team-raiju/fujin/README.md

# Fujin

Fujin is a micromouse robot. This repository contains everything related to the project, see the respective folders for more information.
