team-raiju/fujin/.docs/bsp.png

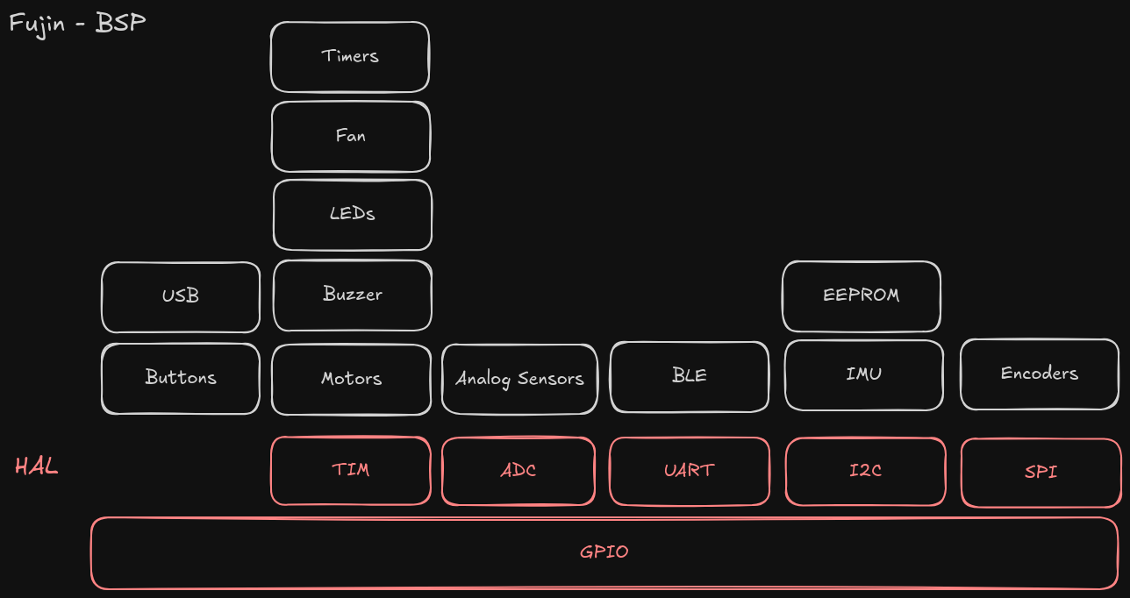
.docs/bsp.png
