team-raiju/fujin/boards/Fujin_Encoder/Fujin_Encoder.step

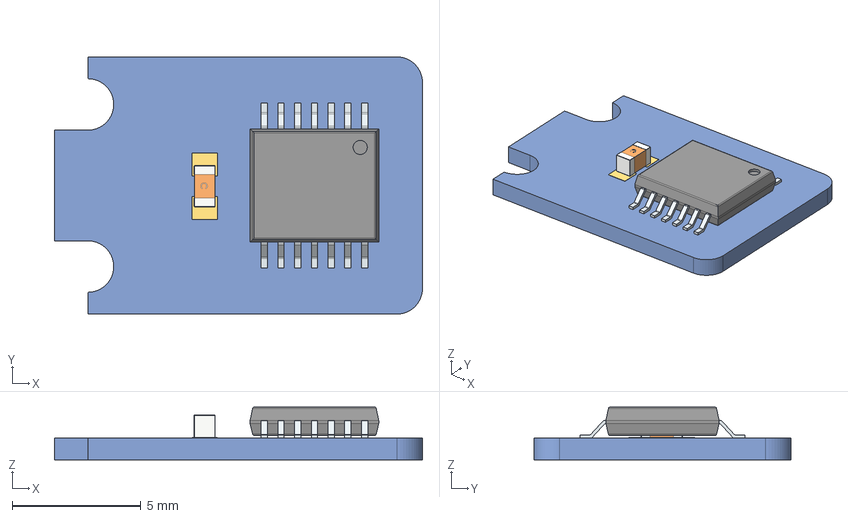
[picture p2: CAD file, 2024-06-20]
boards/Fujin_Encoder/Fujin_Encoder.step
14.3 x 10.0 x 2.05 mm
PinsArrayLR
User_Library-cap0603_pad_0603_??
User_Library-cap0603_cap0603_body(2)_??
