team-raiju/fujin/boards/Fujin_V1/Fujin_Body_4.DXF

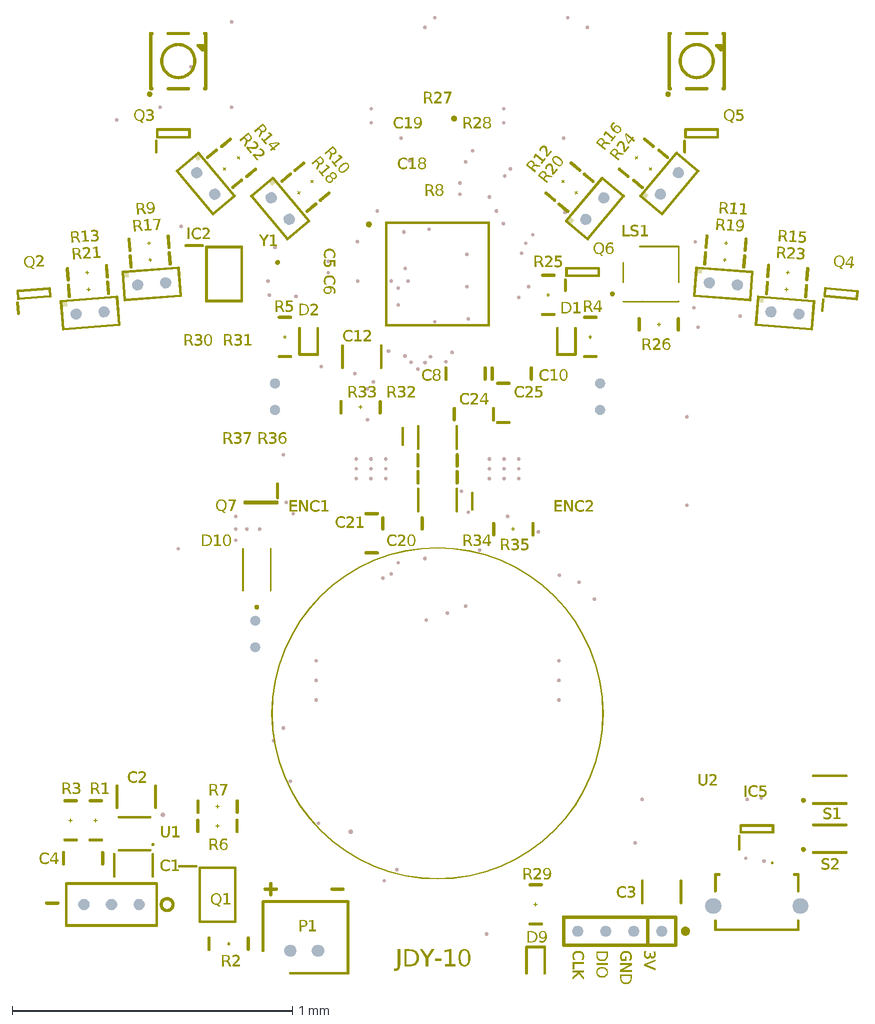
[picture p3: CAD file, 2024-06-19]
boards/Fujin_V1/Fujin_Body_4.DXF
ENC2
ENC1
3V
GND
DIO
CLK
R21
LS1
D10
P1
D2
D1
Y1
JDY-10
U2
U1
S2
S1
R37
R36
R35
R34
R33
R32
R31
R30
R29
R28
R27
R26
R25
R24
R23
R22
R20
R19
R18
R17
R16
R15
R14
R13
R12
R11
R10
R9
R8
R7
R6
R5
R4
R3
R2
R1
Q7
Q6
Q5
Q4
Q3
Q2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
