team-raiju/fujin/(list of files, cad)

Other CAD files:
boards/Fujin_V1/Fujin_Body.DWG
boards/Fujin_V1/Fujin_Body_2.DWG
