team-raiju/fujin/.agents/rules/compile-guide.md

---
trigger: always_on
---

# Compilation Instructions

```bash
cd firmware
cmake --preset STM32G474
cmake --build build/STM32G474
```
