team-raiju/fujin/firmware/.agents/rules/compile-guide.md

---
trigger: always_on
---

# Compilation Instructions

```bash
cmake --preset STM32G474
cmake --build build/STM32G474
```

You don't need to compile for target-pc
