team-raiju/fujin/boards/Fujin_V1/Fujin_EasyEDA_V1.pdf

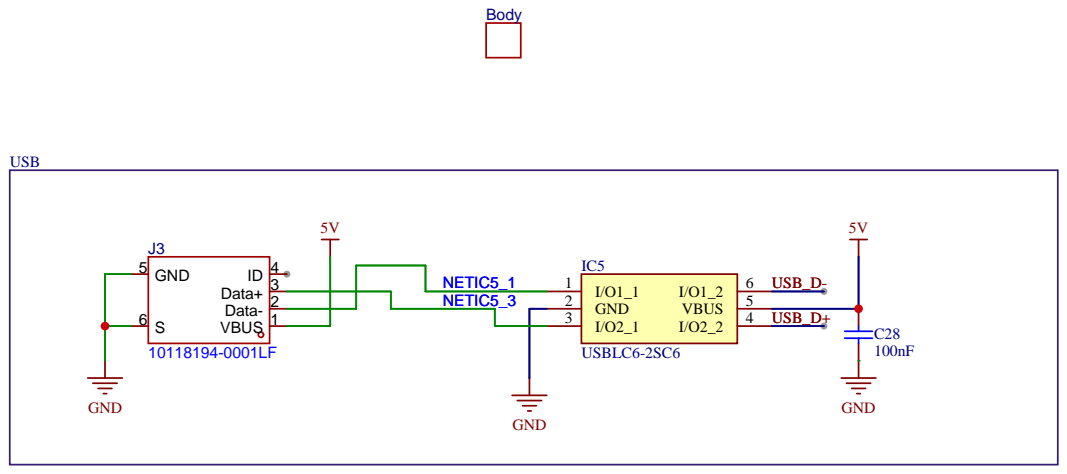
[picture p4: page 1]

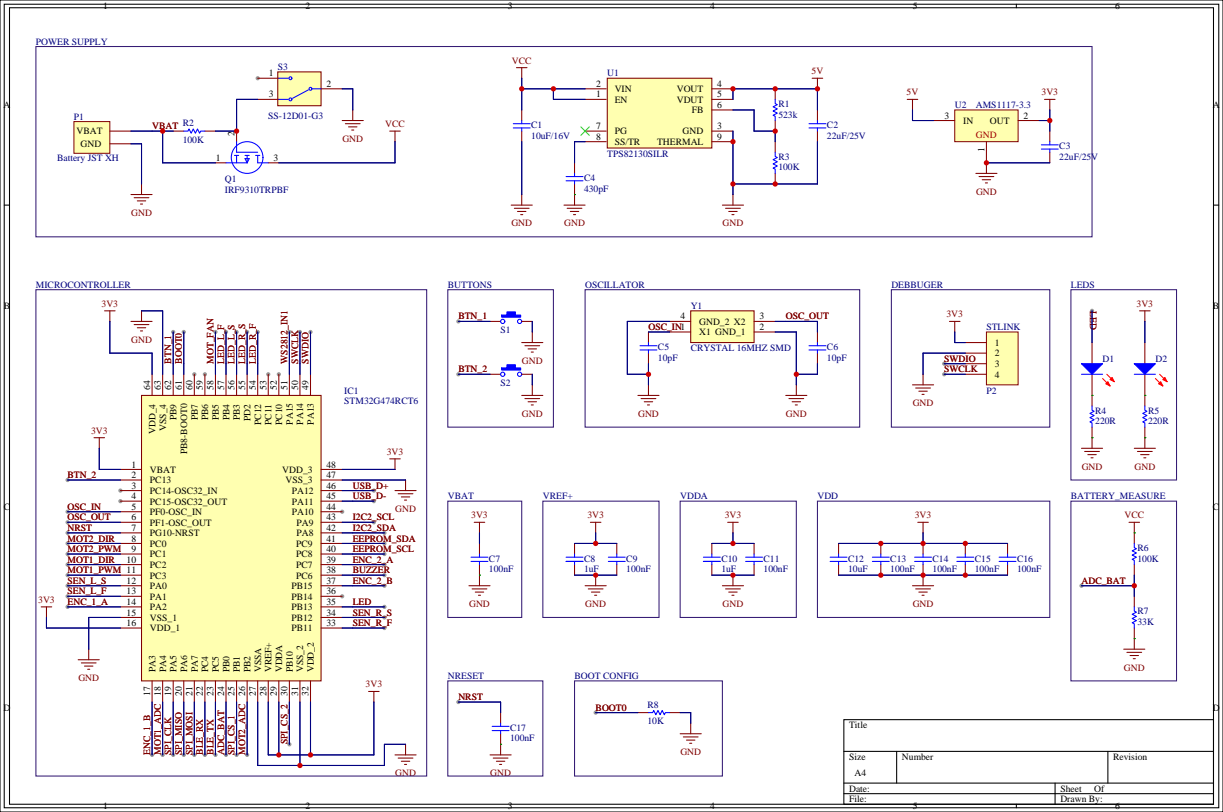
[picture p5: page 2]

# Motor Connector 12

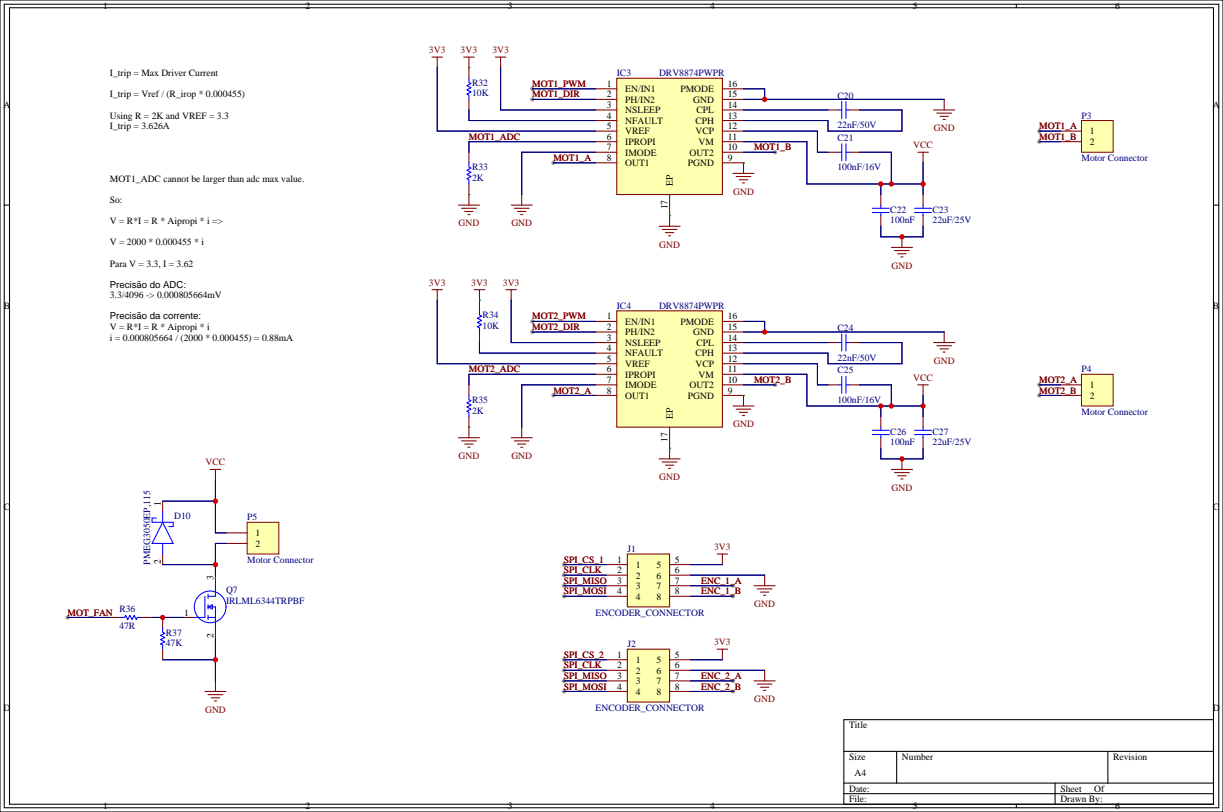
[picture p6: page 3]

MOT1_ADC cannot be larger than adc max value.

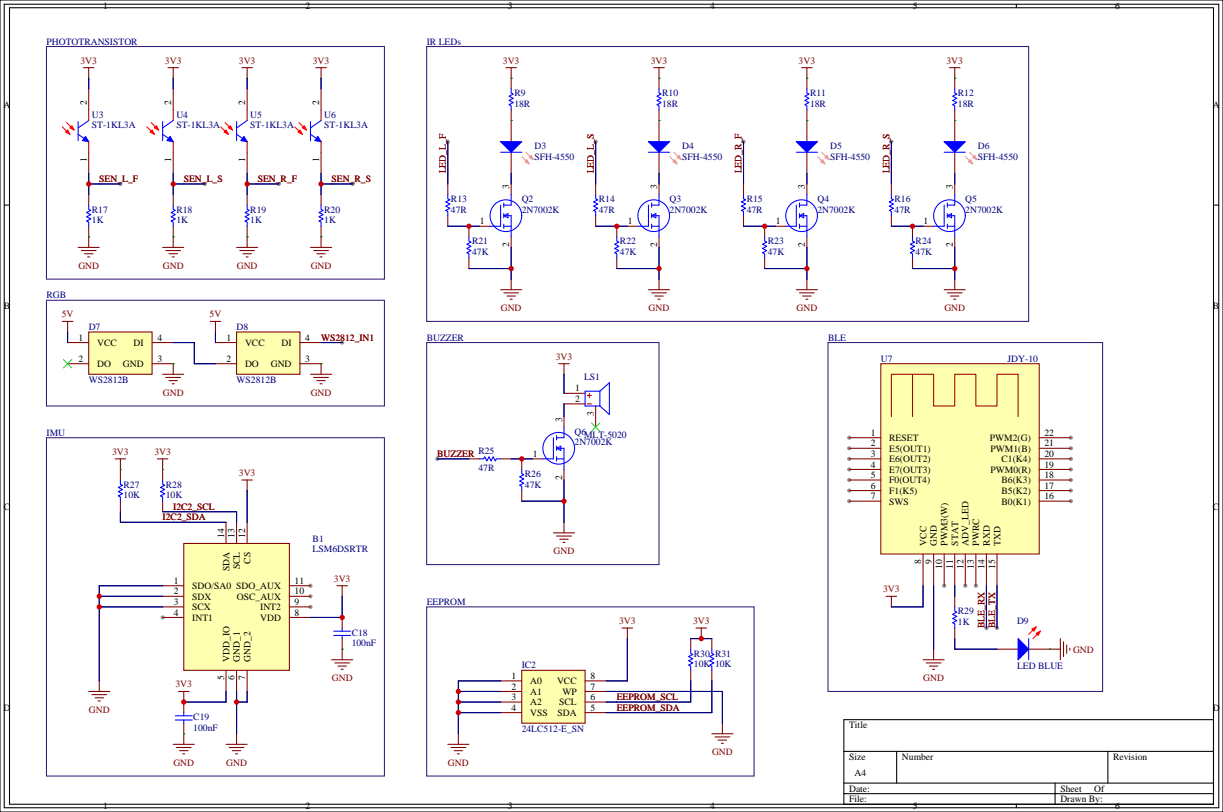
[picture p7: page 4]
