team-raiju/fujin/(list of files, drawings)

Other design files:
boards/Fujin_Encoder/EncoderLib.PcbLib
boards/Fujin_Encoder/EncoderLib.SchLib
boards/Fujin_Encoder/Fujin_Encoder.PcbDoc
boards/Fujin_Encoder/Fujin_Encoder.PrjPcb
boards/Fujin_Encoder/Fujin_Encoder.SchDoc
boards/Fujin_V1/Fujin_Body.PcbDoc
boards/Fujin_V1/Fujin_Connectors.SchDoc
boards/Fujin_V1/Fujin_Main.SchDoc
boards/Fujin_V1/Fujin_Motors.SchDoc
boards/Fujin_V1/Fujin_Peripherals.SchDoc
boards/Fujin_V1/Fujin_V1.PrjPcb
boards/Fujin_V1/FujinLib.SchLib
