team-raiju/fujin/firmware/cube/fujin.ioc

Mcu.UserName=STM32G474RCTx
PA0.Signal=ADC1_IN1
PA1.Signal=ADC1_IN2
PA11.Signal=USB_DM
PA12.Signal=USB_DP
PA13.Signal=SYS_JTMS-SWDIO
PA14.Signal=SYS_JTCK-SWCLK
PA15.Signal=S_TIM2_CH1
PA2.Signal=GPXTI2
PA3.Signal=GPIO_Input
PA4.Signal=ADC2_IN17
PA5.Signal=SPI1_SCK
PA6.Signal=SPI1_MISO
PA7.Signal=SPI1_MOSI
PA8.Signal=I2C2_SDA
PA9.Signal=I2C2_SCL
PB0.Signal=ADC1_IN15
PB1.Signal=GPIO_Output
PB10.Signal=GPIO_Output
PB11.Signal=ADC1_IN14
PB12.Signal=ADC1_IN11
PB13.Signal=GPIO_Output
PB15.Signal=GPIO_Input
PB2.Signal=ADC2_IN12
PB3.Signal=GPIO_Output
PB4.Signal=GPIO_Output
PB5.Signal=S_TIM3_CH2
PB9.Signal=GPXTI9
PC0.Signal=GPIO_Output
PC1.Signal=S_TIM1_CH2
PC12.Signal=GPIO_Output
PC13.Signal=GPXTI13
PC2.Signal=GPIO_Output
PC3.Signal=S_TIM1_CH4
PC4.Signal=USART1_TX
PC5.Signal=USART1_RX
PC6.Signal=S_TIM8_CH1
PC7.Signal=GPXTI7
PC8.Signal=I2C3_SCL
PC9.Signal=I2C3_SDA
PD2.Signal=GPIO_Output
PF0-OSC_IN.Signal=RCC_OSC_IN
PF1-OSC_OUT.Signal=RCC_OSC_OUT
