team-raiju/fujin/firmware/src/services/control.cpp

#include <algorithm>
#include <cstdio>

#include "bsp/analog_sensors.hpp"
#include "bsp/encoders.hpp"
#include "bsp/fan.hpp"
#include "bsp/imu.hpp"
#include "bsp/motors.hpp"
#include "bsp/timers.hpp"
#include "services/config.hpp"
#include "services/control.hpp"

#ifndef COMPETITION_MODE
#define COMPETITION_MODE 0
#endif

#if COMPETITION_MODE
static constexpr float MAX_LINEAR_SPEED_ERROR = 1.0f;
static constexpr float MAX_ANGULAR_SPEED_ERROR = 12.0f;
#else
static constexpr float MAX_LINEAR_SPEED_ERROR = 0.8f;
static constexpr float MAX_ANGULAR_SPEED_ERROR = 10.0f;
#endif

static constexpr float max_battery_voltage = 12.6;
static constexpr float mot_kt = 0.0064;                // motor torque constant [Nm/A]
static constexpr float mot_ra = 2.5;                   // armature resistance[Ohms]
static constexpr float max_linear_accel_ff = 50.0f;    // max linear acceleration for feedforward [m/s^2]
static constexpr float max_angular_accel_ff = 2000.0f; // max angular acceleration for feedforward [rad/s^2]

namespace services {

Control* Control::instance() {
    static Control p;
    return &p;
}

void Control::init(void) {
    GeneralParams general_params = {
        services::Config::fan_speed,
        services::Config::angular_kp,
        services::Config::angular_ki,
        services::Config::angular_kd,
        services::Config::angular_acc_feed_forward_k,
        services::Config::angular_brake_feed_forward_k,
        services::Config::angular_vel_feed_forward_k,
        services::Config::linear_vel_acc_feed_forward_k,
        services::Config::linear_vel_brake_feed_forward_k,
        services::Config::linear_vel_feed_forward_k,
        services::Config::wall_kp,
        services::Config::wall_ki,
        services::Config::wall_kd,
        services::Config::linear_vel_kp,
        services::Config::linear_vel_ki,
        services::Config::linear_vel_kd,
        services::Config::diagonal_walls_kp,
        services::Config::diagonal_walls_ki,
        services::Config::diagonal_walls_kd,
        services::Config::start_wall_break_mm_left,
        services::Config::start_wall_break_mm_right,
        services::Config::enable_wall_break_correction,
        services::Config::max_linear_acc_jerk,
        services::Config::max_linear_brake_jerk,
        services::Config::wheel_radius_mm,
        services::Config::coulomb_ff,
        services::Config::angular_coulomb_ff,
        services::Config::angular_static_ff,
        services::Config::angular_coulomb_ff_inplace,
        services::Config::angular_static_ff_inplace,
        services::Config::linear_accel_margin_mm,
        services::Config::linear_brake_margin_mm,
        services::Config::sensor_r_slope_max_th,
        services::Config::sensor_l_slope_max_th,
        services::Config::ir_wall_detect_th_left,
        services::Config::ir_wall_detect_th_right,
        services::Config::enable_lateral_correction_90,
        services::Config::enable_lateral_correction_wall,
    };
    reset(general_params);
}

void Control::reset(GeneralParams general_params) {
    params = general_params;

    linear_vel_pid.reset();
    linear_vel_pid.kp = params.linear_vel_kp;
    linear_vel_pid.ki = params.linear_vel_ki;
    linear_vel_pid.kd = params.linear_vel_kd;
    linear_vel_pid.integral_limit = 100;
    linear_vel_pid.derivative_filter = 0.15f;

    angular_vel_pid.reset();
    angular_vel_pid.kp = params.angular_kp;
    angular_vel_pid.ki = params.angular_ki;
    angular_vel_pid.kd = params.angular_kd;
    angular_vel_pid.integral_limit = 500;
    angular_vel_pid.derivative_filter = 0.15f;

    walls_pid.reset();
    walls_pid.kp = params.wall_kp;
    walls_pid.ki = params.wall_ki;
    walls_pid.kd = params.wall_kd;
    walls_pid.integral_limit = 0;
    walls_pid.derivative_filter = 1.0f;

    diagonal_walls_pid.reset();
    diagonal_walls_pid.kp = params.diagonal_walls_kp;
    diagonal_walls_pid.ki = params.diagonal_walls_ki;
    diagonal_walls_pid.kd = params.diagonal_walls_kd;
    diagonal_walls_pid.integral_limit = 0;
    diagonal_walls_pid.derivative_filter = 1.0f;

    target_angular_speed_rad_s = 0;
    last_target_angular_speed_rad_s = 0;
    target_linear_speed_m_s = 0;
    last_target_linear_speed_m_s = 0;
    target_linear_acceleration = 0.0f;
    last_target_linear_acceleration = 0.0f;
    target_angular_acceleration = 0.0f;
    last_target_angular_acceleration = 0.0f;
    rotation_ff = 0.0f;
    fan_pwm = 0.0f;

    motor_control_disabled = false;
    emergency = false;
    use_inplace_friction = false;
    wall_pid_enabled = false;
    diagonal_pid_enabled = false;
}

void Control::update() {

    float bat_volts = bsp::analog_sensors::battery_latest_reading_volts();

    if (motor_control_disabled) {
        bsp::motors::set(0, 0);
        pwm_duty_l = 0.0f;
        pwm_duty_r = 0.0f;
        rotation_ff = 0.0f;
        linear_ff = 0.0f;
        linear_vel_pid.reset();
        angular_vel_pid.reset();
        last_target_angular_speed_rad_s = target_angular_speed_rad_s;
        last_target_linear_speed_m_s = target_linear_speed_m_s;
        target_linear_acceleration = 0.0f;
        last_target_linear_acceleration = 0.0f;
        target_angular_acceleration = 0.0f;
        last_target_angular_acceleration = 0.0f;
    } else {
        float mean_velocity_m_s = bsp::encoders::get_filtered_velocity_m_s();
        auto angular_speed_error_raw = std::abs(target_angular_speed_rad_s - bsp::imu::get_rad_per_s());
        auto linear_speed_error = std::abs(target_linear_speed_m_s - mean_velocity_m_s);
        emergency =
            ((linear_speed_error > MAX_LINEAR_SPEED_ERROR) || (angular_speed_error_raw > MAX_ANGULAR_SPEED_ERROR));

        if (wall_pid_enabled) {
            const float max_wall_ang_accel = (params.fan_speed > 0) ? 500.0f : 150.0f; // rad/s^2
            const float max_step = max_wall_ang_accel / Config::CONTROL_FREQUENCY_HZ;

            target_angular_speed_rad_s += walls_pid.calculate(0.0f, bsp::analog_sensors::ir_side_wall_error());
            target_angular_speed_rad_s =
                std::clamp(target_angular_speed_rad_s, (last_target_angular_speed_rad_s - max_step),
                           (last_target_angular_speed_rad_s + max_step));
        }

        if (diagonal_pid_enabled) {
            target_angular_speed_rad_s += diagonal_walls_pid.calculate(0.0, bsp::analog_sensors::ir_diagonal_error());
        }

        float linear_ratio = linear_vel_pid.calculate(target_linear_speed_m_s, mean_velocity_m_s);
        float rotation_ratio = -angular_vel_pid.calculate(target_angular_speed_rad_s, bsp::imu::get_rad_per_s());

        // Angular Feed-Foward
        target_angular_acceleration =
            (target_angular_speed_rad_s - last_target_angular_speed_rad_s) * Config::CONTROL_FREQUENCY_HZ;
        target_angular_acceleration =
            std::clamp(target_angular_acceleration, -max_angular_accel_ff, max_angular_accel_ff);

        last_target_angular_acceleration = target_angular_acceleration;

        bool is_accelerating = (target_angular_speed_rad_s * target_angular_acceleration) > 0.0f;
        float dir = (target_angular_speed_rad_s > 0.0f) ? 1.0f : -1.0f;

        if (is_accelerating) {
            rotation_ff = target_angular_acceleration * params.angular_acc_feed_forward_k;
        } else {
            rotation_ff = target_angular_acceleration * params.angular_brake_feed_forward_k;
        }
        rotation_ff += target_angular_speed_rad_s * params.angular_vel_feed_forward_k;

        // Friction feedforward: in-place vs rolling (only enabled when not fixing walls, e.g. during turns)
        if (!wall_pid_enabled && !diagonal_pid_enabled) {
            const float static_ff = (use_inplace_friction && params.angular_static_ff_inplace > 0.0f)
                                        ? params.angular_static_ff_inplace
                                        : params.angular_static_ff;
            const float coulomb_ff = (use_inplace_friction && params.angular_coulomb_ff_inplace > 0.0f)
                                         ? params.angular_coulomb_ff_inplace
                                         : params.angular_coulomb_ff;

            // Static friction
            if (is_accelerating && std::abs(bsp::imu::get_rad_per_s()) < 0.4f &&
                std::abs(target_angular_acceleration) > 0.1f) {
                rotation_ff += static_ff * dir;
            } // Dynamic friction
            else if (std::abs(target_angular_speed_rad_s) > 0.005f) {
                rotation_ff += coulomb_ff * dir;
            }
        }

        last_target_angular_speed_rad_s = target_angular_speed_rad_s;

        // Linear Feed-Foward
        if (std::abs(target_linear_speed_m_s) <= 0.001f) {
            target_linear_acceleration = 0.0f;
            linear_ff = 0.0f;
        } else {
            target_linear_acceleration =
                (target_linear_speed_m_s - last_target_linear_speed_m_s) * Config::CONTROL_FREQUENCY_HZ;
            target_linear_acceleration =
                std::clamp(target_linear_acceleration, -max_linear_accel_ff, max_linear_accel_ff);

            if (target_linear_acceleration >= 0.0f) {
                linear_ff = target_linear_acceleration * params.linear_vel_acc_feed_forward_k;
            } else {
                linear_ff = target_linear_acceleration * params.linear_vel_brake_feed_forward_k;
            }

            // Coulomb ff
            float direction = (target_linear_speed_m_s > 0.0f) ? 1.0f : -1.0f;
            linear_ff += params.coulomb_ff * direction;

            linear_ff += target_linear_speed_m_s * params.linear_vel_feed_forward_k;
        }

        last_target_linear_acceleration = target_linear_acceleration;
        last_target_linear_speed_m_s = target_linear_speed_m_s;

        // Control
        float l_current = (linear_ratio + linear_ff) + (rotation_ratio - rotation_ff);
        float r_current = (linear_ratio + linear_ff) - (rotation_ratio - rotation_ff);

        float left_ang_vel = bsp::encoders::get_left_filtered_ang_vel_rad_s();
        float right_ang_vel = bsp::encoders::get_right_filtered_ang_vel_rad_s();

        pwm_duty_l = ((l_current * mot_ra + left_ang_vel * mot_kt) / bat_volts) * 1000;
        pwm_duty_r = ((r_current * mot_ra + right_ang_vel * mot_kt) / bat_volts) * 1000;

        std::tie(pwm_duty_l, pwm_duty_r) = clamp_pwms(pwm_duty_l, pwm_duty_r);

        bsp::motors::set(pwm_duty_l, pwm_duty_r);
    }

    fan_control_update(bat_volts);
}

std::pair<int16_t, int16_t> Control::clamp_pwms(int16_t pwm_l, int16_t pwm_r) {
    if (pwm_l > bsp::motors::COUNTER_PERIOD_MAX || pwm_r > bsp::motors::COUNTER_PERIOD_MAX) {
        uint32_t abs_diff = std::abs(pwm_l - pwm_r);
        abs_diff = std::min(abs_diff, static_cast<uint32_t>(2.0 * bsp::motors::COUNTER_PERIOD_MAX));
        if (pwm_l > pwm_r) {
            pwm_l = bsp::motors::COUNTER_PERIOD_MAX;
            pwm_r = bsp::motors::COUNTER_PERIOD_MAX - abs_diff;
        } else {
            pwm_l = bsp::motors::COUNTER_PERIOD_MAX - abs_diff;
            pwm_r = bsp::motors::COUNTER_PERIOD_MAX;
        }
    }

    if (pwm_l < -bsp::motors::COUNTER_PERIOD_MAX || pwm_r < -bsp::motors::COUNTER_PERIOD_MAX) {
        uint32_t abs_diff = std::abs(pwm_l - pwm_r);
        abs_diff = std::min(abs_diff, static_cast<uint32_t>(2.0 * bsp::motors::COUNTER_PERIOD_MAX));

        if (pwm_l < pwm_r) {
            pwm_l = -bsp::motors::COUNTER_PERIOD_MAX;
            pwm_r = -bsp::motors::COUNTER_PERIOD_MAX + abs_diff;
        } else {
            pwm_l = -bsp::motors::COUNTER_PERIOD_MAX + abs_diff;
            pwm_r = -bsp::motors::COUNTER_PERIOD_MAX;
        }
    }

    return {pwm_l, pwm_r};
}

void Control::fan_control_update(float bat_volts) {

    float target_fan_speed = std::min(params.fan_speed, static_cast<float>(bsp::fan::MAX_SPEED));
    float desired_fan_voltage =
        (target_fan_speed / static_cast<float>(bsp::fan::MAX_SPEED)) * bsp::fan::get_max_fan_voltage();

    if (bat_volts > 5.0) { // To avoid turning on fan when battery measurement is not reliable
        fan_pwm = (desired_fan_voltage / bat_volts) * bsp::fan::MAX_SPEED;
    } else {
        fan_pwm = 0;
    }
    bsp::fan::set(fan_pwm);
}

void Control::start_fan() {
    float target_fan_speed = std::min(params.fan_speed, static_cast<float>(bsp::fan::MAX_SPEED));
    float desired_fan_voltage =
        (target_fan_speed / static_cast<float>(bsp::fan::MAX_SPEED)) * bsp::fan::get_max_fan_voltage();

    for (float volts = 0; volts < desired_fan_voltage; volts += 0.1) {
        float bat_volts = bsp::analog_sensors::battery_latest_reading_volts();
        if (bat_volts < 5.0) {
            std::printf("Low battery: %f V\r\n", bat_volts);
            bsp::fan::set(0);
            break;
        }
        fan_pwm = (volts / bat_volts) * bsp::fan::MAX_SPEED;
        std::printf("volts: %f, bat: %f, pwm: %d\r\n", volts, bat_volts, fan_pwm);
        bsp::fan::set(fan_pwm);
        bsp::delay_ms(20);
    }
}

void Control::stop_fan() {
    float target_fan_speed = std::min(params.fan_speed, static_cast<float>(bsp::fan::MAX_SPEED));
    float desired_fan_voltage =
        (target_fan_speed / static_cast<float>(bsp::fan::MAX_SPEED)) * bsp::fan::get_max_fan_voltage();
    for (float volts = desired_fan_voltage; volts > 0; volts -= 0.1) {
        float bat_volts = bsp::analog_sensors::battery_latest_reading_volts();
        if (bat_volts < 5.0) {
            bsp::fan::set(0);
            break;
        }
        fan_pwm = (volts / bat_volts) * bsp::fan::MAX_SPEED;
        bsp::fan::set(fan_pwm);
        bsp::delay_ms(20);
    }
    bsp::fan::set(0);
}

}
