team-raiju/fujin/firmware/src/bsp/target-stm32g474/encoders.cpp

#include <algorithm>
#include "st/hal.h"

#include "bsp/encoders.hpp"
#include "bsp/timers.hpp"
#include "pin_mapping.h"
#include "services/config.hpp"

namespace bsp::encoders {

// Min measured vel is ENCODER_DIST_MM_PULSE / 10 = 0.00776 m/s
static constexpr uint32_t MAX_TIME_WITHOUT_ENCODER_US = 10000;

static constexpr float WHEEL_TO_ENCODER_RATIO = (1.0);
static constexpr float ENCODER_PPR = (1024.0);
static constexpr float PULSES_PER_WHEEL_ROTATION = (WHEEL_TO_ENCODER_RATIO * ENCODER_PPR);


static float linear_velocity_m_s;
static float wheel_radius_mm = 13.25f;

static float filtered_velocity_m_s;
static float last_velocity_m_s;

static float right_filtered_ang_vel_rad_s;
static float left_filtered_ang_vel_rad_s;

static uint32_t last_update_vel_time;
static uint32_t delta_vel_time;

static EncoderData left_encoder;
static EncoderData right_encoder;

static float estimated_vel_m_s = 0.0f;
static float accel_bias_m_s2 = 0.0f;


/// @section Private implementation


// Hybrid alpha-beta filter with target acceleration feedforward + EMA post-filter
static inline float update_velocity_filter(float raw_vel_m_s, float target_accel_m_s2) {
    constexpr float alpha_vel_gain = 0.030f;
    constexpr float beta_acc_gain = 0.2000f;
    constexpr float smooth_factor = 0.30f;
    constexpr float bias_decay = 0.995f;
    constexpr float max_accel_bias = 10.0f;

    float predicted_accel = target_accel_m_s2 + accel_bias_m_s2;
    float predicted_vel = estimated_vel_m_s + predicted_accel * services::Config::CONTROL_PERIOD_S;
    float vel_estimated_error = raw_vel_m_s - predicted_vel;

    estimated_vel_m_s = predicted_vel + alpha_vel_gain * vel_estimated_error;
    accel_bias_m_s2 = std::clamp((accel_bias_m_s2 + beta_acc_gain * vel_estimated_error) * bias_decay,
                                 -max_accel_bias, max_accel_bias);

    // Post filter (EMA) 
    // filtered_velocity_m_s = (smooth_factor * estimated_vel_m_s) + (1 - smooth_factor) * filtered_velocity_m_s => equivalent to;
    filtered_velocity_m_s += smooth_factor * (estimated_vel_m_s - filtered_velocity_m_s);
    return filtered_velocity_m_s;
}


/// @section Interface implementation

void init() {
    reset();
}

void reset() {
    left_encoder = {0, DirectionType::CW, 0, MAX_TIME_WITHOUT_ENCODER_US + 1, 0, 0};
    right_encoder = {0, DirectionType::CW, 0, MAX_TIME_WITHOUT_ENCODER_US + 1, 0, 0};
    reset_velocities();
}

void clear_ticks() {
    left_encoder.ticks = 0;
    right_encoder.ticks = 0;
}

EncoderData get_data(EncoderSide side) {
    return side == LEFT ? left_encoder : right_encoder;
}

void gpio_exti_callback(uint16_t GPIO_Pin) {
    uint32_t current_time_us = bsp::get_tick_us();

    if (GPIO_Pin == ENCODER_LEFT_A_PIN) {

        left_encoder.last_delta_tick_time = current_time_us - left_encoder.last_update_tick_time;
        left_encoder.last_update_tick_time = current_time_us;
        left_encoder.direction = HAL_GPIO_ReadPin(ENCODER_LEFT_B_PORT, ENCODER_LEFT_B_PIN) == GPIO_PIN_SET ? CCW : CW;
        left_encoder.ticks = left_encoder.direction == CW ? left_encoder.ticks - 1 : left_encoder.ticks + 1;

    } else if (GPIO_Pin == ENCODER_RIGHT_A_PIN) {

        right_encoder.last_delta_tick_time = current_time_us - right_encoder.last_update_tick_time;
        right_encoder.last_update_tick_time = current_time_us;
        right_encoder.direction =
            HAL_GPIO_ReadPin(ENCODER_RIGHT_B_PORT, ENCODER_RIGHT_B_PIN) == GPIO_PIN_SET ? CW : CCW;
        right_encoder.ticks = right_encoder.direction == CW ? right_encoder.ticks - 1 : right_encoder.ticks + 1;
    }
}

void update_ticks() {}

void reset_velocities() {
    linear_velocity_m_s = 0;
    filtered_velocity_m_s = 0;
    last_velocity_m_s = 0;
    right_filtered_ang_vel_rad_s = 0;
    left_filtered_ang_vel_rad_s = 0;
    last_update_vel_time = 0;
    delta_vel_time = MAX_TIME_WITHOUT_ENCODER_US + 1;

    estimated_vel_m_s = 0.0f;
    accel_bias_m_s2 = 0.0f;

}

void set_right_ang_vel_rad_s(float speed) {
    right_encoder.ang_vel_rad_s = speed;
    right_filtered_ang_vel_rad_s = speed * 0.1 + right_filtered_ang_vel_rad_s * 0.9;
}

void set_left_ang_vel_rad_s(float speed) {
    left_encoder.ang_vel_rad_s = speed;
    left_filtered_ang_vel_rad_s = speed * 0.1 + left_filtered_ang_vel_rad_s * 0.9;
}

void update_velocities(float target_accel_m_s2) {

    delta_vel_time = bsp::get_tick_us() - last_update_vel_time;
    last_update_vel_time = bsp::get_tick_us();

    if (left_encoder.last_delta_tick_time == 0 || right_encoder.last_delta_tick_time == 0) {
        return;
    }

    uint32_t delta_time_tick_left = bsp::get_tick_us() - left_encoder.last_update_tick_time;
    uint32_t delta_time_tick_right = bsp::get_tick_us() - right_encoder.last_update_tick_time;

    float encoder_dist_mm_pulse = get_encoder_dist_mm_pulse();
    float wheel_radius_m = wheel_radius_mm / 1000.0f;

    /* Left wheel */
    if (delta_time_tick_left > MAX_TIME_WITHOUT_ENCODER_US) {
        left_encoder.linear_vel_m_s = 0;
    } else {
        int32_t ticks = left_encoder.ticks;
        if (ticks == 0) { // No tick detected in the last delta_vel_time (e.g 1ms)
            left_encoder.linear_vel_m_s = 0;
        } else {
            left_encoder.linear_vel_m_s = ((ticks * encoder_dist_mm_pulse) / (float)delta_vel_time) * MM_PER_US_TO_M_PER_S;
        }
        
    }

    /* Right wheel */
    if (delta_time_tick_right > MAX_TIME_WITHOUT_ENCODER_US) {
        right_encoder.linear_vel_m_s = 0;
    } else {
        int32_t ticks = right_encoder.ticks;
        if (ticks == 0) { // No tick detected in the last delta_vel_time (e.g 1ms)
            right_encoder.linear_vel_m_s = 0;
        } else {
            right_encoder.linear_vel_m_s = ((ticks * encoder_dist_mm_pulse) / (float)delta_vel_time) * MM_PER_US_TO_M_PER_S;
        }

    }

    set_left_ang_vel_rad_s(left_encoder.linear_vel_m_s / wheel_radius_m);
    set_right_ang_vel_rad_s(right_encoder.linear_vel_m_s / wheel_radius_m);

    linear_velocity_m_s = (left_encoder.linear_vel_m_s + right_encoder.linear_vel_m_s) / 2.0;

    // filtered_velocity_m_s = linear_velocity_m_s * 0.051 + filtered_velocity_m_s * 0.949; // Simple Filter
    filtered_velocity_m_s = update_velocity_filter(linear_velocity_m_s, target_accel_m_s2);
    last_velocity_m_s = linear_velocity_m_s;
}

float get_linear_velocity_m_s() {
    return linear_velocity_m_s;
}

float get_left_linear_velocity_m_s() {
    return left_encoder.linear_vel_m_s;
}

float get_right_linear_velocity_m_s() {
    return right_encoder.linear_vel_m_s;
}

float get_filtered_velocity_m_s() {
    return filtered_velocity_m_s;
}

float get_right_filtered_ang_vel_rad_s() {
    return right_filtered_ang_vel_rad_s;
}

float get_left_filtered_ang_vel_rad_s() {
    return left_filtered_ang_vel_rad_s;
}

float get_encoder_dist_mm_pulse() {
    float wheel_perimeter_mm = (M_TWOPI * wheel_radius_mm);
    return (wheel_perimeter_mm / PULSES_PER_WHEEL_ROTATION);
}

void set_wheel_radius_mm(float radius_mm) {
    wheel_radius_mm = radius_mm;
}

float get_wheel_radius_mm() {
    return wheel_radius_mm;
}

}
