team-raiju/fujin/firmware/inc/services/config.hpp

#pragma once

#include "bsp/analog_sensors.hpp"
#include "bsp/ble.hpp"

namespace services {

class Config {
public:

    static constexpr float CONTROL_FREQUENCY_HZ = 2000.0;
    static constexpr float CONTROL_PERIOD_S = 1.0 / CONTROL_FREQUENCY_HZ;
    static constexpr float TICKS_PER_MS = CONTROL_FREQUENCY_HZ / 1000.0f;
    static constexpr uint16_t ms_to_ticks(float ms) { return static_cast<uint16_t>(ms * TICKS_PER_MS); }
    static constexpr float ticks_to_ms(uint32_t ticks) { return ticks / TICKS_PER_MS; }

    static constexpr float WHEELS_DIST_MM = (70.0);


    static float fan_speed;

    static float angular_kp;
    static float angular_ki;
    static float angular_kd;
    static float angular_acc_feed_forward_k;
    static float angular_brake_feed_forward_k;
    static float angular_vel_feed_forward_k;

    static float linear_vel_acc_feed_forward_k;
    static float linear_vel_brake_feed_forward_k;
    static float linear_vel_feed_forward_k;
    static float max_linear_acc_jerk;
    static float max_linear_brake_jerk;
    static float wheel_radius_mm;
    static float coulomb_ff;
    static float angular_coulomb_ff;
    static float angular_static_ff;
    static float angular_coulomb_ff_inplace;
    static float angular_static_ff_inplace;

    static float wall_kp;
    static float wall_ki;
    static float wall_kd;

    static float linear_vel_kp;
    static float linear_vel_ki;
    static float linear_vel_kd;

    static float diagonal_walls_kp;
    static float diagonal_walls_ki;
    static float diagonal_walls_kd;

    static float min_move_speed;

    static float ir_wall_dist_ref_left;
    static float ir_wall_dist_ref_right;
    static float ir_wall_detect_th_left;
    static float ir_wall_detect_th_right;

    static float ir_diagonal_ref_fl;
    static float ir_diagonal_ref_fr;
    static float ir_diagonal_control_th_fl;
    static float ir_diagonal_control_th_fr;

    static float sensor_r_slope_max_th;
    static float sensor_l_slope_max_th;
    static float right_sensor_angle_deg;
    static float left_sensor_angle_deg;

    static float z_imu_bias;

    static float start_wall_break_mm_left;
    static float start_wall_break_mm_right;
    static float enable_wall_break_correction;
    static float enable_lateral_correction_90;
    static float enable_lateral_correction_wall;
    static float linear_accel_margin_mm;
    static float linear_brake_margin_mm;

    static void init();
    static int parse_packet(uint8_t packet[bsp::ble::max_packet_size]);
    static int parse_movement_packet(uint8_t packet[bsp::ble::max_packet_size]);
    static int load_movement_preset(uint8_t preset_id);
    static int load_general_preset(uint8_t preset_id);
    static int parse_move_sequence_packet(uint8_t packet[bsp::ble::max_packet_size]);
    static int write_default_params();
    static int save_general_params_to_eeprom();
    static int write_all_move_params_to_eeprom();
    static int write_turn_param_to_eeprom(Movement movement_id);
    static int write_forward_param_to_eeprom(Movement movement_id);
    static void send_parameters();
    static void print_parameters();
    static void send_movement_parameters();
    static void send_move_sequence();
    static int save_z_bias();
    static void load_custom_movements_from_eeprom();
    static void load_movement_sequence_from_eeprom();
    static void load_ir_calib_from_eeprom();
    static int save_ir_calib_to_eeprom(bsp::analog_sensors::SensingDirection direction);
    static int save_all_ir_calib_to_eeprom();
    static void load_ir_wall_patterns_from_eeprom();
    static int save_ir_wall_pattern_to_eeprom(uint8_t pattern_idx);
    static int save_all_ir_wall_patterns_to_eeprom();
    static int reset_ir_wall_patterns_in_eeprom();
};

}
