team-raiju/fujin/firmware/src/bsp/target-stm32g474/analog_sensors.cpp

#include <algorithm>
#include <cmath>
#include <cstring>

#include "st/hal.h"

#include "bsp/analog_sensors.hpp"
#include "bsp/leds.hpp"
#include "bsp/timers.hpp"
#include "services/config.hpp"
#include "utils/math.hpp"

namespace bsp::analog_sensors {

namespace {

/*
 * Battery Sensor - ADC1 CH15
 * Phototransistors - ADC1 CH 1, 2, 11, 14
 * Current Sensors - ADC2 CH 12, 17
 */

/// @section Constants

/* With ADC clock = PCLK/4 (42.5 MHz), 5 channels, and 24.5 sample cycles (37 cycles/conv):
 * - 1 conversion: 37 / 42.5 MHz = 0.87 us
 * - 1 scan (5 ch): 185 / 42.5 MHz = 4.35 us
 * - Half-buffer (22 scans): 22 * 4.35 us = ~95.8 us per DMA interrupt (phase duration)
 * - Full 5-phase modulation cycle (OFF + 4 individual ON): 5 * 95.8 us = ~479 us (~2.09 kHz <= 500 us)
 * - EMA filter (alpha = 0.5): group delay = 1 * 479 us = ~479 us (90% settling: ~1.59 ms)
 */
constexpr uint16_t ADC_1_DMA_CHANNELS = 5;
constexpr uint16_t READINGS_PER_ADC_1 = 44;
constexpr uint16_t ADC_1_DMA_BUFFER_SIZE = ADC_1_DMA_CHANNELS * READINGS_PER_ADC_1;
constexpr uint16_t ADC_1_DMA_HALF_BUFFER_SIZE = ADC_1_DMA_BUFFER_SIZE / 2;

/* With these settings and ADC clock = CLK/4 and sample cycles = 24.5*/
/* We have 1 sample per 28us*/
constexpr uint16_t ADC_2_DMA_CHANNELS = 2;
constexpr uint16_t READINGS_PER_ADC_2 = 32;
constexpr uint16_t ADC_2_DMA_BUFFER_SIZE = ADC_2_DMA_CHANNELS * READINGS_PER_ADC_2;
constexpr uint16_t ADC_2_DMA_HALF_BUFFER_SIZE = ADC_2_DMA_BUFFER_SIZE / 2;

constexpr float ADC_MAX_VALUE = 4095.0f;
constexpr float ADC_MAX_VOLTAGE_MV = 3300.0f;
constexpr float ADC_MAX_VOLTAGE_VOLTS = 3.3f;

constexpr float PWR_BATTERY_THRESHOLD_MV = 11300.0f;

// This value does not give a real battery value, but to change it, means changing the control constants so we will do
// it later
constexpr float PWR_BAT_VOLTAGE_MULTIPLIER = 4.19f; 

// This is the real multiplier measured with a multimeter. TODO: replace above value and change control constantes to be
// multiplied by 11.73%  = (1/(1-0,105))
constexpr float PWR_BAT_VOLTAGE_MULTIPLIER_REAL = 4.63f; 

constexpr float IR_EMA_ALPHA = 0.5f;
constexpr float IR_MAX_DISTANCE_MM = 270.0f;

constexpr float START_SENSOR_DIST_MM = 150.0f;
constexpr float FRONT_SENSOR_SEEING_DIST_MM = 160.0f;

constexpr IrCalibParams default_ir_calib_params[4] = {
    {3970.258981f, 434.914686f, 108.274530f}, // RIGHT
    {5906.861078f, 706.272927f, 267.342336f}, // FRONT_LEFT
    {3934.811769f, 439.237611f, -12.466576f}, // FRONT_RIGHT
    {3715.954588f, 407.345898f, 40.763487f},  // LEFT
};

static IrCalibParams ir_calib_params[4] = {
    {3970.258981f, 434.914686f, 108.274530f},
    {5906.861078f, 706.272927f, 267.342336f},
    {3934.811769f, 439.237611f, -12.466576f},
    {3715.954588f, 407.345898f, 40.763487f},
};

constexpr std::array<SensingPattern, 8> default_ir_wall_patterns = {{
    {170.85f, 155.71f, 141.92f, 174.55f}, // F-L-R
    {170.50f, 152.29f, 146.06f, 270.00f}, // F-L
    {270.00f, 155.64f, 141.08f, 158.25f}, // F-R
    {270.00f, 160.85f, 152.47f, 270.00f}, // F
    {175.98f, 270.00f, 270.00f, 166.89f}, // L-R
    {167.21f, 270.00f, 270.00f, 270.00f}, // L
    {270.00f, 270.00f, 270.00f, 162.26f}, // R
    {270.00f, 270.00f, 270.00f, 270.00f}  // None
}};

static std::array<SensingPattern, 8> ir_wall_patterns = default_ir_wall_patterns;

static constexpr float WALL_HYSTERESIS_DISTANCE_MM = 30.0f;

} // namespace

/// @brief Converts raw ADC value to distance in mm using logarithmic model
/// distance = a / ln(raw + c) - b
float raw_to_distance_mm(SensingDirection direction, uint32_t raw) {
    if (static_cast<uint8_t>(direction) >= 4) {
        return IR_MAX_DISTANCE_MM;
    }
    const auto& params = ir_calib_params[direction];
    float argument = static_cast<float>(raw) + params.c;
    if (argument < 2.0f) {
        argument = 2.0f;
    }
    float distance = (params.a / std::log(argument)) - params.b;
    return std::min(distance, IR_MAX_DISTANCE_MM);
}

IrCalibParams get_calib_params(SensingDirection direction) {
    if (static_cast<uint8_t>(direction) < 4) {
        return ir_calib_params[direction];
    }
    return default_ir_calib_params[0];
}

void set_calib_params(SensingDirection direction, const IrCalibParams& params) {
    if (static_cast<uint8_t>(direction) < 4) {
        ir_calib_params[direction] = params;
    }
}

void reset_calib_params(SensingDirection direction) {
    if (static_cast<uint8_t>(direction) < 4) {
        ir_calib_params[direction] = default_ir_calib_params[direction];
    }
}

void reset_all_calib_params() {
    for (int i = 0; i < 4; i++) {
        ir_calib_params[i] = default_ir_calib_params[i];
    }
}

SensingPattern get_wall_pattern(uint8_t index) {
    if (index < 8) {
        return ir_wall_patterns[index];
    }
    return default_ir_wall_patterns[0];
}

void set_wall_pattern(uint8_t index, const SensingPattern& pattern) {
    if (index < 8) {
        ir_wall_patterns[index] = pattern;
    }
}

void reset_wall_pattern(uint8_t index) {
    if (index < 8) {
        ir_wall_patterns[index] = default_ir_wall_patterns[index];
    }
}

void reset_all_wall_patterns() {
    ir_wall_patterns = default_ir_wall_patterns;
}

const std::array<SensingPattern, 8>& get_all_wall_patterns() {
    return ir_wall_patterns;
}

/// @section Private variables

static uint32_t adc_1_dma_buffer[ADC_1_DMA_BUFFER_SIZE];
static uint32_t adc_2_dma_buffer[ADC_2_DMA_BUFFER_SIZE];
static bsp_analog_ready_callback_t reading_ready_callback;

static uint32_t ir_raw_readings[4];
static float ir_distances[4];
static float ir_slope[4];
static float ir_distance_history[4][3];
static bool ir_slope_initialized[4];
static bool wall_confirmed[4] = {false, false, false, false};
static float wall_dist_accumulated_mm[4] = {0.0f, 0.0f, 0.0f, 0.0f};
static float sensor_r_slope_max_th = 90.0f;
static float sensor_l_slope_max_th = 90.0f;
static float ir_wall_detect_th_left = 240.0f;
static float ir_wall_detect_th_right = 240.0f;
static int32_t ir_raw_readings_on[4];
static int32_t ir_raw_readings_off[4];
static uint32_t battery_reading;
static uint32_t current_reading[2];
static bool modulation_enabled;
static uint8_t mod_step = 0;
static constexpr bsp::leds::Emitter sensor_emitters[4] = {
    bsp::leds::LEFT_SIDE,
    bsp::leds::LEFT_FRONT,
    bsp::leds::RIGHT_FRONT,
    bsp::leds::RIGHT_SIDE,
};

/// @section Interface implementation

void init(void) {
    MX_ADC1_Init();
    HAL_ADCEx_Calibration_Start(&hadc1, ADC_SINGLE_ENDED);

    // Current sensor is not being used for now
    // MAX_ADC2_Init();
    // HAL_ADCEx_Calibration_Start(&hadc2, ADC_SINGLE_ENDED);
}

void start(void) {
    bsp::leds::ir_emitter_all_off();
    mod_step = 0;
    for (int i = 0; i < 4; i++) {
        ir_slope[i] = 0.0f;
        ir_slope_initialized[i] = false;
        wall_confirmed[i] = false;
        wall_dist_accumulated_mm[i] = 0.0f;
    }
    HAL_ADC_Start_DMA(&hadc1, adc_1_dma_buffer, ADC_1_DMA_BUFFER_SIZE);
    // HAL_ADC_Start_DMA(&hadc2, adc_2_dma_buffer, ADC_2_DMA_BUFFER_SIZE);
}

void stop(void) {
    HAL_ADC_Stop_DMA(&hadc1);
    bsp::leds::ir_emitter_all_off();
    mod_step = 0;
    // HAL_ADC_Stop_DMA(&hadc2);
}

void register_callback(bsp_analog_ready_callback_t callback) {
    reading_ready_callback = callback;
}

uint32_t* ir_latest_reading(void) {
    return ir_raw_readings;
}

float* ir_latest_distance(void) {
    return ir_distances;
}

uint32_t battery_latest_reading(void) {
    return battery_reading;
}

float battery_latest_reading_mv(void) {
    float measured_adc_voltage = (battery_reading / ADC_MAX_VALUE) * ADC_MAX_VOLTAGE_MV;
    return measured_adc_voltage * PWR_BAT_VOLTAGE_MULTIPLIER;
}

float battery_latest_reading_volts(void) {
    float measured_adc_voltage = (battery_reading / ADC_MAX_VALUE) * ADC_MAX_VOLTAGE_VOLTS;
    return measured_adc_voltage * PWR_BAT_VOLTAGE_MULTIPLIER;
}

float battery_latest_reading_mv_real(void) {
    float measured_adc_voltage = (battery_reading / ADC_MAX_VALUE) * ADC_MAX_VOLTAGE_MV;
    return measured_adc_voltage * PWR_BAT_VOLTAGE_MULTIPLIER_REAL;
}

float battery_latest_reading_volts_real(void) {
    float measured_adc_voltage = (battery_reading / ADC_MAX_VALUE) * ADC_MAX_VOLTAGE_VOLTS;
    return measured_adc_voltage * PWR_BAT_VOLTAGE_MULTIPLIER_REAL;
}

bool battery_low() {
    return battery_latest_reading_mv_real() <= PWR_BATTERY_THRESHOLD_MV;
}

uint32_t* current_latest_reading(void) {
    return current_reading;
}

float ir_distance_mm(SensingDirection direction) {
    return ir_distances[direction];
}

uint32_t ir_raw_reading(SensingDirection direction) {
    return ir_raw_readings[direction];
}

bool ir_reading_wall(SensingDirection direction) {
    switch (direction) {
    case SensingDirection::RIGHT:
        return ir_distances[direction] < ir_wall_detect_th_right &&
               std::fabs(ir_slope[direction]) < sensor_r_slope_max_th;
    case SensingDirection::FRONT_LEFT:
        return ir_distances[direction] < FRONT_SENSOR_SEEING_DIST_MM;
    case SensingDirection::FRONT_RIGHT:
        return ir_distances[direction] < FRONT_SENSOR_SEEING_DIST_MM;
    case SensingDirection::LEFT:
        return ir_distances[direction] < ir_wall_detect_th_left &&
               std::fabs(ir_slope[direction]) < sensor_l_slope_max_th;
    default:
        return false;
    }
}

bool ir_is_wall_confirmed(SensingDirection direction) {
    const auto index = static_cast<uint8_t>(direction);
    if (index < 4) {
        return wall_confirmed[index];
    }
    return false;
}

bool ir_wall_break_condition(SensingDirection direction) {
    switch (direction) {
    case SensingDirection::RIGHT:
        return ir_distances[direction] > ir_wall_detect_th_right ||
               ir_slope[direction] > sensor_r_slope_max_th;
    case SensingDirection::LEFT:
        return ir_distances[direction] > ir_wall_detect_th_left ||
               ir_slope[direction] > sensor_l_slope_max_th;
    default:
        return false;
    }
}

void ir_update_wall_hysteresis(float delta_traveled_mm) {
    if (delta_traveled_mm <= 0.0f) {
        return;
    }

    const SensingDirection side_directions[2] = {SensingDirection::LEFT, SensingDirection::RIGHT};
    for (const auto dir : side_directions) {
        const auto index = static_cast<uint8_t>(dir);

        if (ir_wall_break_condition(dir)) {
            wall_confirmed[index] = false;
            wall_dist_accumulated_mm[index] = 0.0f;
        } else if (ir_reading_wall(dir)) {
            if (!wall_confirmed[index]) {
                wall_dist_accumulated_mm[index] += delta_traveled_mm;
                if (wall_dist_accumulated_mm[index] >= WALL_HYSTERESIS_DISTANCE_MM) {
                    wall_confirmed[index] = true;
                }
            }
        } else {
            wall_confirmed[index] = false;
            wall_dist_accumulated_mm[index] = 0.0f;
        }
    }
}

void ir_reset_wall_hysteresis(SensingDirection direction) {
    const auto index = static_cast<uint8_t>(direction);
    if (index < 4) {
        wall_confirmed[index] = false;
        wall_dist_accumulated_mm[index] = 0.0f;
    }
}

void ir_reset_all_wall_hysteresis() {
    for (int i = 0; i < 4; i++) {
        wall_confirmed[i] = false;
        wall_dist_accumulated_mm[i] = 0.0f;
    }
}

float ir_slope_value(SensingDirection direction) {
    return ir_slope[direction];
}

void set_sensor_r_slope_max_th(float th) {
    sensor_r_slope_max_th = th;
}

void set_sensor_l_slope_max_th(float th) {
    sensor_l_slope_max_th = th;
}

float get_sensor_r_slope_max_th() {
    return sensor_r_slope_max_th;
}

float get_sensor_l_slope_max_th() {
    return sensor_l_slope_max_th;
}

void set_ir_wall_detect_th_left(float th) {
    ir_wall_detect_th_left = th;
}

void set_ir_wall_detect_th_right(float th) {
    ir_wall_detect_th_right = th;
}

float get_ir_wall_detect_th_left() {
    return ir_wall_detect_th_left;
}

float get_ir_wall_detect_th_right() {
    return ir_wall_detect_th_right;
}

int32_t ir_side_wall_error() {
    int32_t left_error = ir_distances[SensingDirection::LEFT] - services::Config::ir_wall_dist_ref_left;
    int32_t right_error = ir_distances[SensingDirection::RIGHT] - services::Config::ir_wall_dist_ref_right;

    int32_t ir_error;
    if (ir_is_wall_confirmed(SensingDirection::LEFT) && ir_is_wall_confirmed(SensingDirection::RIGHT)) {
        ir_error = right_error - left_error;
    } else if (ir_is_wall_confirmed(SensingDirection::LEFT)) {
        ir_error = -2.0 * left_error;
    } else if (ir_is_wall_confirmed(SensingDirection::RIGHT)) {
        ir_error = 2.0 * right_error;
    } else {
        ir_error = 0;
    }

    return ir_error;
}

int32_t ir_diagonal_error() {
    bool greater_error_left = ir_distances[SensingDirection::FRONT_LEFT] < ir_distances[SensingDirection::FRONT_RIGHT];

    int32_t ir_error;

    if (greater_error_left && ir_diagonal_control_valid(SensingDirection::FRONT_LEFT)) {
        ir_error = -(ir_distances[SensingDirection::FRONT_LEFT] - services::Config::ir_diagonal_ref_fl);
    } else if (!greater_error_left && ir_diagonal_control_valid(SensingDirection::FRONT_RIGHT)) {
        ir_error = (ir_distances[SensingDirection::FRONT_RIGHT] - services::Config::ir_diagonal_ref_fr);
    } else {
        ir_error = 0;
    }

    return ir_error;
}

bool ir_diagonal_control_valid(SensingDirection direction) {
    switch (direction) {
    case SensingDirection::FRONT_LEFT:
        return ir_distances[direction] < services::Config::ir_diagonal_control_th_fl;
    case SensingDirection::FRONT_RIGHT:
        return ir_distances[direction] < services::Config::ir_diagonal_control_th_fr;

    default:
        return false;
    }
}

SensingStatus ir_get_sensing_status() {
// #define USE_CLOSEST_MATCH_PATTERN
#ifdef USE_CLOSEST_MATCH_PATTERN
    SensingPattern current_pattern;
    current_pattern.FL = ir_distance_mm(FRONT_LEFT);
    current_pattern.FR = ir_distance_mm(FRONT_RIGHT);
    current_pattern.L = ir_distance_mm(LEFT);
    current_pattern.R = ir_distance_mm(RIGHT);

    // Compares the current value to all references and find the closest match
    float min_diff = 10000.0f;
    uint8_t pattern_idx = 0;
    for (uint8_t i = 0; i < ir_wall_patterns.size(); i++) {
        float diff = std::fabs(current_pattern.FL - ir_wall_patterns[i].FL) +
                     std::fabs(current_pattern.FR - ir_wall_patterns[i].FR) +
                     std::fabs(current_pattern.L - ir_wall_patterns[i].L) +
                     std::fabs(current_pattern.R - ir_wall_patterns[i].R);
        if (diff < min_diff) {
            min_diff = diff;
            pattern_idx = i;
        }
    }

    SensingStatus status = {false, false, false};

    switch (pattern_idx) {
    case 0:
        // F-L-R
        status.front_seeing = true;
        status.left_seeing = true;
        status.right_seeing = true;
        break;
    case 1:
        // F-L
        status.front_seeing = true;
        status.left_seeing = true;
        break;
    case 2:
        // F-R
        status.front_seeing = true;
        status.right_seeing = true;
        break;
    case 3:
        // F
        status.front_seeing = true;
        break;
    case 4:
        // L-R
        status.left_seeing = true;
        status.right_seeing = true;
        break;
    case 5:
        // L
        status.left_seeing = true;
        break;
    case 6:
        // R
        status.right_seeing = true;
        break;
    case 7:
        // None
        break;
    }

    return status;
#else
    constexpr float WALL_DETECT_TH_SIDE_MM = 230.0f;
    constexpr float WALL_DETECT_TH_FRONT_MM = 205.0f;

    SensingStatus status = {false, false, false};

    if (ir_distance_mm(LEFT) < WALL_DETECT_TH_SIDE_MM) {
        status.left_seeing = true;
    }

    if (ir_distance_mm(RIGHT) < WALL_DETECT_TH_SIDE_MM) {
        status.right_seeing = true;
    }

    if (ir_distance_mm(FRONT_LEFT) < WALL_DETECT_TH_FRONT_MM && ir_distance_mm(FRONT_RIGHT) < WALL_DETECT_TH_FRONT_MM) {
        status.front_seeing = true;
    }

    return status;
#endif
}

bool ir_start_condition() {
    return ir_distances[SensingDirection::FRONT_LEFT] < START_SENSOR_DIST_MM &&
           ir_distances[SensingDirection::FRONT_RIGHT] < START_SENSOR_DIST_MM;
}

void enable_modulation(bool enable) {
    modulation_enabled = enable;
    mod_step = 0;
    bsp::leds::ir_emitter_all_off();
}

/// @section Private functions

void update_ir_slope(SensingDirection direction, float distance) {
    const auto index = static_cast<uint8_t>(direction);
    if (!ir_slope_initialized[index]) {
        ir_distance_history[index][0] = distance;
        ir_distance_history[index][1] = distance;
        ir_distance_history[index][2] = distance;
        ir_slope[index] = 0.0f;
        ir_slope_initialized[index] = true;
        return;
    }

    ir_slope[index] = 4.0f * (distance - ir_distance_history[index][2]) +
                      (ir_distance_history[index][0] - ir_distance_history[index][1]);
    ir_distance_history[index][2] = ir_distance_history[index][1];
    ir_distance_history[index][1] = ir_distance_history[index][0];
    ir_distance_history[index][0] = distance;
}

void adc1_callback(uint32_t* data) {
    uint32_t aux_readings[ADC_1_DMA_CHANNELS] = {0};

    for (uint16_t i = 0; i < (ADC_1_DMA_HALF_BUFFER_SIZE - 1); i += ADC_1_DMA_CHANNELS) {
        for (uint16_t j = 0; j < ADC_1_DMA_CHANNELS; j++) {
            aux_readings[j] += data[i + j];
        }
    }

    for (uint16_t j = 0; j < ADC_1_DMA_CHANNELS; j++) {
        aux_readings[j] /= (ADC_1_DMA_HALF_BUFFER_SIZE / ADC_1_DMA_CHANNELS);
    }

    if (!modulation_enabled) {
        bsp::leds::ir_emitter_all_off();
        mod_step = 0;
        for (int i = 0; i < 4; i++) {
            ir_raw_readings[i] = aux_readings[i];
            ir_distances[i] = raw_to_distance_mm(static_cast<SensingDirection>(i), ir_raw_readings[i]);
            update_ir_slope(static_cast<SensingDirection>(i), ir_distances[i]);
        }
    } else {
        if (mod_step == 0) {
            // Ambient light reading (all emitters were off during conversion)
            for (int i = 0; i < 4; i++) {
                ir_raw_readings_off[i] = aux_readings[i];
            }
            // Turn ON emitter for sensor 0 for the upcoming buffer conversion
            bsp::leds::ir_emitter_on(sensor_emitters[0]);
            mod_step = 1;
        } else {
            uint8_t sensor_idx = mod_step - 1; // 0, 1, 2, 3

            // Record reading with only this sensor's emitter turned on
            ir_raw_readings_on[sensor_idx] = aux_readings[sensor_idx];
            int32_t reading_delta = ir_raw_readings_on[sensor_idx] - ir_raw_readings_off[sensor_idx];
            uint32_t reading = reading_delta > 0 ? static_cast<uint32_t>(reading_delta) : 0;
            ir_raw_readings[sensor_idx] =
                static_cast<uint32_t>(IR_EMA_ALPHA * static_cast<float>(reading) +
                                      (1.0f - IR_EMA_ALPHA) * static_cast<float>(ir_raw_readings[sensor_idx]));
            ir_distances[sensor_idx] =
                raw_to_distance_mm(static_cast<SensingDirection>(sensor_idx), ir_raw_readings[sensor_idx]);
            update_ir_slope(static_cast<SensingDirection>(sensor_idx), ir_distances[sensor_idx]);

            // Turn OFF current emitter
            bsp::leds::ir_emitter_off(sensor_emitters[sensor_idx]);

            if (mod_step < 4) {
                // Turn ON next sensor's emitter
                bsp::leds::ir_emitter_on(sensor_emitters[mod_step]);
                mod_step++;
            } else {
                // All emitters are now OFF; next cycle will sample ambient light (step 0)
                mod_step = 0;
            }
        }
    }

    battery_reading = 0.5 * aux_readings[4] + battery_reading * 0.5;
}

void adc2_callback(uint32_t* data) {
    uint32_t aux_readings[ADC_2_DMA_CHANNELS] = {0};

    for (uint16_t i = 0; i < (ADC_2_DMA_HALF_BUFFER_SIZE - 1); i += ADC_2_DMA_CHANNELS) {
        for (uint16_t j = 0; j < ADC_2_DMA_CHANNELS; j++) {
            aux_readings[j] += data[i + j];
        }
    }

    for (uint16_t j = 0; j < ADC_2_DMA_CHANNELS; j++) {
        aux_readings[j] /= (ADC_2_DMA_HALF_BUFFER_SIZE / ADC_2_DMA_CHANNELS);
    }

    current_reading[0] = aux_readings[0];
    current_reading[1] = aux_readings[1];
}

}

/// @section HAL callbacks

void HAL_ADC_ConvHalfCpltCallback(ADC_HandleTypeDef* hadc) {
    if (hadc->Instance == ADC1) {
        bsp::analog_sensors::adc1_callback(&bsp::analog_sensors::adc_1_dma_buffer[0]);
    } else if (hadc->Instance == ADC2) {
        bsp::analog_sensors::adc2_callback(&bsp::analog_sensors::adc_2_dma_buffer[0]);
    }

    if (bsp::analog_sensors::reading_ready_callback != NULL) {
        bsp::analog_sensors::reading_ready_callback();
    }
}

void HAL_ADC_ConvCpltCallback(ADC_HandleTypeDef* hadc) {
    if (hadc->Instance == ADC1) {
        bsp::analog_sensors::adc1_callback(
            &bsp::analog_sensors::adc_1_dma_buffer[bsp::analog_sensors::ADC_1_DMA_HALF_BUFFER_SIZE]);
    } else if (hadc->Instance == ADC2) {
        bsp::analog_sensors::adc2_callback(
            &bsp::analog_sensors::adc_2_dma_buffer[bsp::analog_sensors::ADC_2_DMA_HALF_BUFFER_SIZE]);
    }

    if (bsp::analog_sensors::reading_ready_callback != NULL) {
        bsp::analog_sensors::reading_ready_callback();
    }
}
