team-raiju/fujin/firmware/params.txt

########################
## Params Search Slow ##
########################


########################
## Competition Params ##
########################


##########################
### RoboChallenge 2024 ###
##########################
angular_kp = 15
angular_ki = 0.15
angular_kd = 0
wall_kp = 0.0035
wall_ki = 0
wall_kd = 0.006
min_move_speed = 16
min_turn_speed = 16
fix_position_speed = 20
search_speed = 45
angular_speed = 30
run_speed = 100
linear_acceleration = 0.05
angular_acceleration = 0.05

##########################
### RoboChallenge 2025 ###
##########################

Best time: Mode super of movement params.cpp

ir_wall_dist_ref_right = 1470
ir_diagonal_ref_fl = 200
ir_diagonal_ref_fr = 200
ir_wall_dist_ref_left = 890

ir_diagonal_control_th_fl = 500
ir_diagonal_control_th_fr = 500

ir_wall_detect_th_right = 1200
ir_wall_detect_th_front_left = 500 
ir_wall_detect_th_front_right = 800
ir_wall_detect_th_left = 700

constexpr std::array<SensingPattern, 8> ir_wall_patterns = {{
    {1119, 850, 1290, 1460}, // F-L-R
    {960, 820, 1200, 880},  // F-L
    {500, 700, 1160, 1460}, // F-R
    {520, 755, 1200, 870},  // F
    {900, 67, 246, 1460},   // L-R
    {900, 28, 230, 870},     // L
    {530, 35, 261, 1300},   // R
    {180, 66, 238, 800}     // None
}};

min_move_speed = 0.2
z_imu_bias = -0.4905

normal: approx 630g

##########################
###      RCX 2026      ###
##########################
min_move_speed = 0.2
ir_diagonal_control_th_fl = 240
ir_diagonal_control_th_fr = 240
ir_diagonal_ref_fl = 260
ir_diagonal_ref_fr = 260
ir_wall_dist_ref_left = 185.40
ir_wall_dist_ref_right = 176.37
ir_wall_detect_th_left = 240   -> Run
ir_wall_detect_th_right = 240  -> Run
ir_wall_detect_th_left = 210   -> Search
ir_wall_detect_th_right = 210  -> Search

right_sensor_angle_deg = 58.9
left_sensor_angle_deg = 59.4
z_imu_bias = -0.565
enable_lateral_correction_90 = 1
enable_lateral_correction_wall = 1


##########################
## Calibration Test Map ##
##########################
min_move_speed = 0.2
ir_diagonal_control_th_fl = 240
ir_diagonal_control_th_fr = 240
ir_diagonal_ref_fl = 260
ir_diagonal_ref_fr = 260
ir_wall_dist_ref_left = 193.39
ir_wall_dist_ref_right = 182.37
ir_wall_detect_th_left = 240
ir_wall_detect_th_right = 240
sensor_r_slope_max_th = 70
sensor_l_slope_max_th = 70
right_sensor_angle_deg = 58.9
left_sensor_angle_deg = 59.4
z_imu_bias = -0.55137
enable_lateral_correction_90 = 1
enable_lateral_correction_wall = 0 
