team-raiju/fujin/firmware/inc/services/control.hpp

#pragma once

#include <cstdint>

#include "algorithms/pid.hpp"
#include "utils/movement_params.hpp"


namespace services {

class Control {
    public:
        static Control* instance();

        Control(const Control&) = delete;

        void init();
        void reset(GeneralParams general_params);
        void update();

        void start_fan();
        void stop_fan();
        
        void set_target_linear_speed(float speed) { target_linear_speed_m_s = speed; }
        void set_target_angular_speed(float speed) { target_angular_speed_rad_s = speed; }
        void set_wall_pid_enabled(bool enabled) { wall_pid_enabled = enabled; }
        void set_diagonal_pid_enabled(bool enabled) { diagonal_pid_enabled = enabled; }
        void set_motor_control_disabled(bool disabled) {motor_control_disabled = disabled;}
        bool is_motor_control_disabled() const { return motor_control_disabled; }
        void set_use_inplace_friction(bool use) { use_inplace_friction = use; }
        void set_inplace_friction(bool use) { use_inplace_friction = use; }
        bool get_use_inplace_friction() const { return use_inplace_friction; }

        float get_target_linear_speed() const { return target_linear_speed_m_s; }
        float get_target_angular_speed() const { return target_angular_speed_rad_s; }
        float get_target_linear_acceleration() const { return target_linear_acceleration; }
        float get_target_angular_acceleration() const { return target_angular_acceleration; }
        bool get_wall_pid_enabled() const { return wall_pid_enabled; }
        bool get_diagonal_pid_enabled() const { return diagonal_pid_enabled; }
        int16_t get_pwm_duty_l() const { return pwm_duty_l; }
        int16_t get_pwm_duty_r() const { return pwm_duty_r; }
        
        float get_integral_vel() const { return linear_vel_pid.get_integral(); }
        float get_integral_angular() const { return angular_vel_pid.get_integral(); }
        bool is_emergency() const {return emergency; }

        algorithm::PID get_vel_pid() const { return linear_vel_pid; }
        algorithm::PID get_ang_vel_pid() const { return angular_vel_pid; }
        float get_rotation_ff() const { return rotation_ff; }
        float get_linear_ff() const { return linear_ff; }
        uint16_t get_fan_pwm() const { return fan_pwm; }

    private:
        Control() {}

        void fan_control_update(float bat_volts);
        std::pair<int16_t, int16_t> clamp_pwms(int16_t pwm_l, int16_t pwm_r);


        float rotation_ff = 0.0f;
        float linear_ff = 0.0f;

        algorithm::PID linear_vel_pid;
        algorithm::PID angular_vel_pid;
        algorithm::PID walls_pid;
        algorithm::PID diagonal_walls_pid;

        float target_linear_speed_m_s;
        float last_target_linear_speed_m_s;
        float target_linear_acceleration = 0.0f;
        float last_target_linear_acceleration = 0.0f;
        float target_angular_speed_rad_s;
        float last_target_angular_speed_rad_s;
        float target_angular_acceleration = 0.0f;
        float last_target_angular_acceleration = 0.0f;
        bool wall_pid_enabled = false;
        bool diagonal_pid_enabled = false;
        int16_t pwm_duty_l;
        int16_t pwm_duty_r;
        bool motor_control_disabled = false;
        bool emergency = false;
        bool use_inplace_friction = false;
        uint16_t fan_pwm = 0;

        GeneralParams params;

};

}
