team-raiju/fujin/firmware/src/services/navigation.cpp

#include <algorithm>
#include <cmath>
#include <cstdio>
#include <map>
#include <string>

#include "bsp/analog_sensors.hpp"
#include "bsp/encoders.hpp"
#include "bsp/imu.hpp"
#include "bsp/leds.hpp"
#include "bsp/timers.hpp"
#include "services/config.hpp"
#include "services/navigation.hpp"
#include "utils/math.hpp"
#include "utils/movement_params.hpp"
#include "utils/types.hpp"

/// @section Constants

static std::array<TurnParams, MOVEMENT_COUNT> turn_params;
static std::array<ForwardParams, MOVEMENT_COUNT> forward_params;
static GeneralParams general_params;

using bsp::leds::Color;

namespace {

constexpr float FRONT_EMERGENCY_DISTANCE_MM = 70.0f;
constexpr float WALL_BREAK_DEBUG_DISTANCE_MM = 90.0f;
constexpr float SEARCH_WALL_BREAK_MIN_DISTANCE_MM = 35.0f;
constexpr float WALL_BREAK_MAX_CORRECTION_ERROR_MM = 20.0f;
constexpr float FORWARD_WALL_PID_DISABLE_DISTANCE_MM = 70.0f;
constexpr float DIAGONAL_PID_START_DISTANCE_MM = 50.0f;
constexpr uint32_t STABILIZE_FORWARD_TIME_MS = 175;
constexpr uint32_t STABILIZE_TURN_TIME_MS = 175;
constexpr float STABILIZE_VELOCITY_THRESHOLD_M_S = 0.02f;
constexpr float MILLIMETERS_PER_METER = 1000.0f;
constexpr uint8_t MIN_MOVEMENTS_FOR_SEAMLESS_START = 3;

constexpr float MAX_TURN_90_ERROR_CORRECTION = 12.0f;
constexpr float MAX_WALL_BREAK_LATERAL_OFFSET_MM = 10.0f;
constexpr float MAX_WALL_BREAK_LONGITUDINAL_FIX_MM = 4.0f;


bool is_search_mode(services::Navigation::navigation_mode_t mode) {
    return mode == services::Navigation::SEARCH_FAST || mode == services::Navigation::SEARCH_MEDIUM ||
           mode == services::Navigation::SEARCH_SLOW;
}

GeneralParams make_custom_general_params() {
    return {
        services::Config::fan_speed,
        services::Config::angular_kp,
        services::Config::angular_ki,
        services::Config::angular_kd,
        services::Config::angular_acc_feed_forward_k,
        services::Config::angular_brake_feed_forward_k,
        services::Config::angular_vel_feed_forward_k,
        services::Config::linear_vel_acc_feed_forward_k,
        services::Config::linear_vel_brake_feed_forward_k,
        services::Config::linear_vel_feed_forward_k,
        services::Config::wall_kp,
        services::Config::wall_ki,
        services::Config::wall_kd,
        services::Config::linear_vel_kp,
        services::Config::linear_vel_ki,
        services::Config::linear_vel_kd,
        services::Config::diagonal_walls_kp,
        services::Config::diagonal_walls_ki,
        services::Config::diagonal_walls_kd,
        services::Config::start_wall_break_mm_left,
        services::Config::start_wall_break_mm_right,
        services::Config::enable_wall_break_correction,
        services::Config::max_linear_acc_jerk,
        services::Config::max_linear_brake_jerk,
        services::Config::wheel_radius_mm,
        services::Config::coulomb_ff,
        services::Config::angular_coulomb_ff,
        services::Config::angular_static_ff,
        services::Config::angular_coulomb_ff_inplace,
        services::Config::angular_static_ff_inplace,
        services::Config::linear_accel_margin_mm,
        services::Config::linear_brake_margin_mm,
        services::Config::sensor_r_slope_max_th,
        services::Config::sensor_l_slope_max_th,
        services::Config::ir_wall_detect_th_left,
        services::Config::ir_wall_detect_th_right,
        services::Config::enable_lateral_correction_90,
        services::Config::enable_lateral_correction_wall,
    };
}

} // namespace

/// @section Service implementation

namespace services {

Navigation* Navigation::instance() {
    static Navigation p;
    return &p;
}

void Navigation::init() {
    control = Control::instance();
    reset(SEARCH_SLOW);

    if (!is_initialized) {
        is_initialized = true;
    }
}

const std::array<ForwardParams, MOVEMENT_COUNT>& Navigation::get_forward_params() const {
    return forward_params;
}

const std::array<TurnParams, MOVEMENT_COUNT>& Navigation::get_turn_params() const {
    return turn_params;
}

void Navigation::reset() {
    reset(selected_mode);
}

void Navigation::reset(navigation_mode_t mode) {
    reset_movement_variables(true);
    encoder_left_counter = 0;
    encoder_right_counter = 0;
    current_cell = {0, 0};
    complete_prev_move_travel = 0;
    waiting_for_fast_param = false;
    turn_end_correction_mm = 0.0f;
    continuous_start_to_forward = false;

    current_direction = Direction::NORTH;
    target_direction = Direction::NORTH;

    bsp::encoders::reset();
    bsp::imu::reset();

    selected_mode = mode;
    configure_mode(mode);

    control->reset(general_params);

    current_movement = Movement::START;
    previous_movement = Movement::START;
    current_movement_count = 1;
    target_travel_mm = forward_params[Movement::START].target_travel_mm;
    forward_end_speed = forward_params[Movement::START].max_speed;
    bsp::analog_sensors::ir_reset_all_wall_hysteresis();
}

void Navigation::configure_mode(navigation_mode_t mode) {
    if (mode == CUSTOM) {
        turn_params = turn_params_custom;
        forward_params = forward_params_custom;
        general_params = make_custom_general_params();
    } else {
        turn_params = ::get_turn_params(mode);
        forward_params = ::get_forward_params(mode);
        general_params = get_general_params(mode);
    }
    bsp::encoders::set_wheel_radius_mm(general_params.wheel_radius_mm);
    bsp::analog_sensors::set_sensor_r_slope_max_th(general_params.sensor_r_slope_max_th);
    bsp::analog_sensors::set_sensor_l_slope_max_th(general_params.sensor_l_slope_max_th);
    bsp::analog_sensors::set_ir_wall_detect_th_left(general_params.ir_wall_detect_th_left);
    bsp::analog_sensors::set_ir_wall_detect_th_right(general_params.ir_wall_detect_th_right);
}

bool Navigation::is_front_emergency() const {
    if (current_movement != Movement::FORWARD && current_movement != Movement::START) {
        return false;
    }

    using bsp::analog_sensors::ir_distance_mm;
    using bsp::analog_sensors::SensingDirection;

    return ir_distance_mm(SensingDirection::FRONT_LEFT) < FRONT_EMERGENCY_DISTANCE_MM &&
           ir_distance_mm(SensingDirection::FRONT_RIGHT) < FRONT_EMERGENCY_DISTANCE_MM;
}

void Navigation::reset_movement_variables(bool reset_linear_accel) {
    bsp::imu::reset_angle();
    mini_fsm_state = MiniFSMStates::FORWARD_1;
    current_angular_acceleration = 0.0f;
    if (reset_linear_accel) {
        current_linear_acceleration = 0.0f;
    }

    traveled_dist_mm = 0;
    current_position_mm = {0, 0};
    current_angle_rad = 0;
    reset_wall_break();
    reference_time = bsp::get_tick_ms();
    turn_tick_counter = 0;
    is_finished = false;
    is_braking = false;
    control->set_use_inplace_friction(false);

    if (!is_linear_movement(current_movement) || previous_movement != current_movement) {
        bsp::analog_sensors::ir_reset_all_wall_hysteresis();
    }
}

float Navigation::get_torricelli_distance(float final_speed, float initial_speed, float acceleration) {
    return (final_speed * final_speed - initial_speed * initial_speed) / (2.0f * acceleration);
}

float Navigation::get_s_curve_brake_distance(float initial_speed, float final_speed, float deceleration, float jerk) {
    if (initial_speed <= final_speed || deceleration <= 0.0f || jerk <= 0.0f) {
        return 0.0f;
    }

    float delta_v = initial_speed - final_speed;
    float v_threshold = (deceleration * deceleration) / jerk;

    if (delta_v >= v_threshold) {
        return ((initial_speed * initial_speed - final_speed * final_speed) / (2.0f * deceleration)) +
               (((initial_speed + final_speed) * deceleration) / (2.0f * jerk));
    } else {
        return (initial_speed + final_speed) * std::sqrt(delta_v / jerk);
    }
}

bool Navigation::start_accel_ramp_down(float current_speed, float current_accel, float max_speed, float jerk) {
    if (jerk <= 0.0f) {
        return false;
    }
    if (current_accel <= 0.0f) {
        return current_speed >= max_speed;
    }
    float pred_speed = current_speed + (current_accel * current_accel) / (2.0f * jerk);
    return pred_speed >= max_speed;
}

bool Navigation::start_brake_ramp_up(float current_speed, float current_accel, float final_speed, float jerk) {
    if (jerk <= 0.0f) {
        return false;
    }
    if (current_accel >= 0.0f) {
        return current_speed <= final_speed;
    }
    float pred_speed = current_speed - (current_accel * current_accel) / (2.0f * jerk);
    return pred_speed <= final_speed;
}

float Navigation::get_effective_max_acceleration(float current_speed, float base_max_accel) {
    if (current_speed > 7.0f) {
        return 17.0f;
    } else if (current_speed > 6.5f) {
        return 22.0f;
    } else if (current_speed > 6.0f) {
        return 25.0f;
    } else if (current_speed > 5.5f) {
        return 30.0f;
    } else if (current_speed > 5.0f) {
        return 35.0f;
    } else {
        return base_max_accel;
    }
}

void Navigation::reset_wall_break() {
    wall_right_was_confirmed = false;
    wall_left_was_confirmed = false;

    wall_break_last_dist = 0.0f;
    current_wall_break_detected = false;
    if (wall_break_debug_led_on) {
        bsp::leds::stripe_set(Color::Black);
        wall_break_debug_led_on = false;
    }
}

Navigation::WallBreak Navigation::process_wall_break() {
    if (current_movement != Movement::FORWARD) {
        wall_left_was_confirmed = false;
        wall_right_was_confirmed = false;
        return WallBreak::NONE;
    }

    const float wall_break_distance = traveled_dist_mm - wall_break_last_dist;
    if (wall_break_debug_led_on && wall_break_distance >= WALL_BREAK_DEBUG_DISTANCE_MM) {
        bsp::leds::stripe_set(Color::Black);
        wall_break_debug_led_on = false;
    }

    const bool right_is_confirmed =
        bsp::analog_sensors::ir_is_wall_confirmed(bsp::analog_sensors::SensingDirection::RIGHT);
    const bool left_is_confirmed =
        bsp::analog_sensors::ir_is_wall_confirmed(bsp::analog_sensors::SensingDirection::LEFT);

    const bool right_break = bsp::analog_sensors::ir_wall_break_condition(bsp::analog_sensors::SensingDirection::RIGHT);
    const bool left_break = bsp::analog_sensors::ir_wall_break_condition(bsp::analog_sensors::SensingDirection::LEFT);

    const bool falling_edge_right = wall_right_was_confirmed && right_break;
    const bool falling_edge_left = wall_left_was_confirmed && left_break;

    wall_right_was_confirmed = right_is_confirmed;
    wall_left_was_confirmed = left_is_confirmed;

    bool process = false;
    if (is_search_mode(selected_mode)) {
        bool valid_previous_move =
            (previous_movement == FORWARD || previous_movement == START || previous_movement == TURN_AROUND ||
             previous_movement == TURN_RIGHT_90_SEARCH_MODE || previous_movement == TURN_LEFT_90_SEARCH_MODE);

        if (valid_previous_move && wall_break_distance > SEARCH_WALL_BREAK_MIN_DISTANCE_MM &&
            !current_wall_break_detected) {
            process = true;
        }
    } else if (wall_break_distance > CELL_SIZE_MM) {
        process = true;
    } else if ((previous_movement == START) && (current_movement == FORWARD) && (wall_break_last_dist < 0.1)) {
        process = true;
    }

    if (!process) {
        return WallBreak::NONE;
    }

    if (falling_edge_right) {
        wall_break_last_dist = traveled_dist_mm;
        current_wall_break_detected = true;
        return WallBreak::RIGHT;
    }

    if (falling_edge_left) {
        wall_break_last_dist = traveled_dist_mm;
        current_wall_break_detected = true;
        return WallBreak::LEFT;
    }

    return WallBreak::NONE;
}
void Navigation::apply_wall_break_correction() {
    const WallBreak wall_break = process_wall_break();
    if (wall_break == WallBreak::NONE) {
        return;
    }

    using bsp::analog_sensors::ir_distance_mm;
    using bsp::analog_sensors::ir_reading_wall;
    using bsp::analog_sensors::SensingDirection;

    constexpr float DEG_TO_RAD = 3.14159265358979323846f / 180.0f;

    const float corridor_distance_mm = traveled_dist_mm - complete_prev_move_travel;
    const int cells_traveled = static_cast<int>(corridor_distance_mm / CELL_SIZE_MM);

    float base_offset_mm = 0.0f;
    float longitudinal_correction_mm = 0.0f;

    if (wall_break == WallBreak::LEFT) {
        base_offset_mm = general_params.start_wall_break_mm_left;

        // Left wall just broke: measure lateral displacement using opposite (Right) sensor
        if (general_params.enable_lateral_correction_wall && ir_reading_wall(SensingDirection::RIGHT)) {
            const float cos_theta_r = std::cos(Config::right_sensor_angle_deg * DEG_TO_RAD);
            const float tan_theta_l = std::tan(Config::left_sensor_angle_deg * DEG_TO_RAD);

            const float measured_dist_r = ir_distance_mm(SensingDirection::RIGHT);
            const float delta_l_r = measured_dist_r - Config::ir_wall_dist_ref_right;

            // lateral_offset_mm > 0 means further from right wall => shifted toward the left wall
            float lateral_offset_mm = delta_l_r * cos_theta_r;
            lateral_offset_mm = std::clamp(lateral_offset_mm, -MAX_WALL_BREAK_LATERAL_OFFSET_MM, MAX_WALL_BREAK_LATERAL_OFFSET_MM);

            // Closer to left wall means the beam caught the break later along the track (+dx)
            longitudinal_correction_mm = lateral_offset_mm * tan_theta_l;
            longitudinal_correction_mm =
                std::clamp(longitudinal_correction_mm, -MAX_WALL_BREAK_LONGITUDINAL_FIX_MM, MAX_WALL_BREAK_LONGITUDINAL_FIX_MM);
        }
    } else if (wall_break == WallBreak::RIGHT) {
        base_offset_mm = general_params.start_wall_break_mm_right;

        // Right wall just broke: measure lateral displacement using opposite (Left) sensor
        if (general_params.enable_lateral_correction_wall && ir_reading_wall(SensingDirection::LEFT)) {
            const float cos_theta_l = std::cos(Config::left_sensor_angle_deg * DEG_TO_RAD);
            const float tan_theta_r = std::tan(Config::right_sensor_angle_deg * DEG_TO_RAD);

            const float measured_dist_l = ir_distance_mm(SensingDirection::LEFT);
            const float delta_l_l = measured_dist_l - Config::ir_wall_dist_ref_left;

            // lateral_offset_mm > 0 means further from left wall => shifted toward the right wall
            float lateral_offset_mm = delta_l_l * cos_theta_l;
            lateral_offset_mm = std::clamp(lateral_offset_mm, -MAX_WALL_BREAK_LATERAL_OFFSET_MM, MAX_WALL_BREAK_LATERAL_OFFSET_MM);

            // Closer to right wall means the beam caught the break later along the track (+dx)
            longitudinal_correction_mm = lateral_offset_mm * tan_theta_r;
            longitudinal_correction_mm =
                std::clamp(longitudinal_correction_mm, -MAX_WALL_BREAK_LONGITUDINAL_FIX_MM, MAX_WALL_BREAK_LONGITUDINAL_FIX_MM);
        }
    }

    // Expected position where wall break should occur along the corridor
    const float expected_corridor_dist_mm =
        (cells_traveled * CELL_SIZE_MM) + base_offset_mm + longitudinal_correction_mm;

    // Error between estimated corridor position and nominal wall break position
    const float distance_error_mm = corridor_distance_mm - expected_corridor_dist_mm;

    // Convert expected corridor distance to the wheel odometer frame for traveled_dist_mm
    const float corrected_traveled_dist_mm = expected_corridor_dist_mm + complete_prev_move_travel;

    if (std::abs(distance_error_mm) < WALL_BREAK_MAX_CORRECTION_ERROR_MM) {
        traveled_dist_mm = corrected_traveled_dist_mm;
        wall_break_last_dist = corrected_traveled_dist_mm;
        bsp::leds::stripe_set(Color::Red);
        wall_break_debug_led_on = true;
    } else {
        bsp::leds::stripe_set(Color::White);
        wall_break_debug_led_on = true;
    }
}

float Navigation::get_acceleration_ramp_distance_m(float current_speed, float acceleration, float brake_jerk) const {
    const float ramp_time = acceleration / brake_jerk;
    return (current_speed * ramp_time) +
           (acceleration * acceleration * acceleration) / (3.0f * brake_jerk * brake_jerk);
}

void Navigation::update(void) {
    bsp::imu::update();
    bsp::encoders::update_ticks();
    float target_linear_accel = control ? control->get_target_linear_acceleration() : 0.0f;
    bsp::encoders::update_velocities(target_linear_accel);

    bsp::encoders::EncoderData left_encoder = bsp::encoders::get_data(bsp::encoders::EncoderSide::LEFT);
    bsp::encoders::EncoderData right_encoder = bsp::encoders::get_data(bsp::encoders::EncoderSide::RIGHT);
    float measured_angle_rad = bsp::imu::get_angle();

    float estimated_delta_l_mm = (left_encoder.ticks * bsp::encoders::get_encoder_dist_mm_pulse());
    float estimated_delta_r_mm = (right_encoder.ticks * bsp::encoders::get_encoder_dist_mm_pulse());

    float delta_x_mm = (estimated_delta_l_mm + estimated_delta_r_mm) / 2.0;
    float encoder_diff_mm = (estimated_delta_r_mm - estimated_delta_l_mm);
    if (left_encoder.ticks == 0 && right_encoder.ticks == 0) {
        delta_x_mm = 0.0f;
        encoder_diff_mm = 0.0f;
    }

    float imu_delta_angle_rad = get_shortest_delta_angle(measured_angle_rad, current_angle_rad);

    float intermediate_angle_rad = current_angle_rad + (imu_delta_angle_rad / 2.0);
    intermediate_angle_rad = limit_angle_minus_pi_pi(intermediate_angle_rad);

    float expected_diff_mm = imu_delta_angle_rad * Config::WHEELS_DIST_MM;
    encoder_imu_diff = encoder_diff_mm - expected_diff_mm;

    traveled_dist_mm += delta_x_mm;
    bsp::analog_sensors::ir_update_wall_hysteresis(delta_x_mm);

    Position rotated_delta;
    rotated_delta.x = delta_x_mm * std::cos(intermediate_angle_rad);
    rotated_delta.y = delta_x_mm * std::sin(intermediate_angle_rad);
    current_position_mm.x += rotated_delta.x;
    current_position_mm.y += rotated_delta.y;

    current_angle_rad = measured_angle_rad;
    bsp::encoders::clear_ticks();
}

bool Navigation::is_linear_movement(Movement movement) const {
    return movement == Movement::START || movement == Movement::FORWARD || movement == Movement::DIAGONAL ||
           movement == Movement::STOP;
}

bool Navigation::is_turn_around_movement() const {
    return current_movement == Movement::TURN_AROUND || current_movement == Movement::TURN_AROUND_INPLACE;
}

bool Navigation::is_search_turn_movement() const {
    return current_movement == Movement::TURN_RIGHT_90_SEARCH_MODE ||
           current_movement == Movement::TURN_LEFT_90_SEARCH_MODE;
}

bool Navigation::is_turn_from_diagonal() const {
    return current_movement == Movement::TURN_RIGHT_90_FROM_45 || current_movement == Movement::TURN_LEFT_90_FROM_45;
}

bool Navigation::is_turn_movement(Movement movement) const {
    switch (movement) {
    case Movement::TURN_LEFT_45:
    case Movement::TURN_RIGHT_45:
    case Movement::TURN_LEFT_90:
    case Movement::TURN_RIGHT_90:
    case Movement::TURN_LEFT_135:
    case Movement::TURN_RIGHT_135:
    case Movement::TURN_RIGHT_180:
    case Movement::TURN_LEFT_180:
    case Movement::TURN_RIGHT_90_SEARCH_MODE:
    case Movement::TURN_LEFT_90_SEARCH_MODE:
    case Movement::TURN_RIGHT_45_FROM_45:
    case Movement::TURN_LEFT_45_FROM_45:
    case Movement::TURN_RIGHT_90_FROM_45:
    case Movement::TURN_LEFT_90_FROM_45:
    case Movement::TURN_RIGHT_135_FROM_45:
    case Movement::TURN_LEFT_135_FROM_45:
    case Movement::TURN_AROUND_INPLACE:
    case Movement::TURN_AROUND:
        return true;
    default:
        return false;
    }
}

float Navigation::get_required_brake_distance(float control_linear_speed, float deceleration,
                                              bool continuous_start_to_forward) {
    if (continuous_start_to_forward) {
        return 0.0f;
    }

    float brake_distance_mm = current_movement == Movement::START ? 0.0f : general_params.linear_brake_margin_mm;

    float brake_jerk = general_params.max_linear_brake_jerk;
    if (current_movement == Movement::STOP) {
        brake_jerk *= 2.0f;
    }

    if (current_linear_acceleration > 0.0f && brake_jerk > 0.0f) {
        float delta_v = (current_linear_acceleration * current_linear_acceleration) / (2.0f * brake_jerk);
        float peak_speed = control_linear_speed + delta_v;
        float ramp_distance_m =
            get_acceleration_ramp_distance_m(control_linear_speed, current_linear_acceleration, brake_jerk);

        brake_distance_mm +=
            MILLIMETERS_PER_METER *
            (ramp_distance_m + get_s_curve_brake_distance(peak_speed, forward_end_speed, deceleration, brake_jerk));
    } else {
        brake_distance_mm += MILLIMETERS_PER_METER * get_s_curve_brake_distance(control_linear_speed, forward_end_speed,
                                                                                deceleration, brake_jerk);
    }

    return brake_distance_mm;
}

void Navigation::update_linear_target_speed(float& control_linear_speed, float max_speed, float max_acceleration,
                                            float deceleration, bool continuous_start_to_forward) {
    float accel_jerk = general_params.max_linear_acc_jerk;
    float brake_jerk = general_params.max_linear_brake_jerk;

    if (current_movement == Movement::STOP) {
        brake_jerk *= 2.0f;
        accel_jerk *= 2.0f;
    }

    const bool is_start_or_after_start =
        (current_movement == Movement::START) ||
        ((current_movement == Movement::FORWARD || current_movement == Movement::DIAGONAL) &&
         previous_movement == Movement::START);
    const float accel_margin_mm = is_start_or_after_start ? 0.0f : general_params.linear_accel_margin_mm;

    const float required_brake_distance =
        get_required_brake_distance(control_linear_speed, deceleration, continuous_start_to_forward);
    const bool requires_turn_margin = (previous_movement != Movement::START) && (control_linear_speed >= 1.0f);

    const bool should_accelerate =
        !is_braking &&
        (continuous_start_to_forward || (std::abs(traveled_dist_mm) < (target_travel_mm - required_brake_distance)));

    if (should_accelerate) {
        if (requires_turn_margin && std::abs(traveled_dist_mm) <= accel_margin_mm) {
            return;
        }

        if (control_linear_speed >= max_speed) {
            if (current_linear_acceleration > 0.0f) {
                current_linear_acceleration -= accel_jerk / Config::CONTROL_FREQUENCY_HZ;
                current_linear_acceleration = std::max(current_linear_acceleration, 0.0f);
            } else {
                current_linear_acceleration = 0.0f;
            }
            control_linear_speed = max_speed;
            return;
        }

        if (start_accel_ramp_down(control_linear_speed, current_linear_acceleration, max_speed, accel_jerk)) {
            current_linear_acceleration -= accel_jerk / Config::CONTROL_FREQUENCY_HZ;
            current_linear_acceleration = std::max(current_linear_acceleration, 0.0f);
            control_linear_speed += current_linear_acceleration / Config::CONTROL_FREQUENCY_HZ;
            control_linear_speed = std::min(control_linear_speed, max_speed);
            return;
        }

        const float effective_max_acceleration = get_effective_max_acceleration(control_linear_speed, max_acceleration);
        if (current_linear_acceleration < effective_max_acceleration) {
            current_linear_acceleration += accel_jerk / Config::CONTROL_FREQUENCY_HZ;
            current_linear_acceleration = std::min(current_linear_acceleration, effective_max_acceleration);
        } else if (current_linear_acceleration > effective_max_acceleration) {
            current_linear_acceleration -= accel_jerk / Config::CONTROL_FREQUENCY_HZ;
            current_linear_acceleration = std::max(current_linear_acceleration, effective_max_acceleration);
        }

        control_linear_speed += current_linear_acceleration / Config::CONTROL_FREQUENCY_HZ;
        control_linear_speed = std::min(control_linear_speed, max_speed);
        return;
    }

    // else if !should_accelerate continues here...
    if (continuous_start_to_forward || std::abs(traveled_dist_mm) <= accel_margin_mm) {
        return;
    }

    is_braking = true;

    if (control_linear_speed > forward_end_speed || current_linear_acceleration < 0.0f) {
        if (start_brake_ramp_up(control_linear_speed, current_linear_acceleration, forward_end_speed, brake_jerk) ||
            control_linear_speed <= forward_end_speed) {
            current_linear_acceleration += brake_jerk / Config::CONTROL_FREQUENCY_HZ;
            current_linear_acceleration = std::min(current_linear_acceleration, 0.0f);
        } else {
            current_linear_acceleration -= brake_jerk / Config::CONTROL_FREQUENCY_HZ;
            current_linear_acceleration = std::max(current_linear_acceleration, -deceleration);
        }

        control_linear_speed += current_linear_acceleration / Config::CONTROL_FREQUENCY_HZ;
        control_linear_speed = std::max(control_linear_speed, forward_end_speed);
        if (forward_end_speed > 0.0f) {
            control_linear_speed = std::max(control_linear_speed, Config::min_move_speed);
        }
    } else if (current_linear_acceleration > 0.0f) {
        current_linear_acceleration -= brake_jerk / Config::CONTROL_FREQUENCY_HZ;
        current_linear_acceleration = std::max(current_linear_acceleration, 0.0f);
        control_linear_speed += current_linear_acceleration / Config::CONTROL_FREQUENCY_HZ;
    } else {
        current_linear_acceleration = 0.0f;
        control_linear_speed = std::min(control_linear_speed, forward_end_speed);
        if (forward_end_speed > 0.0f) {
            control_linear_speed = std::max(control_linear_speed, Config::min_move_speed);
        }
    }
}

void Navigation::configure_linear_pid() {
    if (current_movement == Movement::DIAGONAL) {
        control->set_wall_pid_enabled(false);
        const bool before_diagonal_end =
            std::abs(traveled_dist_mm) < (target_travel_mm - (CELL_DIAGONAL_SIZE_MM / 2.0f));
        control->set_diagonal_pid_enabled(before_diagonal_end);
        return;
    }

    if (current_movement == Movement::STOP) {
        control->set_wall_pid_enabled(false);
        control->set_diagonal_pid_enabled(false);
        return;
    }

    if (current_movement == Movement::FORWARD) {
        if (!is_search_mode(selected_mode)) {
            const bool before_forward_end =
                std::abs(traveled_dist_mm) < (target_travel_mm - FORWARD_WALL_PID_DISABLE_DISTANCE_MM);
            control->set_wall_pid_enabled(before_forward_end);
        } else {
            control->set_wall_pid_enabled(true);
        }

        control->set_diagonal_pid_enabled(false);
        return;
    }

    if (current_movement == Movement::START) {
        control->set_wall_pid_enabled(true);
        control->set_diagonal_pid_enabled(false);
        return;
    }

    control->set_wall_pid_enabled(false);
    control->set_diagonal_pid_enabled(false);
}

void Navigation::finish_linear_movement(float control_linear_speed) {
    const bool reached_target = std::abs(traveled_dist_mm) >= target_travel_mm;
    const bool finished_stop = current_movement == Movement::STOP && is_braking && control_linear_speed <= 0.0f;

    if (reached_target || finished_stop) {
        is_finished = true;
    }
}

void Navigation::step_linear_movement() {
    control->set_use_inplace_friction(false);

    if (current_movement == Movement::STOP) {
        forward_end_speed = 0.0f;
    }

    float max_speed = forward_params[current_movement].max_speed;
    if (continuous_start_to_forward) {
        max_speed = forward_end_speed;
    } else if (current_movement == Movement::START && forward_end_speed > 0.0f) {
        max_speed = std::min(max_speed, forward_end_speed);
    }
    const float max_acceleration = forward_params[current_movement].acceleration;
    const float deceleration = forward_params[current_movement].deceleration;
    float control_linear_speed = control->get_target_linear_speed();

    if (general_params.enable_wall_break_correction) {
        apply_wall_break_correction();
    }

    update_linear_target_speed(control_linear_speed, max_speed, max_acceleration, deceleration,
                               continuous_start_to_forward);

    control->set_target_linear_speed(control_linear_speed);
    control->set_target_angular_speed(0);
    configure_linear_pid();
    finish_linear_movement(control_linear_speed);
}

void Navigation::update_turn_linear_speed(float& control_linear_speed, float max_speed, float acceleration,
                                          float deceleration, float final_speed) {
    const float braking_distance_mm =
        MILLIMETERS_PER_METER * get_torricelli_distance(final_speed, control_linear_speed, -deceleration);
    const bool before_braking_point =
        !is_braking && (std::abs(traveled_dist_mm) < (target_travel_mm - braking_distance_mm));

    if (before_braking_point) {
        if (control_linear_speed < max_speed) {
            control_linear_speed += acceleration / Config::CONTROL_FREQUENCY_HZ;
            control_linear_speed = std::min(control_linear_speed, max_speed);
        }
    } else if (control_linear_speed > final_speed) {
        is_braking = true;
        control_linear_speed -= deceleration / Config::CONTROL_FREQUENCY_HZ;
        control_linear_speed = std::max(control_linear_speed, final_speed);
        if (final_speed > 0.0f) {
            control_linear_speed = std::max(control_linear_speed, Config::min_move_speed);
        }
    }
}

void Navigation::transition_after_turn_forward_1() {
    is_braking = false;
    if (is_turn_around_movement()) {
        control->set_target_linear_speed(0.0f);
        control->set_target_angular_speed(0.0f);
        control->set_motor_control_disabled(false);
        reference_time = bsp::get_tick_ms();
        mini_fsm_state = MiniFSMStates::STABILIZE_1;
        return;
    }

    traveled_dist_mm = 0;
    reference_time = bsp::get_tick_ms();
    turn_tick_counter = 0;
    mini_fsm_state = MiniFSMStates::TURN;
    current_angular_acceleration = 0.0f;
}

void Navigation::transition_after_turn_forward_2() {
    is_braking = false;
    is_finished = true;
    mini_fsm_state = MiniFSMStates::FORWARD_1;
}

void Navigation::step_turn_forward_1() {
    control->set_use_inplace_friction(false);
    control->set_wall_pid_enabled(false);
    control->set_diagonal_pid_enabled(false);

    const float max_speed = forward_params[current_movement].max_speed;
    const float acceleration = forward_params[current_movement].acceleration;
    const float deceleration = forward_params[current_movement].deceleration;
    const float final_speed = is_turn_around_movement() ? 0.0f : forward_params[current_movement].max_speed;

    float control_linear_speed = control->get_target_linear_speed();
    update_turn_linear_speed(control_linear_speed, max_speed, acceleration, deceleration, final_speed);

    control->set_target_linear_speed(control_linear_speed);
    control->set_target_angular_speed(0);

    const bool is_turn_around_stop = is_turn_around_movement();
    const bool reached_target = std::abs(traveled_dist_mm) >= target_travel_mm;
    const bool should_transition = is_turn_around_stop ? (is_braking && control_linear_speed <= 0.0f) : reached_target;

    if (should_transition) {
        transition_after_turn_forward_1();
    }
}

void Navigation::step_turn_forward_2() {
    control->set_use_inplace_friction(false);
    // control->set_wall_pid_enabled(true);
    control->set_wall_pid_enabled(false);
    control->set_diagonal_pid_enabled(false);

    const float max_speed = forward_params[current_movement].max_speed;
    const float acceleration = forward_params[current_movement].acceleration;
    const float deceleration = forward_params[current_movement].deceleration;
    const float final_speed = forward_params[current_movement].max_speed;

    float control_linear_speed = control->get_target_linear_speed();
    update_turn_linear_speed(control_linear_speed, max_speed, acceleration, deceleration, final_speed);

    control->set_target_linear_speed(control_linear_speed);
    control->set_target_angular_speed(0);

    if (std::abs(traveled_dist_mm) >= target_travel_mm) {
        transition_after_turn_forward_2();
    }
}

void Navigation::update_turn_angular_acceleration(const TurnParams& turn, uint32_t elapsed_time) {
    const float max_angular_acceleration = turn.angular_accel;
    const float max_angular_deceleration = -turn.angular_accel;
    const float control_frequency = Config::CONTROL_FREQUENCY_HZ;

    if (elapsed_time < turn.t_start_deccel) {
        if (turn.accel_ramp_up_jerk == 0 || turn.time_to_decrease_jerk_1 == 0) {
            current_angular_acceleration = max_angular_acceleration;
        } else if (elapsed_time < turn.time_to_decrease_jerk_1) {
            current_angular_acceleration += turn.accel_ramp_up_jerk / control_frequency;
            current_angular_acceleration = std::min(current_angular_acceleration, max_angular_acceleration);
        } else {
            current_angular_acceleration -= turn.accel_ramp_down_jerk / control_frequency;
            current_angular_acceleration = std::max(current_angular_acceleration, 0.0f);
        }
        return;
    }

    if (turn.accel_ramp_down_jerk == 0 || turn.time_to_decrease_jerk_2 == 0) {
        current_angular_acceleration = max_angular_deceleration;
    } else if (elapsed_time < turn.time_to_decrease_jerk_2) {
        current_angular_acceleration -= turn.accel_ramp_down_jerk / control_frequency;
        current_angular_acceleration = std::max(current_angular_acceleration, max_angular_deceleration);
    } else {
        current_angular_acceleration += turn.accel_ramp_up_jerk / control_frequency;
        current_angular_acceleration = std::min(current_angular_acceleration, 0.0f);
    }
}

void Navigation::transition_after_turn_rotation() {
    control->set_use_inplace_friction(false);

    if (is_turn_around_movement()) {
        control->set_target_angular_speed(0.0f);
        control->set_motor_control_disabled(true);
        reference_time = bsp::get_tick_ms();
        is_braking = false;
        mini_fsm_state = MiniFSMStates::STABILIZE_2;
        return;
    }

    if (is_search_turn_movement()) {
        control->set_target_angular_speed(0.0f);
        float end_target = -turn_params[current_movement].end;
        if (general_params.enable_lateral_correction_90) {
            end_target -= turn_end_correction_mm;
            turn_end_correction_mm = 0.0f;
        }
        target_travel_mm = std::max(0.0f, end_target);
        reference_time = bsp::get_tick_ms();
        traveled_dist_mm = 0;
        is_braking = false;
        mini_fsm_state = MiniFSMStates::FORWARD_2;
        return;
    }

    is_finished = true;
    mini_fsm_state = MiniFSMStates::FORWARD_1;
}

void Navigation::step_turn_rotation() {
    const auto current_turn_params = turn_params[current_movement];
    const float angular_max_speed = current_turn_params.max_angular_speed;
    float control_angular_speed_abs = std::abs(control->get_target_angular_speed());
    const int turn_sign = current_turn_params.sign;

    const uint32_t elapsed_time = turn_tick_counter;
    turn_tick_counter++;

    update_turn_angular_acceleration(current_turn_params, elapsed_time);

    control_angular_speed_abs += current_angular_acceleration / Config::CONTROL_FREQUENCY_HZ;
    control_angular_speed_abs = std::min(control_angular_speed_abs, angular_max_speed);
    control_angular_speed_abs = std::max(control_angular_speed_abs, 0.0f);

    control->set_target_angular_speed(control_angular_speed_abs * turn_sign);
    control->set_wall_pid_enabled(false);
    control->set_diagonal_pid_enabled(false);
    control->set_use_inplace_friction(is_turn_around_movement());

    if (turn_tick_counter >= turn_params[current_movement].t_stop) {
        transition_after_turn_rotation();
    }
}

void Navigation::step_turn_stabilize_1() {
    control->set_wall_pid_enabled(false);
    control->set_diagonal_pid_enabled(false);
    control->set_use_inplace_friction(false);

    if (!control->is_motor_control_disabled()) {
        control->set_target_linear_speed(0.0f);
        control->set_target_angular_speed(0.0f);

        const uint32_t braking_time = bsp::get_tick_ms() - reference_time;
        constexpr uint32_t MAX_BRAKE_TIMEOUT_MS = 500;
        if (std::abs(bsp::encoders::get_filtered_velocity_m_s()) >= STABILIZE_VELOCITY_THRESHOLD_M_S &&
            braking_time < MAX_BRAKE_TIMEOUT_MS) {
            return;
        }

        control->set_motor_control_disabled(true);
        reference_time = bsp::get_tick_ms();
        return;
    }

    const uint32_t elapsed_time = bsp::get_tick_ms() - reference_time;
    if (elapsed_time <= STABILIZE_FORWARD_TIME_MS) {
        return;
    }

    reference_time = bsp::get_tick_ms();
    control->reset(general_params);
    control->set_motor_control_disabled(false);
    traveled_dist_mm = 0;
    turn_tick_counter = 0;
    is_braking = false;
    mini_fsm_state = MiniFSMStates::TURN;
    current_angular_acceleration = 0.0f;
}

void Navigation::step_turn_stabilize_2() {
    control->set_wall_pid_enabled(false);
    control->set_diagonal_pid_enabled(false);
    control->set_use_inplace_friction(false);

    const uint32_t elapsed_time = bsp::get_tick_ms() - reference_time;
    if (elapsed_time <= STABILIZE_TURN_TIME_MS) {
        return;
    }

    reference_time = bsp::get_tick_ms();
    control->reset(general_params);
    control->set_motor_control_disabled(false);
    traveled_dist_mm = 0;
    is_braking = false;

    if (current_movement == Movement::TURN_AROUND_INPLACE) {
        is_finished = true;
        mini_fsm_state = MiniFSMStates::FORWARD_1;
    } else { // TURN_AROUND
        //target_travel_mm = std::abs(current_position_mm.x);
        target_travel_mm = -turn_params[current_movement].end;
        mini_fsm_state = MiniFSMStates::FORWARD_2;
    }
}

void Navigation::step_turn_movement() {
    // Mini FSM: FORWARD_1 -> TURN -> FORWARD_2, with stabilization when needed.
    switch (mini_fsm_state) {
    case MiniFSMStates::FORWARD_1:
        step_turn_forward_1();
        break;
    case MiniFSMStates::FORWARD_2:
        step_turn_forward_2();
        break;
    case MiniFSMStates::TURN:
        step_turn_rotation();
        break;
    case MiniFSMStates::STABILIZE_1:
        step_turn_stabilize_1();
        break;
    case MiniFSMStates::STABILIZE_2:
        step_turn_stabilize_2();
        break;
    default:
        is_finished = true;
        mini_fsm_state = MiniFSMStates::FORWARD_1;
        break;
    }
}

bool Navigation::step() {
    if (is_linear_movement(current_movement)) {
        step_linear_movement();
    } else if (is_turn_movement(current_movement)) {
        step_turn_movement();
    }

    if (is_finished) {
        update_cell_position_and_dir();
    }

    control->update();
    return is_finished;
}

Point Navigation::get_robot_cell_position(void) {
    return current_cell;
}

Position Navigation::get_robot_position_mm(void) {
    return current_position_mm;
}

Direction Navigation::get_robot_direction(void) {
    return current_direction;
}

float Navigation::get_robot_travelled_dist_mm() {
    return traveled_dist_mm;
}

void Navigation::set_movement(Direction dir) {
    previous_movement = current_movement;

    target_direction = dir;
    current_movement = get_movement(dir, current_direction, true);
    reset_movement_variables();

    target_travel_mm = forward_params[current_movement].target_travel_mm;

    if (general_params.enable_lateral_correction_90 && is_search_turn_movement()) {
        turn_end_correction_mm = calculate_turn_end_offset(current_movement);
    } else {
        turn_end_correction_mm = 0.0f;
    }

    if (current_movement == Movement::STOP) {
        forward_end_speed = 0;
    } else {
        forward_end_speed = forward_params[Movement::FORWARD].max_speed;
    }
}

Movement Navigation::get_movement(Direction target_dir, Direction current_dir, bool search_mode) {
    return algorithm::MovementPlanner::get_movement(target_dir, current_dir, search_mode);
}

void Navigation::update_cell_position_and_dir() {
    if (current_movement == Movement::TURN_AROUND_INPLACE) {
        switch (current_direction) {
        case Direction::NORTH:
            current_direction = Direction::SOUTH;
            break;
        case Direction::SOUTH:
            current_direction = Direction::NORTH;
            break;
        case Direction::EAST:
            current_direction = Direction::WEST;
            break;
        case Direction::WEST:
            current_direction = Direction::EAST;
            break;
        default:
            break;
        }
        target_direction = current_direction;
        return;
    }

    current_direction = target_direction;
    switch (current_direction) {
    case Direction::NORTH:
        current_cell.y++;
        break;
    case Direction::EAST:
        current_cell.x++;
        break;
    case Direction::SOUTH:
        current_cell.y--;
        break;
    case Direction::WEST:
        current_cell.x--;
        break;
    default:
        break;
    }
}

float Navigation::calculate_turn_end_offset(Movement movement) {
    using bsp::analog_sensors::ir_distance_mm;
    using bsp::analog_sensors::ir_reading_wall;
    using bsp::analog_sensors::SensingDirection;

    float lateral_error_mm = 0.0f;
    constexpr float DEG_TO_RAD = 3.14159265358979323846f / 180.0f;

    if (movement == Movement::TURN_LEFT_90 || movement == Movement::TURN_LEFT_90_SEARCH_MODE) {
        // Turning Left: check opposite (Right) wall
        if (ir_reading_wall(SensingDirection::RIGHT)) {
            const float cos_theta = std::cos(Config::right_sensor_angle_deg * DEG_TO_RAD);
            float measured_dist = ir_distance_mm(SensingDirection::RIGHT);
            float delta_l = measured_dist - Config::ir_wall_dist_ref_right; // positive when further from right wall
            lateral_error_mm = delta_l * cos_theta;
        }
    } else if (movement == Movement::TURN_RIGHT_90 || movement == Movement::TURN_RIGHT_90_SEARCH_MODE) {
        // Turning Right: check opposite (Left) wall
        if (ir_reading_wall(SensingDirection::LEFT)) {
            const float cos_theta = std::cos(Config::left_sensor_angle_deg * DEG_TO_RAD);
            float measured_dist = ir_distance_mm(SensingDirection::LEFT);
            float delta_l = measured_dist - Config::ir_wall_dist_ref_left; // positive when further from left wall
            lateral_error_mm = delta_l * cos_theta;
        }
    }

    // Clamp adjustment to guard against sensor anomalies
    lateral_error_mm = std::clamp(lateral_error_mm, -MAX_TURN_90_ERROR_CORRECTION, MAX_TURN_90_ERROR_CORRECTION);

    // If robot was further away from the opposite wall (+delta), the turn's ends +delta mm after
    return lateral_error_mm;
}

void Navigation::set_movement(Movement movement, Movement prev_movement, Movement next_movement, uint8_t count,
                              uint8_t next_move_count) {
    complete_prev_move_travel = -1 * turn_params[prev_movement].end;

    if (general_params.enable_lateral_correction_90) {
        if (prev_movement == Movement::TURN_LEFT_90 || prev_movement == Movement::TURN_RIGHT_90) {
            complete_prev_move_travel -= turn_end_correction_mm;
            turn_end_correction_mm = 0.0f;
        }

        if (movement == Movement::TURN_LEFT_90 || movement == Movement::TURN_RIGHT_90) {
            turn_end_correction_mm = calculate_turn_end_offset(movement);
        }
    }

    previous_movement = prev_movement;
    current_movement = movement;
    current_movement_count = count;

    continuous_start_to_forward =
        (movement == Movement::START && (next_movement == Movement::FORWARD || next_movement == Movement::DIAGONAL) &&
         next_move_count >= MIN_MOVEMENTS_FOR_SEAMLESS_START);
    const bool preserve_linear_accel =
        (prev_movement == Movement::START && (movement == Movement::FORWARD || movement == Movement::DIAGONAL) &&
         count >= MIN_MOVEMENTS_FOR_SEAMLESS_START);

    reset_movement_variables(!preserve_linear_accel);

    if (movement == Movement::FORWARD || movement == Movement::DIAGONAL) {
        if (waiting_for_fast_param && count > 1) {
            waiting_for_fast_param = false;
            if (selected_mode == FAST || selected_mode == SUPER) {
                configure_mode(selected_mode);
            }
        }
        target_travel_mm = complete_prev_move_travel + (forward_params[movement].target_travel_mm * count) +
                           turn_params[next_movement].start;
    } else if (movement == Movement::START) {
        if (is_turn_movement(next_movement)) {
            if (selected_mode == FAST || selected_mode == SUPER) {
                // This can happen if the robot is turning right after the start movement.
                waiting_for_fast_param = true;
                configure_mode(MEDIUM);
            }
        }
        target_travel_mm = forward_params[movement].target_travel_mm + turn_params[next_movement].start;
    } else {
        target_travel_mm = complete_prev_move_travel + forward_params[movement].target_travel_mm;
    }

    // When target travel is 0, we directly go to turn state
    if (target_travel_mm <= 0) {
        mini_fsm_state = MiniFSMStates::TURN;
        current_angular_acceleration = 0.0f;
        turn_tick_counter = 0;
    }

    if (movement == Movement::STOP) {
        forward_end_speed = 0;
        bsp::leds::stripe_set(Color::Blue);
    } else if (movement == Movement::START) {
        if (continuous_start_to_forward) {
            forward_end_speed = forward_params[next_movement].max_speed;
        } else if (is_turn_movement(next_movement)) {
            forward_end_speed = turn_params[next_movement].turn_linear_speed;
        } else if (next_movement == Movement::STOP) {
            forward_end_speed = 0.0f;
        } else {
            forward_end_speed = forward_params[Movement::START].max_speed;
        }
    } else if (next_movement == Movement::FORWARD || next_movement == Movement::DIAGONAL) {
        forward_end_speed = forward_params[next_movement].max_speed;
    } else if (next_movement == Movement::STOP) {
        forward_end_speed = forward_params[next_movement].max_speed;
    } else {
        forward_end_speed = turn_params[next_movement].turn_linear_speed;
    }
}

std::vector<std::pair<Movement, uint8_t>> Navigation::get_movements_to_goal(std::vector<Direction> target_directions,
                                                                            target_movement_mode_t mode) {
    std::vector<std::pair<Movement, uint8_t>> movements;

    switch (mode) {
    case target_movement_mode_t::NORMAL:
        movements = get_default_target_movements(target_directions);
        break;
    case target_movement_mode_t::SMOOTH:
        movements = get_smooth_movements(get_default_target_movements(target_directions));
        break;
    case target_movement_mode_t::DIAGONALS:
    case target_movement_mode_t::TIME_BASED:
        movements = get_diagonal_movements(get_default_target_movements(target_directions));
        break;
    case target_movement_mode_t::HARD_CODED:
        movements = get_hardcoded_movements();
        print_movement_sequence(movements, "Hard Coded");
        break;
    }

    return movements;
}

std::vector<std::pair<Movement, uint8_t>>
Navigation::get_default_target_movements(std::vector<Direction> target_directions) {
    auto default_target_movements = algorithm::MovementPlanner::get_default_target_movements(target_directions);
    print_movement_sequence(default_target_movements, "Default");
    return default_target_movements;
}

std::vector<std::pair<Movement, uint8_t>>
Navigation::get_smooth_movements(std::vector<std::pair<Movement, uint8_t>> default_target_movements) {
    auto smooth_movements = algorithm::MovementPlanner::get_smooth_movements(default_target_movements);
    print_movement_sequence(smooth_movements, "Smooth");
    return smooth_movements;
}

std::vector<std::pair<Movement, uint8_t>>
Navigation::get_diagonal_movements(std::vector<std::pair<Movement, uint8_t>> default_target_movements) {
    auto output_movements = algorithm::MovementPlanner::get_diagonal_movements(default_target_movements);
    print_movement_sequence(output_movements, "Diagonal");
    return output_movements;
}

std::vector<std::pair<Movement, uint8_t>> Navigation::get_hardcoded_movements() {
    return hardcoded_movements;
}

void Navigation::set_hardcoded_movements(std::vector<std::pair<Movement, uint8_t>> moves) {
    hardcoded_movements = moves;
}

void Navigation::print_movement_sequence(std::vector<std::pair<Movement, uint8_t>> movements, std::string name) {
    std::printf("%s: \r\n", name.c_str());
    bsp::delay_ms(2);
    for (auto movement : movements) {
        for (uint32_t i = 0; i < sizeof(movementInfoMap) / sizeof(movementInfoMap[0]); i++) {
            if (movementInfoMap[i].first == movement.first) {
                std::printf("%d - %s\r\n", movement.second, movementInfoMap[i].second);
                bsp::delay_ms(2);
                break;
            }
        }
    }
}
}
