team-raiju/fujin/firmware/src/services/logger.cpp

#include "utils/math.hpp"
#include <algorithm>
#include <array>
#include <cstdio>
#include <cstring>

#include "bsp/analog_sensors.hpp"
#include "bsp/ble.hpp"
#include "bsp/eeprom.hpp"
#include "bsp/leds.hpp"
#include "bsp/encoders.hpp"
#include "bsp/imu.hpp"
#include "bsp/timers.hpp"
#include "services/config.hpp"
#include "services/control.hpp"
#include "services/logger.hpp"
#include "services/navigation.hpp"

/// @section Constants

/// @section Service implementation

namespace services {

namespace {

constexpr uint32_t LED_START_PERIOD_MS = 1000;
constexpr uint32_t LED_END_PERIOD_MS = 50;

void update_led_progress(float progress, uint32_t& last_toggle_time, bool& led_state) {
    progress = std::clamp(progress, 0.0f, 1.0f);

    uint32_t current_period_ms = LED_START_PERIOD_MS - static_cast<uint32_t>((LED_START_PERIOD_MS - LED_END_PERIOD_MS) * progress);
    uint32_t half_period_ms = std::max<uint32_t>(1, current_period_ms / 2);

    uint32_t now = bsp::get_tick_ms();
    if (now - last_toggle_time >= half_period_ms) {
        last_toggle_time = now;
        led_state = !led_state;
        bsp::leds::stripe_set(led_state ? bsp::leds::Color::Red : bsp::leds::Color::Black);
    }
}

} // namespace


#if CONTROL_LOG_MODE
const Logger::ParamInfo paramInfoArray[] = {
    {32767, -5, 10, 2184.0f},     // velocity_ms
    {32767, -5, 10, 2184.0f},     // target_velocity_ms
    {65535, -45, 45, 728.0f},     // angular_speed_rad_s
    {65535, -45, 45, 728.0f},     // target_rad_s
    {1023, -1000, 1000, 0.5115f}, // pwm_left
    {1023, -1000, 1000, 0.5115f}, // pwm_right
    {1023, -5, 5, 102.3f},        // encoder_imu_diff
    {4095, -3, 3, 682.6f},        // vel_p
    {4095, -3, 3, 682.6f},        // vel_i
    {4095, -2, 2, 1023.0f},       // ang_p
    {4095, -2, 2, 1023.0f},       // ang_i
    {1023, -2, 2, 255.0f},        // rotation_ff
    {1023, -4, 4, 127.0f},        // linear_ff
    {255, 0, 13000, 0.0195f},     // battery
};
#else
const Logger::ParamInfo paramInfoArray[] = {
    {32767, -5, 10, 2184.0f},       // velocity_ms
    {32767, -5, 10, 2184.0f},       // target_velocity_ms
    {65535, -45, 45, 728.0f},       // angular_speed_rad_s
    {65535, -45, 45, 728.0f},       // target_rad_s
    {1023, -1000, 1000, 0.5115f},   // pwm_left
    {1023, -1000, 1000, 0.5115f},   // pwm_right
    {1023, -5, 5, 102.3f},          // encoder_imu_diff
    {65535, -250, 250, 131.0f},     // position_mm_x
    {65535, -250, 250, 131.0f},     // position_mm_y
    {16383, -180, 180, 45.5083f},   // angle
    {16383, -500, 12600, 1.25061f}, // distance_mm
    {1023, 0, 270, 3.7889f},        // sensor_distance_l
    {1023, 0, 270, 3.7889f},        // sensor_distance_fl
    {1023, 0, 270, 3.7889f},        // sensor_distance_fr
    {1023, 0, 270, 3.7889f},        // sensor_distance_r
};
#endif

// This prevents bugs if a new parameter is added to one but not the other.
static_assert(static_cast<size_t>(ParamIndex::COUNT) == std::size(paramInfoArray));

Logger* Logger::instance() {
    static Logger p;
    return &p;
}

void Logger::init() {
    reset();
}

void Logger::reset() {
    log_data_idx = 0;
    addr_offset = 0;
}

void Logger::save_size() {
    // bsp::eeprom::write_u32(bsp::eeprom::ADDR_LOGGER_SIZE, addr_offset);
}

float Logger::encode_value(float raw_value, const ParamInfo& info) const {
    float processed_value = (raw_value - info.min_param_value) * info.scale;
    processed_value = std::max(0.0f, processed_value);
    return std::min(processed_value, static_cast<float>(info.max_store_value));
}

float Logger::decode_value(float stored_value, const ParamInfo& info) const {
    return (stored_value / info.scale) + info.min_param_value;
}

void Logger::update() {

    if (addr_offset + sizeof(logdata) >= sizeof(ram_logger)) {
        return;
    }

    auto control = services::Control::instance();
    auto nav = services::Navigation::instance();

    auto& current_log_entry = logdata[log_data_idx].fields;

    current_log_entry.velocity_ms = encode_value(bsp::encoders::get_filtered_velocity_m_s(),
                                                 paramInfoArray[static_cast<size_t>(ParamIndex::VelocityMS)]);
    current_log_entry.target_velocity_ms = encode_value(
        control->get_target_linear_speed(), paramInfoArray[static_cast<size_t>(ParamIndex::TargetVelocityMS)]);
    current_log_entry.angular_speed_rad_s =
        encode_value(bsp::imu::get_rad_per_s(), paramInfoArray[static_cast<size_t>(ParamIndex::AngularSpeedRadS)]);
    current_log_entry.target_rad_s =
        encode_value(control->get_target_angular_speed(), paramInfoArray[static_cast<size_t>(ParamIndex::TargetRadS)]);
    current_log_entry.pwm_left =
        encode_value(control->get_pwm_duty_l(), paramInfoArray[static_cast<size_t>(ParamIndex::PwmLeft)]);
    current_log_entry.pwm_right =
        encode_value(control->get_pwm_duty_r(), paramInfoArray[static_cast<size_t>(ParamIndex::PwmRight)]);
    current_log_entry.encoder_imu_diff =
        encode_value(nav->get_encoder_imu_diff(), paramInfoArray[static_cast<size_t>(ParamIndex::EncoderImuDiff)]);
#if CONTROL_LOG_MODE
    current_log_entry.vel_p = encode_value(control->get_vel_pid().kp * control->get_vel_pid().previous_error,
                                           paramInfoArray[static_cast<size_t>(ParamIndex::VelP)]);
    current_log_entry.vel_i = encode_value(control->get_vel_pid().ki * control->get_vel_pid().integral,
                                           paramInfoArray[static_cast<size_t>(ParamIndex::VelI)]);
    current_log_entry.ang_p = encode_value(control->get_ang_vel_pid().kp * control->get_ang_vel_pid().previous_error,
                                           paramInfoArray[static_cast<size_t>(ParamIndex::AngP)]);
    current_log_entry.ang_i = encode_value(control->get_ang_vel_pid().ki * control->get_ang_vel_pid().integral,
                                           paramInfoArray[static_cast<size_t>(ParamIndex::AngI)]);
    current_log_entry.rotation_ff =
        encode_value(control->get_rotation_ff(), paramInfoArray[static_cast<size_t>(ParamIndex::RotationFF)]);

    current_log_entry.linear_ff =
        encode_value(control->get_linear_ff(), paramInfoArray[static_cast<size_t>(ParamIndex::LinearFF)]);
    current_log_entry.battery = encode_value(bsp::analog_sensors::battery_latest_reading_mv(),
                                             paramInfoArray[static_cast<size_t>(ParamIndex::Battery)]);
#else
    current_log_entry.position_mm_x =
        encode_value(nav->get_robot_position_mm().x, paramInfoArray[static_cast<size_t>(ParamIndex::PositionX)]);
    current_log_entry.position_mm_y =
        encode_value(nav->get_robot_position_mm().y, paramInfoArray[static_cast<size_t>(ParamIndex::PositionY)]);
    const float angle_deg = bsp::imu::get_angle() * ((180.0f / M_PI));
    current_log_entry.angle = encode_value(angle_deg, paramInfoArray[static_cast<size_t>(ParamIndex::Angle)]);

    current_log_entry.distance =
        encode_value(nav->get_robot_travelled_dist_mm(), paramInfoArray[static_cast<size_t>(ParamIndex::Distance)]);

    current_log_entry.sensor_distance_l = encode_value(
        bsp::analog_sensors::ir_distance_mm(bsp::analog_sensors::SensingDirection::LEFT),
        paramInfoArray[static_cast<size_t>(ParamIndex::SensorDistanceLeft)]);
    current_log_entry.sensor_distance_fl = encode_value(
        bsp::analog_sensors::ir_distance_mm(bsp::analog_sensors::SensingDirection::FRONT_LEFT),
        paramInfoArray[static_cast<size_t>(ParamIndex::SensorDistanceFrontLeft)]);
    current_log_entry.sensor_distance_fr = encode_value(
        bsp::analog_sensors::ir_distance_mm(bsp::analog_sensors::SensingDirection::FRONT_RIGHT),
        paramInfoArray[static_cast<size_t>(ParamIndex::SensorDistanceFrontRight)]);
    current_log_entry.sensor_distance_r = encode_value(
        bsp::analog_sensors::ir_distance_mm(bsp::analog_sensors::SensingDirection::RIGHT),
        paramInfoArray[static_cast<size_t>(ParamIndex::SensorDistanceRight)]);
#endif

    // --- Buffer Management ---
    log_data_idx++;
    if (log_data_idx >= std::size(logdata)) {
        log_data_idx = 0;
        memcpy(ram_logger + addr_offset, reinterpret_cast<uint8_t*>(logdata), sizeof(logdata));
        addr_offset += sizeof(logdata);
    }
}

void Logger::print_log() {

    uint32_t last_toggle_time = bsp::get_tick_ms();
    bool led_state = false;

    // Print current params
    services::Config::print_parameters();
#if CONTROL_LOG_MODE
    std::printf("t;Vel;TgtVel;AngVel;TgtAngVel;PWM_L;PWM_R;ImuDiff;VelP;VelI;AngP;AngI;RotFF;LinFF;Batt_mV\r\n");
#else
    std::printf("t;Vel;TgtVel;AngVel;TgtAngVel;PWM_L;PWM_R;ImuDiff;PosX;PosY;Angle;Dist;SensL;SensFL;SensFR;SensR\r\n");
#endif
    bsp::delay_ms(5);

    uint32_t saved_size = addr_offset;

    for (uint32_t i = 0; i < saved_size; i += sizeof(LogData)) {
        LogData read_logdata;
        if (i + sizeof(read_logdata.data) > sizeof(ram_logger)) {
            break;
        }

        float progress = (saved_size > 0) ? (static_cast<float>(i) / static_cast<float>(saved_size)) : 1.0f;
        update_led_progress(progress, last_toggle_time, led_state);

        memcpy(read_logdata.data, ram_logger + i, sizeof(read_logdata.data));
        uint32_t idx = i / sizeof(LogData);
        float time_ms = services::Config::ticks_to_ms(idx);

#if CONTROL_LOG_MODE
        std::printf(
            "%0.1f;%0.4f;%0.4f;%0.4f;%0.4f;%0.f;%0.f;%0.4f;%0.4f;%0.4f;%0.4f;%0.4f;%0.4f;%0.4f;%0.f\r\n", time_ms,
            decode_value(read_logdata.fields.velocity_ms, paramInfoArray[static_cast<size_t>(ParamIndex::VelocityMS)]),
            decode_value(read_logdata.fields.target_velocity_ms,
                         paramInfoArray[static_cast<size_t>(ParamIndex::TargetVelocityMS)]),
            decode_value(read_logdata.fields.angular_speed_rad_s,
                         paramInfoArray[static_cast<size_t>(ParamIndex::AngularSpeedRadS)]),
            decode_value(read_logdata.fields.target_rad_s, paramInfoArray[static_cast<size_t>(ParamIndex::TargetRadS)]),
            decode_value(read_logdata.fields.pwm_left, paramInfoArray[static_cast<size_t>(ParamIndex::PwmLeft)]),
            decode_value(read_logdata.fields.pwm_right, paramInfoArray[static_cast<size_t>(ParamIndex::PwmRight)]),
            decode_value(read_logdata.fields.encoder_imu_diff,
                         paramInfoArray[static_cast<size_t>(ParamIndex::EncoderImuDiff)]),
            decode_value(read_logdata.fields.vel_p, paramInfoArray[static_cast<size_t>(ParamIndex::VelP)]),
            decode_value(read_logdata.fields.vel_i, paramInfoArray[static_cast<size_t>(ParamIndex::VelI)]),
            decode_value(read_logdata.fields.ang_p, paramInfoArray[static_cast<size_t>(ParamIndex::AngP)]),
            decode_value(read_logdata.fields.ang_i, paramInfoArray[static_cast<size_t>(ParamIndex::AngI)]),
            decode_value(read_logdata.fields.rotation_ff, paramInfoArray[static_cast<size_t>(ParamIndex::RotationFF)]),
            decode_value(read_logdata.fields.linear_ff, paramInfoArray[static_cast<size_t>(ParamIndex::LinearFF)]),
            decode_value(read_logdata.fields.battery, paramInfoArray[static_cast<size_t>(ParamIndex::Battery)]));
#else
        std::printf(
            "%0.1f;%0.4f;%0.4f;%0.4f;%0.4f;%0.f;%0.f;%0.4f;%0.4f;%0.4f;%0.4f;%0.4f;%0.1f;%0.1f;%0.1f;%0.1f\r\n", time_ms,
            decode_value(read_logdata.fields.velocity_ms, paramInfoArray[static_cast<size_t>(ParamIndex::VelocityMS)]),
            decode_value(read_logdata.fields.target_velocity_ms,
                         paramInfoArray[static_cast<size_t>(ParamIndex::TargetVelocityMS)]),
            decode_value(read_logdata.fields.angular_speed_rad_s,
                         paramInfoArray[static_cast<size_t>(ParamIndex::AngularSpeedRadS)]),
            decode_value(read_logdata.fields.target_rad_s, paramInfoArray[static_cast<size_t>(ParamIndex::TargetRadS)]),
            decode_value(read_logdata.fields.pwm_left, paramInfoArray[static_cast<size_t>(ParamIndex::PwmLeft)]),
            decode_value(read_logdata.fields.pwm_right, paramInfoArray[static_cast<size_t>(ParamIndex::PwmRight)]),
            decode_value(read_logdata.fields.encoder_imu_diff,
                         paramInfoArray[static_cast<size_t>(ParamIndex::EncoderImuDiff)]),
            decode_value(read_logdata.fields.position_mm_x, paramInfoArray[static_cast<size_t>(ParamIndex::PositionX)]),
            decode_value(read_logdata.fields.position_mm_y, paramInfoArray[static_cast<size_t>(ParamIndex::PositionY)]),
            decode_value(read_logdata.fields.angle, paramInfoArray[static_cast<size_t>(ParamIndex::Angle)]),
            decode_value(read_logdata.fields.distance, paramInfoArray[static_cast<size_t>(ParamIndex::Distance)]),
            decode_value(read_logdata.fields.sensor_distance_l,
                         paramInfoArray[static_cast<size_t>(ParamIndex::SensorDistanceLeft)]),
            decode_value(read_logdata.fields.sensor_distance_fl,
                         paramInfoArray[static_cast<size_t>(ParamIndex::SensorDistanceFrontLeft)]),
            decode_value(read_logdata.fields.sensor_distance_fr,
                         paramInfoArray[static_cast<size_t>(ParamIndex::SensorDistanceFrontRight)]),
            decode_value(read_logdata.fields.sensor_distance_r,
                         paramInfoArray[static_cast<size_t>(ParamIndex::SensorDistanceRight)]));
#endif

        bsp::delay_ms(3);
    }

    bsp::leds::stripe_set(bsp::leds::Color::Black);
}

void Logger::send_log_ble() {

#if CONTROL_LOG_MODE
#else
    uint32_t last_toggle_time = bsp::get_tick_ms();
    bool led_state = false;

    uint32_t saved_size = addr_offset;
    uint8_t packet[18] = {0};
    packet[0] = bsp::ble::header;
    packet[1] = bsp::ble::BlePacketType::RequestLogData;

    for (uint32_t i = 0; i < saved_size; i += sizeof(LogData)) {
        LogData read_logdata;
        if (i + sizeof(read_logdata.data) > sizeof(ram_logger)) {
            break;
        }

        float progress = (saved_size > 0) ? (static_cast<float>(i) / static_cast<float>(saved_size)) : 1.0f;
        update_led_progress(progress, last_toggle_time, led_state);

        memcpy(read_logdata.data, ram_logger + i, sizeof(read_logdata.data));

        bsp::ble::BleLogData ble_data = {
            .velocity_ms = static_cast<uint16_t>(read_logdata.fields.velocity_ms),
            .target_velocity_ms = static_cast<uint16_t>(read_logdata.fields.target_velocity_ms),
            .angular_speed_rad_s = static_cast<uint16_t>(read_logdata.fields.angular_speed_rad_s),
            .target_rad_s = static_cast<uint16_t>(read_logdata.fields.target_rad_s),
            .pwm_left = static_cast<uint16_t>(read_logdata.fields.pwm_left),
            .pwm_right = static_cast<uint16_t>(read_logdata.fields.pwm_right),
            .angle = static_cast<uint16_t>(read_logdata.fields.angle),
            .distance = static_cast<uint16_t>(read_logdata.fields.distance),
        };

        memcpy(packet + 2, &ble_data, sizeof(ble_data));

        bsp::ble::transmit(packet, sizeof(packet));
        bsp::delay_ms(5);
    }

    bsp::leds::stripe_set(bsp::leds::Color::Black);
#endif
}
}
