team-raiju/fujin/firmware/src/fsm/states/search.cpp

#include <cstdio>

#include "algorithms/pid.hpp"
#include "bsp/analog_sensors.hpp"
#include "bsp/ble.hpp"
#include "bsp/buttons.hpp"
#include "bsp/buzzer.hpp"
#include "bsp/core.hpp"
#include "bsp/debug.hpp"
#include "bsp/encoders.hpp"
#include "bsp/fan.hpp"
#include "bsp/imu.hpp"
#include "bsp/leds.hpp"
#include "bsp/motors.hpp"
#include "bsp/timers.hpp"
#include "fsm/state.hpp"
#include "services/config.hpp"
#include "services/control.hpp"
#include "services/maze.hpp"
#include "services/navigation.hpp"
#include "services/notification.hpp"
#include "utils/math.hpp"
#include "utils/soft_timer.hpp"

using bsp::leds::Color;
using services::Maze;
using services::Navigation;

namespace fsm {

static bool indicate_read = false;
static bool full_explore = false;
static bool explore_from_backup = false;

void PreSearch::enter() {

    bsp::debug::print("state:PreSearch");

    bsp::leds::stripe_set(Color::Green, Color::Black);
    bsp::leds::stripe_send();

    bsp::motors::set(0, 0);
}

State* PreSearch::react(BleCommand const&) {
    return nullptr;
}

State* PreSearch::react(ButtonPressed const& event) {
    if (event.button == ButtonPressed::SHORT1) {
        return &State::get<Idle>();
    }

    if (event.button == ButtonPressed::SHORT2) {
        return &State::get<PreRun>();
    }

    if (event.button == ButtonPressed::LONG1) {
        return &State::get<SearchParamSelect>();
    }

    return nullptr;
}

SearchParamSelect::SearchParamSelect() {
    navigation = services::Navigation::instance();
    param_type = PARAM_CUSTOM;
}

void SearchParamSelect::enter() {
    bsp::leds::stripe_set(bsp::leds::Color::Blue, bsp::leds::Color::Black);
    param_type = PARAM_CUSTOM;
    bsp::debug::print("state:SearchParamSelect");
}

State* SearchParamSelect::react(ButtonPressed const& event) {
    if (event.button == ButtonPressed::SHORT2) {
        if (param_type == PARAM_CUSTOM) {
            param_type = PARAM_SLOW;
            bsp::leds::stripe_set(bsp::leds::Color::Blue, bsp::leds::Color::Blue);
        } else if (param_type == PARAM_SLOW) {
            param_type = PARAM_MEDIUM;
            bsp::leds::stripe_set(bsp::leds::Color::Orange, bsp::leds::Color::Black);
        } else if (param_type == PARAM_MEDIUM) {
            param_type = PARAM_FAST;
            bsp::leds::stripe_set(bsp::leds::Color::Orange, bsp::leds::Color::Orange);
        } else { // param_type == PARAM_FAST
            param_type = PARAM_CUSTOM;
            bsp::leds::stripe_set(bsp::leds::Color::Blue, bsp::leds::Color::Black);
        }
        return nullptr;
    }

    if (event.button == ButtonPressed::SHORT1) {
        if (param_type == PARAM_CUSTOM) {
            param_type = PARAM_FAST;
            bsp::leds::stripe_set(bsp::leds::Color::Orange, bsp::leds::Color::Orange);
        } else if (param_type == PARAM_FAST) {
            param_type = PARAM_MEDIUM;
            bsp::leds::stripe_set(bsp::leds::Color::Orange, bsp::leds::Color::Black);
        } else if (param_type == PARAM_MEDIUM) {
            param_type = PARAM_SLOW;
            bsp::leds::stripe_set(bsp::leds::Color::Blue, bsp::leds::Color::Blue);
        } else { // param_type == PARAM_SLOW
            param_type = PARAM_CUSTOM;
            bsp::leds::stripe_set(bsp::leds::Color::Blue, bsp::leds::Color::Black);
        }
        return nullptr;
    }

    if (event.button == ButtonPressed::LONG1) {
        switch (param_type) {
        case PARAM_CUSTOM:
            navigation->reset(services::Navigation::CUSTOM);
            std::printf("Custom params\r\n");
            break;
        case PARAM_SLOW:
            navigation->reset(services::Navigation::SEARCH_SLOW);
            std::printf("Slow params\r\n");
            break;
        case PARAM_MEDIUM:
            navigation->reset(services::Navigation::SEARCH_MEDIUM);
            std::printf("Medium params\r\n");
            break;
        case PARAM_FAST:
            navigation->reset(services::Navigation::SEARCH_FAST);
            std::printf("Fast params\r\n");
            break;
        }
        return &State::get<SearchExploreModeSelect>();
    }

    if (event.button == ButtonPressed::LONG2) {
        return &State::get<PreSearch>();
    }
    return nullptr;
}

SearchExploreModeSelect::SearchExploreModeSelect() {
    navigation = services::Navigation::instance();
    explore_type = EXPLORE_NORMAL;
    full_explore = false;
    explore_from_backup = false;
}

void SearchExploreModeSelect::enter() {
    bsp::leds::stripe_set(bsp::leds::Color::Pink, bsp::leds::Color::Black);
    explore_type = EXPLORE_NORMAL;
    bsp::debug::print("state:SearchExploreModeSelect");
}

State* SearchExploreModeSelect::react(ButtonPressed const& event) {
    if (event.button == ButtonPressed::SHORT2) {
        if (explore_type == EXPLORE_NORMAL) {
            explore_type = EXPLORE_FULL;
            bsp::leds::stripe_set(bsp::leds::Color::Pink, bsp::leds::Color::Pink);
        } else if (explore_type == EXPLORE_FULL) {
            explore_type = EXPLORE_FULL_FROM_BACKUP;
            bsp::leds::stripe_set(bsp::leds::Color::Yellow, bsp::leds::Color::Yellow);
        } else {
            explore_type = EXPLORE_NORMAL;
            bsp::leds::stripe_set(bsp::leds::Color::Pink, bsp::leds::Color::Black);
        }
        return nullptr;
    }

    if (event.button == ButtonPressed::SHORT1) {
        if (explore_type == EXPLORE_NORMAL) {
            explore_type = EXPLORE_FULL_FROM_BACKUP;
            bsp::leds::stripe_set(bsp::leds::Color::Yellow, bsp::leds::Color::Yellow);
        } else if (explore_type == EXPLORE_FULL_FROM_BACKUP) {
            explore_type = EXPLORE_FULL;
            bsp::leds::stripe_set(bsp::leds::Color::Pink, bsp::leds::Color::Pink);
        } else {
            explore_type = EXPLORE_NORMAL;
            bsp::leds::stripe_set(bsp::leds::Color::Pink, bsp::leds::Color::Black);
        }
        return nullptr;
    }

    if (event.button == ButtonPressed::LONG1) {
        switch (explore_type) {
        case EXPLORE_NORMAL:
            std::printf("Explore Normal\r\n");
            full_explore = false;
            explore_from_backup = false;
            break;
        case EXPLORE_FULL:
            std::printf("Explore Full\r\n");
            full_explore = true;
            explore_from_backup = false;
            break;
        case EXPLORE_FULL_FROM_BACKUP:
            std::printf("Explore Full From Backup\r\n");
            full_explore = true;
            explore_from_backup = true;
            break;
        }
        return &State::get<SearchWaitStart>();
    }

    if (event.button == ButtonPressed::LONG2) {
        return &State::get<SearchParamSelect>();
    }
    return nullptr;
}

void SearchWaitStart::enter() {

    bsp::debug::print("state:SearchWaitStart");

    bsp::leds::stripe_set(Color::White);

    bsp::motors::set(0, 0);
    bsp::fan::set(0);

    /* Only start IR if powered by the battery */
    if (bsp::analog_sensors::battery_latest_reading_mv_real() > 7000) {
        soft_timer::start(services::Config::ms_to_ticks(100), soft_timer::SINGLE);
    }
}

State* SearchWaitStart::react(Timeout const&) {
    using bsp::analog_sensors::ir_start_condition;
    using bsp::analog_sensors::SensingDirection;

    bsp::leds::ir_emitter_on(bsp::leds::LEFT_FRONT);
    bsp::leds::ir_emitter_on(bsp::leds::RIGHT_FRONT);
    bsp::analog_sensors::enable_modulation();
    bsp::delay_ms(5);

    for (int i = 0; i < 400; i++) {
        if (!ir_start_condition()) {
            soft_timer::start(services::Config::ms_to_ticks(100), soft_timer::SINGLE);
            bsp::leds::ir_emitter_all_off();
            bsp::analog_sensors::enable_modulation(false);
            return &State::get<SearchWaitStart>();
        }
        bsp::delay_ms(1);
    }

    return &State::get<Search>();
}

State* SearchWaitStart::react(BleCommand const&) {
    return nullptr;
}

State* SearchWaitStart::react(ButtonPressed const& event) {
    if (event.button == ButtonPressed::LONG1) {
        return &State::get<Search>();
    }

    if (event.button == ButtonPressed::LONG2) {
        return &State::get<PreSearch>();
    }

    return nullptr;
}

Search::Search() {
    navigation = services::Navigation::instance();
    maze = services::Maze::instance();
    notification = services::Notification::instance();
    targets = services::Maze::GOAL_POSITIONS;
}

void Search::enter() {
    bsp::buttons::enable(false);
    bsp::debug::print("state:Search");
    bsp::leds::indication_on();
    bsp::leds::stripe_set(Color::Red);
    bsp::leds::ir_emitter_all_on();
    bsp::analog_sensors::enable_modulation();

    bsp::buzzer::start();
    bsp::delay_ms(2000);
    bsp::buzzer::stop();

    navigation->reset();

    if (explore_from_backup) {
        maze->read_maze_from_memory(true);
        returning = true;
        save_maze = true;
        unvisited_target = maze->closest_unvisited(services::Maze::ORIGIN);
        if (unvisited_target == services::Maze::ORIGIN) {
            unvisited_target = {0, 1};
        }
        targets = std::span<const Point>(&unvisited_target, 1);
    } else {
        maze->reset();
        returning = false;
        save_maze = false;
        targets = services::Maze::GOAL_POSITIONS;
    }

    services::Control::instance()->start_fan();
    bsp::delay_ms(500);

    bsp::encoders::reset();
    bsp::imu::reset_angle();

    soft_timer::start(1, soft_timer::CONTINUOUS);

    indicate_read = false;
    stop_next_move = false;
    emergency = false;
}

State* Search::react(BleCommand const&) {
    return nullptr;
}

State* Search::react(ButtonPressed const& event) {
    if (event.button == ButtonPressed::SHORT1) {
        return &State::get<Idle>();
    }

    if (event.button == ButtonPressed::SHORT2) {
        return &State::get<Idle>();
    }

    if (event.button == ButtonPressed::LONG1) {
        return &State::get<Idle>();
    }

    if (event.button == ButtonPressed::LONG2) {
        return &State::get<Idle>();
    }

    return nullptr;
}

State* Search::react(Timeout const&) {
    using bsp::analog_sensors::SensingDirection;
    using bsp::analog_sensors::SensingStatus;

    if (indicate_read && std::abs(navigation->get_robot_travelled_dist_mm()) >= 90.0f) {
        bsp::leds::stripe_set(Color::Black);
        indicate_read = false;
        bsp::buzzer::stop();
    }

    notification->update();
    navigation->update();
    bool done = navigation->step();

    if (done) {
        if (stop_next_move) {
            return &State::get<Idle>();
            // stop_next_move = false;
            // returning = false;
            // target = services::Maze::GOAL_POSITIONS[0];
            // save_maze = false;
            // maze->reset();
        }

        SensingStatus sensingStatus = bsp::analog_sensors::ir_get_sensing_status();

        indicate_read = true;
        bsp::leds::stripe_set(Color::Black);
        bsp::leds::stripe_set(Color::Green);

        auto robot_cell_pos = navigation->get_robot_cell_position();
        auto robot_dir = navigation->get_robot_direction();

        uint8_t walls =
            (sensingStatus.front_seeing * N | sensingStatus.right_seeing * E | sensingStatus.left_seeing * W)
            << robot_dir;

        auto dir = maze->next_step(robot_cell_pos, walls, targets, true);

        bool main_goal_reached =
            std::any_of(std::begin(services::Maze::GOAL_POSITIONS), std::end(services::Maze::GOAL_POSITIONS),
                        [&](const Point& goal) { return goal == robot_cell_pos; });

        if (!returning && main_goal_reached) {
            bsp::buzzer::start();
            bsp::leds::stripe_set(Color::White);
            save_maze = true;
            returning = true;
            maze->create_maze_backup();
        }

        if (dir == Direction::STOP && targets.size() == 1 && targets[0] == services::Maze::ORIGIN) {
            navigation->set_movement(Movement::TURN_AROUND_INPLACE, Movement::FORWARD, Movement::STOP, 1, 1);
            // navigation->set_movement(Direction::NORTH);
            stop_next_move = true;
        } else if (dir == Direction::STOP) {
            if (full_explore) {
                unvisited_target = maze->closest_unvisited(robot_cell_pos);
                if (unvisited_target == services::Maze::ORIGIN) { // Maze fully explored
                    bsp::buzzer::start();
                    bsp::leds::stripe_set(Color::White);
                    navigation->set_movement(Movement::TURN_AROUND_INPLACE, Movement::FORWARD, Movement::STOP, 1, 1);
                    stop_next_move = true;
                } else {
                    targets = std::span<const Point>(&unvisited_target, 1);
                }
            } else {
                targets = services::Maze::ORIGIN_ARRAY;
            }

            if (!stop_next_move) {
                auto dir = maze->next_step(robot_cell_pos, walls, targets, true);
                navigation->set_movement(dir);
            }
        } else {
            navigation->set_movement(dir);
        }
    }

    if ((bsp::imu::is_imu_emergency() || services::Control::instance()->is_emergency())) {
        emergency = true;
        soft_timer::stop();
        bsp::motors::set(0, 0);
        bsp::fan::set(0);
        bsp::leds::stripe_set(Color::Orange);
        bsp::buzzer::start();
        bsp::delay_ms(500);
        bsp::buzzer::stop();
        return &State::get<Idle>();
    }

    return nullptr;
}

void Search::exit() {
    bsp::motors::set(0, 0);
    if (!emergency) {
        services::Control::instance()->stop_fan();
    }
    bsp::analog_sensors::enable_modulation(false);
    bsp::leds::ir_emitter_all_off();
    bsp::leds::indication_off();
    soft_timer::stop();
    if (save_maze) {
        bsp::buzzer::start();
        if (!explore_from_backup) {
            maze->save_maze_to_memory(true);
        }
        maze->save_maze_to_memory(false);
        bsp::delay_ms(500);
        bsp::buzzer::stop();
    }
    bsp::buttons::enable(true);
}

}
