team-raiju/fujin/firmware/src/fsm/states/run.cpp

#include <cstdio>

#include "algorithms/pid.hpp"
#include "bsp/analog_sensors.hpp"
#include "bsp/ble.hpp"
#include "bsp/buttons.hpp"
#include "bsp/buzzer.hpp"
#include "bsp/core.hpp"
#include "bsp/debug.hpp"
#include "bsp/fan.hpp"
#include "bsp/imu.hpp"
#include "bsp/leds.hpp"
#include "bsp/motors.hpp"
#include "bsp/timers.hpp"
#include "fsm/state.hpp"
#include "services/config.hpp"
#include "services/control.hpp"
#include "services/logger.hpp"
#include "services/maze.hpp"
#include "services/navigation.hpp"
#include "utils/math.hpp"
#include "utils/soft_timer.hpp"

using bsp::leds::Color;

namespace fsm {

static bool indicate_read = false;
static services::Navigation::target_movement_mode_t move_mode = services::Navigation::SMOOTH;
static bool map_backup = false;

void PreRun::enter() {

    bsp::debug::print("state:PreRun");

    bsp::leds::stripe_set(Color::Green);

    bsp::motors::set(0, 0);
    bsp::fan::set(0);
}

State* PreRun::react(BleCommand const&) {
    return nullptr;
}

State* PreRun::react(ButtonPressed const& event) {
    if (event.button == ButtonPressed::SHORT1) {
        return &State::get<PreSearch>();
    }

    if (event.button == ButtonPressed::SHORT2) {
        return &State::get<PreCalib>();
    }

    if (event.button == ButtonPressed::LONG1) {
        return &State::get<RunParamSelect>();
    }

    return nullptr;
}

RunParamSelect::RunParamSelect() {
    navigation = services::Navigation::instance();
    param_type = PARAM_CUSTOM;
}

void RunParamSelect::enter() {
    bsp::leds::stripe_set(bsp::leds::Color::Blue, bsp::leds::Color::Black);
    param_type = PARAM_CUSTOM;
    bsp::debug::print("state:RunParamSelect");
}

State* RunParamSelect::react(ButtonPressed const& event) {
    if (event.button == ButtonPressed::SHORT2) {
        if (param_type == PARAM_CUSTOM) {
            param_type = PARAM_SLOW;
            bsp::leds::stripe_set(bsp::leds::Color::Blue, bsp::leds::Color::Blue);
        } else if (param_type == PARAM_SLOW) {
            param_type = PARAM_MEDIUM;
            bsp::leds::stripe_set(bsp::leds::Color::Orange, bsp::leds::Color::Black);
        } else if (param_type == PARAM_MEDIUM) {
            param_type = PARAM_FAST;
            bsp::leds::stripe_set(bsp::leds::Color::Orange, bsp::leds::Color::Orange);
        } else if (param_type == PARAM_FAST) {
            param_type = PARAM_SUPER;
            bsp::leds::stripe_set(bsp::leds::Color::White, bsp::leds::Color::White);
        } else { // param_type == PARAM_SUPER
            param_type = PARAM_CUSTOM;
            bsp::leds::stripe_set(bsp::leds::Color::Blue, bsp::leds::Color::Black);
        }
        return nullptr;
    }

    if (event.button == ButtonPressed::SHORT1) {
        if (param_type == PARAM_CUSTOM) {
            param_type = PARAM_SUPER;
            bsp::leds::stripe_set(bsp::leds::Color::White, bsp::leds::Color::White);
        } else if (param_type == PARAM_SUPER) {
            param_type = PARAM_FAST;
            bsp::leds::stripe_set(bsp::leds::Color::Orange, bsp::leds::Color::Orange);
        } else if (param_type == PARAM_FAST) {
            param_type = PARAM_MEDIUM;
            bsp::leds::stripe_set(bsp::leds::Color::Orange, bsp::leds::Color::Black);
        } else if (param_type == PARAM_MEDIUM) {
            param_type = PARAM_SLOW;
            bsp::leds::stripe_set(bsp::leds::Color::Blue, bsp::leds::Color::Blue);
        } else { // param_type == PARAM_SLOW
            param_type = PARAM_CUSTOM;
            bsp::leds::stripe_set(bsp::leds::Color::Blue, bsp::leds::Color::Black);
        }
        return nullptr;
    }

    if (event.button == ButtonPressed::LONG1) {
        switch (param_type) {
        case PARAM_CUSTOM:
            navigation->reset(services::Navigation::CUSTOM);
            std::printf("Custom params\r\n");
            break;
        case PARAM_SLOW:
            navigation->reset(services::Navigation::SLOW);
            std::printf("Slow params\r\n");
            break;
        case PARAM_MEDIUM:
            navigation->reset(services::Navigation::MEDIUM);
            std::printf("Medium params\r\n");
            break;
        case PARAM_FAST:
            navigation->reset(services::Navigation::FAST);
            std::printf("Fast params\r\n");
            break;
        case PARAM_SUPER:
            navigation->reset(services::Navigation::SUPER);
            std::printf("Super params\r\n");
            break;
        }
        return &State::get<RunMoveModeSelect>();
    }

    if (event.button == ButtonPressed::LONG2) {
        return &State::get<PreRun>();
    }
    return nullptr;
}

RunMoveModeSelect::RunMoveModeSelect() {
    move_mode = services::Navigation::SMOOTH;
}

void RunMoveModeSelect::enter() {
    bsp::leds::stripe_set(bsp::leds::Color::Pink, bsp::leds::Color::Black);
    move_mode = services::Navigation::SMOOTH;
    std::printf("state:RunMoveModeSelect\r\n");
}

State* RunMoveModeSelect::react(ButtonPressed const& event) {

    if (event.button == ButtonPressed::SHORT2) {
        if (move_mode == services::Navigation::SMOOTH) {
            move_mode = services::Navigation::DIAGONALS;
            bsp::leds::stripe_set(bsp::leds::Color::Pink, bsp::leds::Color::Pink);
        } else if (move_mode == services::Navigation::DIAGONALS) {
            move_mode = services::Navigation::TIME_BASED;
            bsp::leds::stripe_set(bsp::leds::Color::Cyan, bsp::leds::Color::Cyan);
        } else if (move_mode == services::Navigation::TIME_BASED) {
            move_mode = services::Navigation::HARD_CODED;
            bsp::leds::stripe_set(bsp::leds::Color::Red, bsp::leds::Color::Black);
        } else { // move_mode == services::Navigation::HARD_CODED
            move_mode = services::Navigation::SMOOTH;
            bsp::leds::stripe_set(bsp::leds::Color::Pink, bsp::leds::Color::Black);
        }
        return nullptr;
    }

    if (event.button == ButtonPressed::SHORT1) {
        if (move_mode == services::Navigation::SMOOTH) {
            move_mode = services::Navigation::HARD_CODED;
            bsp::leds::stripe_set(bsp::leds::Color::Red, bsp::leds::Color::Black);
        } else if (move_mode == services::Navigation::HARD_CODED) {
            move_mode = services::Navigation::TIME_BASED;
            bsp::leds::stripe_set(bsp::leds::Color::Cyan, bsp::leds::Color::Cyan);
        } else if (move_mode == services::Navigation::TIME_BASED) {
            move_mode = services::Navigation::DIAGONALS;
            bsp::leds::stripe_set(bsp::leds::Color::Pink, bsp::leds::Color::Pink);
        } else { // move_mode == services::Navigation::DIAGONALS
            move_mode = services::Navigation::SMOOTH;
            bsp::leds::stripe_set(bsp::leds::Color::Pink, bsp::leds::Color::Black);
        }
        return nullptr;
    }

    if (event.button == ButtonPressed::LONG1) {
        std::printf("Selected move mode: ");
        switch (move_mode) {
        case services::Navigation::SMOOTH:
            std::printf("SMOOTH\r\n");
            break;
        case services::Navigation::DIAGONALS:
            std::printf("DIAGONALS\r\n");
            break;
        case services::Navigation::TIME_BASED:
            std::printf("TIME_BASED\r\n");
            break;
        case services::Navigation::HARD_CODED:
            std::printf("HARD_CODED\r\n");
            break;
        default:
            break;
        }
        return &State::get<RunMapSelect>();
    }

    if (event.button == ButtonPressed::LONG2) {
        return &State::get<RunParamSelect>();
    }

    return nullptr;
}

RunMapSelect::RunMapSelect() {
    map_backup = false;
}

void RunMapSelect::enter() {
    // When entering the state, set the LED for the default selection: SMOOTH (Green, Black)
    bsp::leds::stripe_set(bsp::leds::Color::Yellow, bsp::leds::Color::Black);
    map_backup = false;
    std::printf("state:RunMapSelect\r\n");
}

State* RunMapSelect::react(ButtonPressed const& event) {

    if (event.button == ButtonPressed::SHORT2) {
        if (!map_backup) {
            map_backup = true;
            bsp::leds::stripe_set(bsp::leds::Color::Yellow, bsp::leds::Color::Yellow);
        } else {
            map_backup = false;
            bsp::leds::stripe_set(bsp::leds::Color::Yellow, bsp::leds::Color::Black);
        }
        return nullptr;
    }

    if (event.button == ButtonPressed::SHORT1) {
        if (!map_backup) {
            map_backup = true;
            bsp::leds::stripe_set(bsp::leds::Color::Yellow, bsp::leds::Color::Yellow);
        } else {
            map_backup = false;
            bsp::leds::stripe_set(bsp::leds::Color::Yellow, bsp::leds::Color::Black);
        }
        return nullptr;
    }

    if (event.button == ButtonPressed::LONG1) {
        return &State::get<RunWaitStart>();
    }

    if (event.button == ButtonPressed::LONG2) {
        return &State::get<RunMoveModeSelect>();
    }

    return nullptr;
}

void RunWaitStart::enter() {

    bsp::debug::print("state:RunWaitStart");

    bsp::leds::stripe_set(Color::Green);

    bsp::motors::set(0, 0);
    bsp::fan::set(0);

    /* Only start IR if powered by the battery */
    if (bsp::analog_sensors::battery_latest_reading_mv_real() > 7000) {
        soft_timer::start(services::Config::ms_to_ticks(100), soft_timer::SINGLE);
    }
}

State* RunWaitStart::react(Timeout const&) {
    using bsp::analog_sensors::ir_start_condition;
    using bsp::analog_sensors::SensingDirection;

    bsp::leds::ir_emitter_on(bsp::leds::LEFT_FRONT);
    bsp::leds::ir_emitter_on(bsp::leds::RIGHT_FRONT);
    bsp::analog_sensors::enable_modulation();
    bsp::delay_ms(5);

    for (int i = 0; i < 400; i++) {
        if (!ir_start_condition()) {
            soft_timer::start(services::Config::ms_to_ticks(100), soft_timer::SINGLE);
            bsp::leds::ir_emitter_all_off();
            bsp::analog_sensors::enable_modulation(false);
            return &State::get<RunWaitStart>();
        }
        bsp::delay_ms(1);
    }

    return &State::get<Run>();
}

State* RunWaitStart::react(BleCommand const&) {
    return nullptr;
}

State* RunWaitStart::react(ButtonPressed const& event) {

    if (event.button == ButtonPressed::LONG1) {
        return &State::get<Run>();
    }

    if (event.button == ButtonPressed::LONG2) {
        return &State::get<RunMoveModeSelect>();
    }

    return nullptr;
}

Run::Run() {
    navigation = services::Navigation::instance();
    maze = services::Maze::instance();
    logger = services::Logger::instance();
}

void Run::enter() {
    bsp::buttons::enable(false);
    bsp::debug::print("state:Run");
    bsp::leds::indication_on();
    bsp::leds::stripe_set(Color::Red);
    bsp::leds::ir_emitter_all_on();
    bsp::analog_sensors::enable_modulation();

    bsp::buzzer::start();
    bsp::delay_ms(2000);
    bsp::buzzer::stop();

    bsp::delay_ms(250);
    
    soft_timer::start(1, soft_timer::CONTINUOUS);
    
    logger->init();
    
    maze->read_maze_from_memory(map_backup);
    // maze->print(maze->ORIGIN);
    const bool is_time_based = (move_mode == services::Navigation::TIME_BASED);
    target_directions = maze->directions_to_goal(is_time_based);
    // maze->print(maze->ORIGIN);

    services::Control::instance()->start_fan();
    bsp::delay_ms(200);
    target_movements.clear();
    
    target_movements = navigation->get_movements_to_goal(target_directions, move_mode);

    if (target_movements.size() < 2) {
        emergency = true;
        soft_timer::stop();
        bsp::motors::set(0, 0);
        bsp::fan::set(0);
        bsp::leds::stripe_set(Color::Orange);
        bsp::buzzer::start();
        bsp::delay_ms(500);
        bsp::buzzer::stop();
        bsp::buttons::enable(true);
        return;
    }

    move_count = 0;
    emergency = false;
    indicate_read = false;

    auto movement = target_movements[0].first;
    auto prev_movement = target_movements[0].first;
    auto next_movement = target_movements[1].first;
    auto next_movement_count = target_movements[1].second;

    navigation->set_movement(movement, prev_movement, next_movement, 1, next_movement_count);

    bsp::leds::stripe_set(Color::Black);
    bsp::delay_ms(250);
}

State* Run::react(ButtonPressed const& event) {
    if (event.button == ButtonPressed::SHORT1) {
        return &State::get<Idle>();
    }

    if (event.button == ButtonPressed::SHORT2) {
        return &State::get<Idle>();
    }

    if (event.button == ButtonPressed::LONG1) {
        return &State::get<Idle>();
    }

    if (event.button == ButtonPressed::LONG2) {
        return &State::get<Idle>();
    }

    return nullptr;
}

State* Run::react(BleCommand const&) {
    return nullptr;
}

State* Run::react(Timeout const&) {
    using bsp::analog_sensors::SensingDirection;

    navigation->update();

    if (indicate_read && std::abs(navigation->get_robot_travelled_dist_mm()) >= 90.0f) {
        bsp::leds::stripe_set(Color::Black);
        indicate_read = false;
    }

    bool done = navigation->step();

    logger->update();

    if (navigation->is_front_emergency() ||
        ((bsp::imu::is_imu_emergency() || services::Control::instance()->is_emergency()) && move_count >= 1)) {
        emergency = true;
        soft_timer::stop();
        bsp::motors::set(0, 0);
        bsp::fan::set(0);
        bsp::leds::stripe_set(Color::Orange);
        bsp::buzzer::start();
        bsp::delay_ms(500);
        bsp::buzzer::stop();
        return &State::get<Idle>();
    }

    if (done) {

        move_count++;
        if (move_count >= target_movements.size()) {
            return &State::get<Idle>();
        }

        indicate_read = true;
        bsp::leds::stripe_set(Color::Green);

        auto movement = target_movements[move_count].first;

        auto prev_movement = ((move_count) >= 1) ? target_movements[move_count - 1].first : Movement::STOP;

        auto next_movement =
            ((move_count + 1) < target_movements.size()) ? target_movements[move_count + 1].first : Movement::STOP;

        auto next_movement_count =
            ((move_count + 1) < target_movements.size()) ? target_movements[move_count + 1].second : 1;

        auto cells = target_movements[move_count].second;

        navigation->set_movement(movement, prev_movement, next_movement, cells, next_movement_count);
    }

    return nullptr;
}

void Run::exit() {
    soft_timer::stop();
    bsp::motors::set(0, 0);
    if (!emergency) {
        services::Control::instance()->stop_fan();
    }
    bsp::fan::set(0);
    bsp::leds::stripe_set(Color::Black);
    bsp::analog_sensors::enable_modulation(false);
    bsp::leds::ir_emitter_all_off();
    bsp::leds::indication_off();
    logger->save_size();
    bsp::buzzer::stop();
    bsp::buttons::enable(true);
}

}
