team-raiju/fujin/firmware/inc/services/logger.hpp

#pragma once

#include <cstdint>

namespace services {

#define CONTROL_LOG_MODE 0

enum class ParamIndex : uint8_t {
    VelocityMS,
    TargetVelocityMS,
    AngularSpeedRadS,
    TargetRadS,
    PwmLeft,
    PwmRight,
    EncoderImuDiff,
#if CONTROL_LOG_MODE
    VelP,
    VelI,
    AngP,
    AngI,
    RotationFF,
    LinearFF,
    Battery,
#else
    PositionX,
    PositionY,
    Angle,
    Distance,
    SensorDistanceLeft,
    SensorDistanceFrontLeft,
    SensorDistanceFrontRight,
    SensorDistanceRight,
#endif
    COUNT
};

class Logger {
public:
    union LogData {

        #if CONTROL_LOG_MODE
        uint8_t data[21];
        #else
        uint8_t data[24];
        #endif

        struct {
            uint16_t velocity_ms : 15;
            uint16_t target_velocity_ms : 15;

            uint16_t angular_speed_rad_s : 16;
            uint16_t target_rad_s : 16;

            uint16_t pwm_left : 10;
            uint16_t pwm_right : 10;
            uint16_t encoder_imu_diff : 10;

#if CONTROL_LOG_MODE
            uint16_t vel_p : 12;
            uint16_t vel_i : 12;
            uint16_t ang_p : 12;
            uint16_t ang_i : 12;
            uint16_t rotation_ff : 10;
            uint16_t linear_ff : 10;
            uint16_t battery : 8;
#else
            uint16_t position_mm_x : 16;
            uint16_t position_mm_y : 16;
            uint16_t angle : 14;
            uint16_t distance : 14;

            uint16_t sensor_distance_l : 10;
            uint16_t sensor_distance_fl : 10;
            uint16_t sensor_distance_fr : 10;
            uint16_t sensor_distance_r : 10;
#endif

        } __attribute__((packed)) fields;
    };

    #if CONTROL_LOG_MODE
    static_assert(sizeof(LogData) == 21, "LogData size must be exactly 21 bytes!");
    #else
    static_assert(sizeof(LogData) == 24, "LogData size must be exactly 24 bytes!");
    #endif


    struct ParamInfo {
        uint16_t max_store_value; // Max integer value for the bitfield (e.g., 4095 for 12 bits)
        float min_param_value;    // Min measured value
        float max_param_value;    // Max measured value
        float scale;              // Scale factor, calculated as: max_store_value / (max_param_value - min_param_value)
    };

    static Logger* instance();

    void init();
    void reset();
    void update();
    void save_size();
    void print_log();
    void send_log_ble();

    Logger(const Logger&) = delete;
    Logger& operator=(const Logger&) = delete;

private:
    Logger() {};

    float encode_value(float raw_value, const ParamInfo& info) const;
    float decode_value(float stored_value, const ParamInfo& info) const;

    LogData logdata[7];
    uint8_t log_data_idx;
    uint32_t addr_offset;
    uint8_t ram_logger[70000]; // Max log number is 80000 / sizeof(LogData)
};

}
