team-raiju/fujin/firmware/src/bsp/target-stm32g474/buzzer.cpp

#include "st/hal.h"

#include "bsp/buzzer.hpp"
#include "utils/math.hpp"
#include "bsp/timers.hpp"

namespace bsp::buzzer {

/// @section Constants

#define CPU_FREQUENCY (170000000UL) // SystemCoreClock
#define COUNTER_PERIOD (100)

/// @section Interface implementation

void init() {
    MX_TIM8_Init();
}

void start(void) {
    HAL_TIM_PWM_Start(&htim8, TIM_CHANNEL_1);
}

void stop(void) {
    HAL_TIM_PWM_Stop(&htim8, TIM_CHANNEL_1);
}

void set_volume(uint8_t volume) {
    static constexpr uint8_t max_volume = 100;
    volume = std::min(volume, max_volume);

    __HAL_TIM_SET_COMPARE(&htim8, TIM_CHANNEL_1, volume);
}

void set_frequency(uint16_t hz) {
    uint16_t preescaler_value = ((CPU_FREQUENCY / COUNTER_PERIOD) / hz) - 1;
    __HAL_TIM_SET_PRESCALER(&htim8, preescaler_value);
}

void beep(uint32_t duration_ms) {
    bsp::buzzer::start();
    bsp::delay_ms(duration_ms);
    bsp::buzzer::stop();
}
 
void beep_double(uint32_t first_ms, uint32_t gap_ms, uint32_t second_ms) {
    beep(first_ms);
    bsp::delay_ms(gap_ms);
    beep(second_ms);
}

} // namespace
