team-raiju/fujin/scripts/velocity_planner.py

import numpy as np
import matplotlib.pyplot as plt
import matplotlib
import math
import matplotlib.patches as patches
from matplotlib.ticker import MultipleLocator

matplotlib.use('TkAgg')

class Position:
    def __init__(self, x, y, theta):
        self.x = x
        self.y = y
        self.theta = theta


def plot_robot_positions(ideal_positions: Position, real_positions: Position):

    # Convert positions to numpy arrays for easier handling
    robot1 = np.array([(pos.x, pos.y) for pos in ideal_positions])
    robot2 = np.array([(pos.x, pos.y) for pos in real_positions])
    
    # Create figure and axis
    plt.figure(figsize=(10, 8))
    
    # Plot trajectories
    plt.plot(robot1[:, 0], robot1[:, 1], 'b-', label='Ideal Path')
    plt.plot(robot2[:, 0], robot2[:, 1], 'r-', label='Real Path')
    
    # Set axis limits
    # plt.xlim(-90, 2700+360)
    # plt.ylim(-2790, 360)

    plt.xlim(-90, 540)
    plt.ylim(-90, 540)


     # Add micromouse grid
    ax = plt.gca()
    ax.xaxis.set_major_locator(MultipleLocator(180))
    ax.yaxis.set_major_locator(MultipleLocator(180))
    ax.set_aspect('equal')
    plt.grid(color='gray', linestyle='--', linewidth=0.5)

     # Add micromouse walls
    plt.plot([0, 0], [0, 180], 'g-', linewidth=3)
    plt.plot([0, 0], [0, -180], 'g-', linewidth=3)
    plt.plot([0, 180], [180, 180], 'g-', linewidth=3)
    plt.plot([180, 180], [0, -180], 'g-', linewidth=3)

    ## Discomment to add 45deg ladder pattern
    # for i in range (0, 7200, 180):
    #     plt.plot([i, i], [i, i + 180], 'g-', linewidth=3)
    #     plt.plot([i, i + 180], [i + 180, i + 180], 'g-', linewidth=3)
        
    #     plt.plot([i + 180, i + 360], [i, i], 'g-', linewidth=3)
    #     plt.plot([i + 360, i + 360], [i, i + 180], 'g-', linewidth=3)
    
    ## Discomment to add 135deg ladder pattern
    plt.plot([180, 360], [180, 180], 'g-', linewidth=3)
    plt.plot([360, 360], [180, 0], 'g-', linewidth=3)
    plt.plot([360, 540], [0, 0], 'g-', linewidth=3)

    for i in range (180, 3600, 180):
        plt.plot([i, i], [180 - i, -i], 'g-', linewidth=3)
        plt.plot([i, i + 180], [-i, -i], 'g-', linewidth=3)

        plt.plot([i + 360, i + 360], [180 - i, -i], 'g-', linewidth=3)
        plt.plot([i + 360, i + 360 + 180], [-i, -i], 'g-', linewidth=3)


    # Add labels and legend
    plt.xlabel('X Position')
    plt.ylabel('Y Position')
    plt.title('Robot Positions Over Time')
    plt.legend()
    plt.grid(True)
    plt.show()

def plot_angular_speeds(ideal_speeds, real_speeds):

    # Create figure and axis
    plt.figure(figsize=(10, 8))
    
    # Plot angular speeds
    plt.plot(ideal_speeds, 'b-', label='Ideal Angular Speed')
    plt.plot(real_speeds, 'r-', label='Real Angular Speed')
    
    # Add labels and legend
    plt.xlabel('Time (ms)')
    plt.ylabel('Angular Speed (rad/s)')
    plt.title('Angular Speeds Over Time')
    plt.legend()
    plt.grid(True)
    plt.show()

def main():

    #### Inputs (Strictly in Radians and standard SI/Metric prefixes) ####
    linear_speed_m_s = 0.5
    turn_angle_degree = 90
    turn_angle_rad = np.radians(turn_angle_degree)
    turn_radius_mm = 30

    angular_acceleration_rad_s2 = 104.71975
    angular_desacceleration_rad_s2 = 104.71975
    maximum_angular_speed_rad_s = 10.47197

    mm_before_turn = 0
    mm_after_turn = 4.1
    initial_theta_rad = 0.0

    #### Units conversion ####
    turn_radius_m = turn_radius_mm / 1000


    #### Ideal outputs ####
    total_ideal_time_ms = ((turn_angle_rad * turn_radius_m) / linear_speed_m_s) * 1000
    ideal_angular_speed_rad_s = (turn_angle_rad / total_ideal_time_ms) * 1000
    ideal_angular_speed_deg_s = np.rad2deg(ideal_angular_speed_rad_s)
    angle_area_rad = ideal_angular_speed_rad_s * (total_ideal_time_ms / 1000) # = turn_angle_rad

    print("Total ideal time (ms): {:.2f}".format(total_ideal_time_ms))
    print("Ideal angular speed (rad/s): {:.2f} (={:.2f} deg/s)".format(ideal_angular_speed_rad_s, ideal_angular_speed_deg_s))
    print("")


    #### Real outputs ####
    t1_ms = (maximum_angular_speed_rad_s / angular_acceleration_rad_s2) * 1000
    t3_ms = (maximum_angular_speed_rad_s / angular_desacceleration_rad_s2) * 1000
    t2_ms = (angle_area_rad / maximum_angular_speed_rad_s) * 1000 - (t1_ms / 2) - (t3_ms / 2)

    if (t2_ms < 0):
        t2_ms = 0
        t1_ms = math.sqrt((2*angle_area_rad) / ((1 + angular_acceleration_rad_s2 / angular_desacceleration_rad_s2) * angular_acceleration_rad_s2)) * 1000
        t3_ms = t1_ms * (angular_acceleration_rad_s2 / angular_desacceleration_rad_s2)


    T_ms = t1_ms + t2_ms + t3_ms

    print("Max angular speed (rad/s): ", maximum_angular_speed_rad_s, " (=", np.rad2deg(maximum_angular_speed_rad_s), "deg/s)")
    print("Acceleration (rad/s^2): ", angular_acceleration_rad_s2, " (=", np.rad2deg(angular_acceleration_rad_s2), "deg/s^2)")
    print("Deceleration (rad/s^2): ", angular_desacceleration_rad_s2, " (=", np.rad2deg(angular_desacceleration_rad_s2), "deg/s^2)")
    print("t1 (ms): ", round(t1_ms))
    print("t2 (ms): ", round(t2_ms))
    print("t3 (ms): ", round(t3_ms))
    print("T (ms) : ", round(T_ms))
    print("")

    #### Calculated real angles:
    angle_until_max_speed = (1 / 2) * angular_acceleration_rad_s2 * (t1_ms / 1000)**2
    angle_until_start_deceleration = angle_until_max_speed + (maximum_angular_speed_rad_s * (t2_ms / 1000))
    angle_final = turn_angle_rad

    print(f"Angle until max speed (deg) : {0:.3f} to {np.rad2deg(angle_until_max_speed):.3f}")
    print(f"Angle on max speed (deg)    : {np.rad2deg(angle_until_max_speed):.3f} to {np.rad2deg(angle_until_start_deceleration):.3f}")
    print(f"Final angle (deg)           : {np.rad2deg(angle_until_start_deceleration):.3f} to {np.rad2deg(angle_final):.3f}")
    print("")

    print(f"Angle until max speed (rad) : {0:.3f} to {angle_until_max_speed:.3f}")
    print(f"Angle on max speed (rad)    : {angle_until_max_speed:.3f} to {angle_until_start_deceleration:.3f}")
    print(f"Final angle (rad)           : {angle_until_start_deceleration:.3f} to {angle_final:.3f}")
    print("")


    #### Calculate Ideal Positions ####
    ideal_positions = [
        Position(90 + mm_before_turn * np.sin(initial_theta_rad), 
                 mm_before_turn * np.cos(initial_theta_rad), 
                  initial_theta_rad)
    ]
    ideal_ang_speeds = [0.0]

    for t in range(1, int(total_ideal_time_ms) + 1):
        theta = ideal_positions[t - 1].theta

        if t < total_ideal_time_ms:
            angular_speed_rad_s = ideal_angular_speed_rad_s
            theta = ideal_positions[t - 1].theta + (angular_speed_rad_s / 1000)
        else:
            angular_speed_rad_s = 0
            theta = ideal_positions[0].theta + turn_angle_rad

        linear_speed_mm_ms = linear_speed_m_s * 1000 / 1000

        x = ideal_positions[t - 1].x + linear_speed_mm_ms * np.sin(theta) 
        y = ideal_positions[t - 1].y + linear_speed_mm_ms * np.cos(theta)

        ideal_positions.append(Position(x, y, theta))
        ideal_ang_speeds.append(angular_speed_rad_s)
        # print("t: ", t, "x: ", x, " y: ", y, " theta: ", theta * 180 / np.pi)
    

    #### Calculate Real Positions ####
    angular_speed_rad_s = 0
    real_ang_speeds = [0.0]
    real_positions = [
        Position(90 + mm_before_turn * np.sin(initial_theta_rad), 
                  mm_before_turn * np.cos(initial_theta_rad), 
                  initial_theta_rad)
    ]

    for t in range(1, round(T_ms + 1)):
        if t <= t1_ms:
            angular_speed_rad_s += angular_acceleration_rad_s2 / 1000
        elif t <= t1_ms + t2_ms:
            angular_speed_rad_s = angular_speed_rad_s # Do nothing
        elif t <= T_ms:
            angular_speed_rad_s -= angular_desacceleration_rad_s2 / 1000
        else:
            angular_speed_rad_s -= angular_desacceleration_rad_s2 / 1000

        if (angular_speed_rad_s > maximum_angular_speed_rad_s):
            angular_speed_rad_s = maximum_angular_speed_rad_s
        elif (angular_speed_rad_s < 0):
            angular_speed_rad_s = 0
        
        if (t == round(t1_ms)):
            print(f"Reached max angular speed at t = {t} ms and angle = {np.rad2deg(real_positions[-1].theta):.3f} deg -> {real_positions[-1].theta:.3f} rad")
        elif (t == round(t1_ms + t2_ms)):
            print(f"Started deceleration at t = {t} ms and angle = {np.rad2deg(real_positions[-1].theta):.3f} deg -> {real_positions[-1].theta:.3f} rad")

        theta = real_positions[t - 1].theta + (angular_speed_rad_s / 1000)
        linear_speed_mm_ms = linear_speed_m_s * 1000 / 1000

        x = real_positions[t - 1].x + linear_speed_mm_ms * np.sin(theta) 
        y = real_positions[t - 1].y + linear_speed_mm_ms * np.cos(theta)

        real_positions.append(Position(x, y, theta))
        real_ang_speeds.append(angular_speed_rad_s)
        # print("t: ", t, "x: ", x, "y: ", y, " angular_speed_rad_s: ", angular_speed_rad_s, " theta: ", theta * 180 / np.pi)

    print(f"Final Real Position: {real_positions[-1].x:.3f}, {real_positions[-1].y:.3f}, {np.rad2deg(real_positions[-1].theta):.3f}")


    #### Manually add the mm_after_turn ####
    last_x = ideal_positions[-1].x + mm_after_turn * np.sin(turn_angle_rad + ideal_positions[0].theta)
    last_y = ideal_positions[-1].y + mm_after_turn * np.cos(turn_angle_rad + ideal_positions[0].theta)
    ideal_ang_speeds.append(0.0)
    ideal_positions.append(Position(last_x, last_y, turn_angle_rad + ideal_positions[0].theta))

    last_x = real_positions[-1].x + mm_after_turn * np.sin(real_positions[-1].theta) 
    last_y = real_positions[-1].y + mm_after_turn * np.cos(real_positions[-1].theta)
    real_positions.append(Position(last_x, last_y, real_positions[-1].theta))

    # Plot the positions
    plot_robot_positions(ideal_positions, real_positions)
    plot_angular_speeds(ideal_ang_speeds, real_ang_speeds)

if __name__ == "__main__":
    main()
