team-raiju/fujin/firmware/inc/utils/movement_params.hpp

#pragma once
#include "types.hpp"
#include <array>
#include <cstdint>
#include <map>

#ifndef COMPETITION_MODE
#define COMPETITION_MODE 0
#endif

static constexpr float CELL_SIZE_MM = 180.0;
static constexpr float HALF_CELL_SIZE_MM = 90.0;
static constexpr float CELL_DIAGONAL_SIZE_MM = 127.27922;

#if COMPETITION_MODE
static constexpr float ROBOT_DIST_FROM_CENTER_START_MM = 14.5;
static constexpr float ROBOT_DIST_FROM_CENTER_START_MM_FAST = 14.5;
static constexpr float STOP_EXTRA_TRAVEL_MM = HALF_CELL_SIZE_MM;
#else
static constexpr float ROBOT_DIST_FROM_CENTER_START_MM = 14.5;  // Actually 14.5 with 6mm wall, and 14.5mm with 12mm wall
static constexpr float ROBOT_DIST_FROM_CENTER_START_MM_FAST = 14.5; // To account for slippery when fast mode this can be adjusted
static constexpr float STOP_EXTRA_TRAVEL_MM = 0.0;
#endif

/**
 * @struct TurnParams
 * @brief Parameters for defining a turn movement.
 *
 *
 * @param start Where the movement begins in relation to the start of the cell [mm] (can be negative (before the cell
 * begin) or positive (after the cell begin))
 * @param end Where the movement ends in relation to the start of the cell [mm] (can be negative (before the cell begin)
 * or positive (after the cell begin))
 * @param turn_linear_speed The linear speed during the turn in [m/s]
 * @param angular_accel The angular acceleration during the turn in [rad/s^2]
 * @param max_angular_speed The maximum angular speed during the turn in [rad/s]
 * @param t_start_deccel The time elapsed when deceleration is going to start [control ticks]
 * @param t_stop The time elapsed when curve is going to stop [control ticks]
 * @param sign The direction sign of the turn (positive = LEFT or negative = RIGHT).
 * @param time_to_decrease_jerk_1 Time to decrease jerk 1 in [control ticks]
 * @param time_to_decrease_jerk_2 Time to decrease jerk 2 in [control ticks]
 * @param accel_ramp_up_jerk Jerk limit while angular acceleration ramps up
 * @param accel_ramp_down_jerk Jerk limit while angular acceleration ramps down
 *
 */
struct TurnParams {
    float start;
    float end;
    float turn_linear_speed;
    float angular_accel;
    float max_angular_speed;
    uint16_t t_start_deccel;
    uint16_t t_stop;
    int sign;
    uint16_t time_to_decrease_jerk_1;
    uint16_t time_to_decrease_jerk_2;
    float accel_ramp_up_jerk;
    float accel_ramp_down_jerk;

    constexpr TurnParams()
        : start(0), end(0), turn_linear_speed(0), angular_accel(0), max_angular_speed(0),
          t_start_deccel(0), t_stop(0), sign(0), time_to_decrease_jerk_1(0), time_to_decrease_jerk_2(0),
          accel_ramp_up_jerk(0), accel_ramp_down_jerk(0) {}

    constexpr TurnParams(float s, float e, float ls, float aa, float mas, uint16_t tsd, uint16_t ts,
                         int sg, uint16_t t_j1 = 0, uint16_t t_j2 = 0, float ramp_up_jerk = 0.0f,
                         float ramp_down_jerk = 0.0f) noexcept
        : start(s), end(e), turn_linear_speed(ls), angular_accel(aa), max_angular_speed(mas),
          t_start_deccel(tsd), t_stop(ts), sign(sg), time_to_decrease_jerk_1(t_j1), time_to_decrease_jerk_2(t_j2),
          accel_ramp_up_jerk(ramp_up_jerk), accel_ramp_down_jerk(ramp_down_jerk) {}
};

/**
 * @struct ForwardParams
 * @brief Parameters for defining a forward movement.
 *
 *
 * @param max_speed The maximum speed of the robot in [m/s]
 * @param acceleration The acceleration of the robot in [m/s^2]
 * @param deceleration The deceleration of the robot in [m/s^2]
 * @param target_travel_mm The distance the robot should travel in [mm]
 */
struct ForwardParams {
    float max_speed;
    float acceleration;
    float deceleration;
    float target_travel_mm;

    ForwardParams() : max_speed(0), acceleration(0), deceleration(0), target_travel_mm(0) {}

    ForwardParams(float ms, float a, float d, float t) noexcept
        : max_speed(ms), acceleration(a), deceleration(d), target_travel_mm(t) {}
};

struct GeneralParams {
    float fan_speed;

    float angular_kp;
    float angular_ki;
    float angular_kd;
    float angular_acc_feed_forward_k;
    float angular_brake_feed_forward_k;
    float angular_vel_feed_forward_k;

    float linear_vel_acc_feed_forward_k;
    float linear_vel_brake_feed_forward_k;
    float linear_vel_feed_forward_k;

    float wall_kp;
    float wall_ki;
    float wall_kd;

    float linear_vel_kp;
    float linear_vel_ki;
    float linear_vel_kd;

    float diagonal_walls_kp;
    float diagonal_walls_ki;
    float diagonal_walls_kd;

    float start_wall_break_mm_left;
    float start_wall_break_mm_right;
    float enable_wall_break_correction;
    float max_linear_acc_jerk;
    float max_linear_brake_jerk;
    float wheel_radius_mm;
    float coulomb_ff;
    float angular_coulomb_ff;
    float angular_static_ff;
    float angular_coulomb_ff_inplace;
    float angular_static_ff_inplace;
    float linear_accel_margin_mm;
    float linear_brake_margin_mm;
    float sensor_r_slope_max_th;
    float sensor_l_slope_max_th;
    float ir_wall_detect_th_left;
    float ir_wall_detect_th_right;
    float enable_lateral_correction_90;
    float enable_lateral_correction_wall;

    GeneralParams()
        : fan_speed(0), angular_kp(0), angular_ki(0), angular_kd(0), angular_acc_feed_forward_k(0),
          angular_brake_feed_forward_k(0), angular_vel_feed_forward_k(0), linear_vel_acc_feed_forward_k(0),
          linear_vel_brake_feed_forward_k(0), linear_vel_feed_forward_k(0),
          wall_kp(0), wall_ki(0), wall_kd(0),
          linear_vel_kp(0), linear_vel_ki(0), linear_vel_kd(0), diagonal_walls_kp(0), diagonal_walls_ki(0),
          diagonal_walls_kd(0), start_wall_break_mm_left(0), start_wall_break_mm_right(0),
          enable_wall_break_correction(0), max_linear_acc_jerk(0), max_linear_brake_jerk(0),
          wheel_radius_mm(0), coulomb_ff(0),
          angular_coulomb_ff(0), angular_static_ff(0),
          angular_coulomb_ff_inplace(0), angular_static_ff_inplace(0),
          linear_accel_margin_mm(10.0f), linear_brake_margin_mm(10.0f),
          sensor_r_slope_max_th(0.0f), sensor_l_slope_max_th(0.0f),
          ir_wall_detect_th_left(240.0f), ir_wall_detect_th_right(240.0f),
          enable_lateral_correction_90(1.0f), enable_lateral_correction_wall(1.0f) {}

    GeneralParams(float fan, float akp, float aki, float akd, float aaff, float abff, float avff, float lvaff, float lvbff, float lvff, float wkp, float wki,
                  float wkd, float lvkp, float lvki, float lvkd, float dwkp, float dwki, float dwkd, float swbcl,
                  float swbcr, float ewbc, float mlaj, float mlbj, float wr, float c_ff, float angular_c_ff, float angular_s_ff,
                  float angular_c_ff_inplace = 0.0f, float angular_s_ff_inplace = 0.0f,
                  float linear_accel_margin = 10.0f, float linear_brake_margin = 10.0f,
                  float r_slope_max_th = 0.0f, float l_slope_max_th = 0.0f,
                  float wall_detect_th_left = 240.0f, float wall_detect_th_right = 240.0f,
                  float lat_corr_90 = 1.0f, float lat_corr_wall = 1.0f)
        : fan_speed(fan), angular_kp(akp), angular_ki(aki), angular_kd(akd), angular_acc_feed_forward_k(aaff),
          angular_brake_feed_forward_k(abff),
          angular_vel_feed_forward_k(avff), linear_vel_acc_feed_forward_k(lvaff), linear_vel_brake_feed_forward_k(lvbff),
          linear_vel_feed_forward_k(lvff),
          wall_kp(wkp), wall_ki(wki),
          wall_kd(wkd), linear_vel_kp(lvkp), linear_vel_ki(lvki), linear_vel_kd(lvkd), diagonal_walls_kp(dwkp),
          diagonal_walls_ki(dwki), diagonal_walls_kd(dwkd), start_wall_break_mm_left(swbcl),
          start_wall_break_mm_right(swbcr), enable_wall_break_correction(ewbc),
          max_linear_acc_jerk(mlaj), max_linear_brake_jerk(mlbj), wheel_radius_mm(wr), coulomb_ff(c_ff),
          angular_coulomb_ff(angular_c_ff), angular_static_ff(angular_s_ff),
          angular_coulomb_ff_inplace(angular_c_ff_inplace), angular_static_ff_inplace(angular_s_ff_inplace),
          linear_accel_margin_mm(linear_accel_margin), linear_brake_margin_mm(linear_brake_margin),
          sensor_r_slope_max_th(r_slope_max_th), sensor_l_slope_max_th(l_slope_max_th),
          ir_wall_detect_th_left(wall_detect_th_left), ir_wall_detect_th_right(wall_detect_th_right),
          enable_lateral_correction_90(lat_corr_90), enable_lateral_correction_wall(lat_corr_wall) {}
};

extern const std::array<TurnParams, MOVEMENT_COUNT> turn_params_search_slow;
extern const std::array<ForwardParams, MOVEMENT_COUNT> forward_params_search_slow;
extern const std::array<TurnParams, MOVEMENT_COUNT> turn_params_search_medium;
extern const std::array<ForwardParams, MOVEMENT_COUNT> forward_params_search_medium;
extern const std::array<TurnParams, MOVEMENT_COUNT> turn_params_search_fast;
extern const std::array<ForwardParams, MOVEMENT_COUNT> forward_params_search_fast;
extern const std::array<TurnParams, MOVEMENT_COUNT> turn_params_slow;
extern const std::array<ForwardParams, MOVEMENT_COUNT> forward_params_slow;
extern const std::array<TurnParams, MOVEMENT_COUNT> turn_params_medium;
extern const std::array<ForwardParams, MOVEMENT_COUNT> forward_params_medium;
extern const std::array<TurnParams, MOVEMENT_COUNT> turn_params_fast;
extern const std::array<ForwardParams, MOVEMENT_COUNT> forward_params_fast;
extern const std::array<TurnParams, MOVEMENT_COUNT> turn_params_super;
extern const std::array<ForwardParams, MOVEMENT_COUNT> forward_params_super;
extern std::array<TurnParams, MOVEMENT_COUNT> turn_params_custom;
extern std::array<ForwardParams, MOVEMENT_COUNT> forward_params_custom;
extern const GeneralParams general_params_search_slow;
extern const GeneralParams general_params_search_medium;
extern const GeneralParams general_params_search_fast;
extern const GeneralParams general_params_slow;
extern const GeneralParams general_params_medium;
extern const GeneralParams general_params_fast;
extern const GeneralParams general_params_super;

enum navigation_mode_t : uint8_t {
    SEARCH_SLOW = 0,
    SEARCH_MEDIUM = 1,
    SEARCH_FAST = 2,
    SLOW = 3,
    MEDIUM = 4,
    FAST = 5,
    SUPER = 6,
    CUSTOM = 7,
};

const std::array<TurnParams, MOVEMENT_COUNT>& get_turn_params(navigation_mode_t mode);
const std::array<ForwardParams, MOVEMENT_COUNT>& get_forward_params(navigation_mode_t mode);
const GeneralParams& get_general_params(navigation_mode_t mode);
bool load_movement_preset_to_custom(navigation_mode_t preset);
