team-raiju/fujin/(commit log)

2024-06-06 Add boards folder
2024-06-07 Start fujin schmatics
    [FujinLib.SchLib, Fujin_Main.SchDoc, Fujin_Motors.SchDoc, Fujin_Peripherals.SchDoc, Fujin_V1.PrjPcb]
2024-06-07 Add IR sensor
    [FujinLib.SchLib, Fujin_Peripherals.SchDoc]
2024-06-08 Add more components
    [FujinLib.SchLib, Fujin_Main.SchDoc, Fujin_Motors.SchDoc, Fujin_Peripherals.SchDoc]
2024-06-09 Add battery and encoder
    [FujinLib.SchLib, Fujin_Body.PcbDoc, Fujin_Main.SchDoc, Fujin_Motors.SchDoc, Fujin_Peripherals.SchDoc, Fujin_V1.PrjPcb]
2024-06-12 Add regulator and usb
    [FujinLib.SchLib, Fujin_Connectors.SchDoc, Fujin_Main.SchDoc, Fujin_Motors.SchDoc, Fujin_Peripherals.SchDoc, Fujin_V1.PrjPcb]
2024-06-13 Add cubemx pins on altium
    [FujinLib.SchLib, Fujin_Connectors.SchDoc, Fujin_Main.SchDoc, Fujin_Motors.SchDoc, Fujin_Peripherals.SchDoc, Fujin_V1.PrjPcb]
2024-06-14 Update pcb
    [FujinLib.SchLib, Fujin_Connectors.SchDoc, Fujin_Main.SchDoc, Fujin_Motors.SchDoc, Fujin_Peripherals.SchDoc, Fujin_V1.PrjPcb]
2024-06-15 PCB updates
    [FujinLib.SchLib, Fujin_Main.SchDoc, Fujin_Motors.SchDoc]
2024-06-15 Finished v0 component placement
    [Fujin_Main.SchDoc]
2024-06-17 Start routing
    [Fujin_Main.SchDoc]
2024-06-18 Finish routing v0
    [FujinLib.SchLib, Fujin_Main.SchDoc, Fujin_Motors.SchDoc, Fujin_V1.PrjPcb]
2024-06-19 Improve layout
    [FujinLib.SchLib, Fujin_Body.DWG, Fujin_Body_2.DWG, Fujin_Body_4.DXF, Fujin_Peripherals.SchDoc]
2024-06-20 Finished boards
    [EncoderLib.PcbLib, EncoderLib.SchLib, Fujin_Encoder.PcbDoc, Fujin_Encoder.PrjPcb, Fujin_Encoder.SchDoc, Fujin_Encoder.step]
2024-06-21 Add production files
    [Fujin_V1.PrjPcb]
2024-08-08 Enable gpio interrupts and add button pull up
2024-08-08 Add bsp fan
2024-08-12 Update AS5047P driver
2024-08-13 Update as5047 driver
2024-08-13 Fix led ir mapping
2024-08-16 Fix sensor R_S adc channel
    [fujin.ioc]
2024-08-29 Update schematics pdf
2024-09-01 Disable encoder pin B interrupt
2024-09-18 Remove compilation warnings on STM32
2024-09-18 Fix button 2 interrupt
2024-09-18 Add printf interrupt to stm32
2024-09-24 imu: create bsp
2024-09-24 imu: fix angle ranges
    [imu.cpp]
2024-09-24 Add print float
2024-09-24 FIx ir sensors
2024-09-24 Remove systick auto gen interrupt
2024-09-24 Add soft timer event
2024-09-24 Fix systick interrupt
2024-09-25 encoder: add bsp and device
2024-09-26 Add buttons to ble
2024-09-26 Fix ble and position
    [core.cpp, encoders.cpp, main.cpp]
2024-09-26 Add pid class
2024-09-28 Add SensingDirection enum and functions for IR sensor readings
2024-09-30 Remove <print>
2024-10-02 Increase encoder interru priority
2024-10-03 Calibrate wall pid
2024-10-04 Calibrate turn movements
2024-10-04 Fix flood fill height
    [flood_fill.hpp, maze.hpp]
2024-10-05 Calibrate navigation
2024-10-05 notification: send sensors and battery
2024-10-08 Fix max param value
    [config.cpp]
2024-10-10 Improve navigation
    [params.txt]
2024-10-13 add calib state and average to sensors
2024-12-19 Refactor navigation step logic, including velocity control
2024-12-19 Update paramst.txt with robochallenge data
    [params.txt]
2024-12-20 Add linear velocity config param
2024-12-28 Add velocity planner script
2024-12-28 Enhance velocity planner with angular speed plotting and improved output formatting
2024-12-30 Improve velocity and angle control
2024-12-31 Fix turn 180 and enable wall sensors
    [control.cpp, logger.hpp, navigation.cpp, run.cpp]
2025-01-02 Improve velocity_planner
2025-01-06 Add diagonal PID
2025-01-06 Add movement start and imu emergency stop
2025-01-08 Adjust medium parameters
    [params.txt]
2025-01-08 Adjust params slow txt
    [params.txt]
2025-01-19 Add back emf to PID control
    [params.txt]
2025-01-29 Prevent pwm overflow
2025-03-03 Small adjusts
    [params.txt]
2025-03-05 Increase motor pwm frequency to 85Khz
2025-03-08 Update encoders functions
2025-03-09 Add fan to ble
2025-03-09 Log pid integral
    [params.txt]
2025-03-09 Imu emergency + better control of when move sequency starts
    [params.txt]
2025-03-10 More calibration params
2025-03-11 Calibration of fast parameters checkpoint
    [params.txt]
2025-04-11 Add all japan 45 map movements
    [params.txt]
2025-04-13 Improve imu emergency
    [params.txt]
2025-08-29 Add fix distance function
    [navigation.cpp, navigation.hpp]
2025-08-29 Fix diagonal path generator
    [navigation.cpp, navigation.hpp]
2025-09-01 Turn by angle
    [params.txt]
2025-09-02 Improve moevements
    [params.txt]
2025-09-02 Add imu calibration
2025-09-02 Add reset method and min turn speed
    [maze.cpp, maze.hpp, navigation.cpp]
2025-09-04 Add wall control when exiting curve on search
    [params.txt]
2025-09-12 Calibrate more movements
2025-09-14 Enable wall correction
    [params.txt]
2025-09-15 Add fan calibration
2025-09-16 Improve build, add inplace 180 and new calibration
    [params.txt]
2025-09-16 Add print map to idle
    [params.txt]
2025-09-16 Calibrate search fast
    [params.txt]
2025-09-17 Add control error check
    [params.txt]
2025-09-19 Start calibrating high speed
    [params.txt]
2025-09-22 Improve params
    [params.txt]
2025-09-25 Add pre defined params
    [params.txt]
2025-09-25 Fix pre defined params
    [config.cpp, config.hpp, control.cpp, movement_params.hpp, navigation.cpp, run.cpp]
2025-09-27 Fix turn 90 moves
    [config.cpp, movement_params.hpp, navigation.cpp, run.cpp]
2025-09-27 Calibrate 90 and 180 fast
2025-09-27 Add final calibration for fast
2025-09-28 Start Calibrating medium params
2025-09-28 Calibrate medium speed
2025-09-30 Fix search mode
    [params.txt]
2025-10-01 Fix distance when in search mode
    [control.cpp, maze.cpp, navigation.cpp, navigation.hpp]
2025-10-01 Calibrate search slow
    [params.txt]
2025-10-02 Calibrate medium params
    [params.txt]
2025-10-04 Upddate prams
    [params.txt]
2025-10-15 Save robochallenge 2025 params
    [params.txt]
2026-03-29 Increase FAN Frequency to 42.5kHz and update cube to 6.13
2026-07-05 Add calibration motors mode
    [params.txt]
2026-07-05 Impro logger and improve slow param
    [params.txt]
2026-07-07 Add imu diff to logs
2026-07-07 Improve some params
    [params.txt]
2026-07-09 Add jerk and linear velocity feed foward
2026-07-12 Change centimeters to milimiters on the code
    [params.txt]
2026-09-07 Add a new filter for linear velocity
2026-09-07 Velocity filter depedent on target aceleration
2026-09-07 add get raw imu function
2026-09-07 Add jerk and wheel size and coulopmb ff as configurable params
2026-09-08 Start calibrating linear velocity with fan
2026-09-09 Add velocity to simulation bench
2026-09-12 Add new parameters to increase angular velocity control
2026-09-12 Update calibrated params
2026-09-13 Add sensor ir fit data and increase sampling frequency of sensor
2026-09-14 Add analog sensors distance
2026-09-14 Add sensor calibration state
2026-09-14 Add wall calibration mode
2026-09-15 Change everywhere to use ir sensor mm distance
2026-09-18 Use ir slope, fix seamless start
    [analog_sensors.cpp, logger.cpp, navigation.cpp, navigation.hpp, plot_ir_sensors.py, search.cpp]
2026-09-18 Update some config params
    [params.txt]
2026-09-19 Add new params wall correction
    [config.cpp, config.hpp, navigation.cpp, navigation.hpp, run.cpp]
2026-09-19 Enable param send on calib sensors
2026-09-20 fix: ir calibration
2026-09-21 Change sensor max to 270
2026-09-22 Improve slow calibration
2026-09-22 Fix wall brake
2026-09-26 Update calibration params
2026-10-01 Improve search mode corections. And calibrate search slow
2026-10-03 Start calibrating super mode
2026-10-04 Enable and disable button
2026-10-04 Save params
    [params.txt]
2026-10-04 Fix bug on wall break error threshold
    [navigation.cpp, plot_ir_sensors.py]
2026-10-04 Decrease to 30mm the maximum wall break correction
    [navigation.cpp]
2026-10-10 Change max control error on competition mode
    [control.cpp]
2026-10-12 Add sensor slope defined for each velocity
2026-10-12 Calibrate search medium
2026-10-17 Add missing file for sensor th
